kubeworkz/grx930/c930/doc/npu_act_stage_design_note.md

# S_ACT: an activation stage in the c930 NPU

**Status: RTL through gate A2** (§6). `rtl/c930_npu_act.sv` and the S_ACT state
in `rtl/c930_npu_core.sv`, driven directly by `sim/tb_core_verilator.cc` and tied
off in `c930_npu_top`. Next is chain mode, gate A3. No DMA, CSR or firmware
change until A3 has reported.
**Date:** September 2026
**Built against:** the loop-interchange core, now on main (§2 is why that
matters).
**Companions:** grxcp `docs/designs/pta_tpaqcn_review.md` §4.5–6 (why this
experiment exists, and its kill criterion); grxcp
`docs/designs/pta_cpu_integration.md` §3–4 (the CSR plan, the error model, the
determinism rule).

---

## 1. What it is for

One question: **how many all-optical activations can be chained before a
network's output diverges from its digital reference**, as a function of the
photons each activation carries and of fabrication detuning.

That number is the reset interval N, and it bounds everything an all-optical
activation could ever win. With an O-E-O reset every N layers, a layer costs
`E_opt + E_OEO / N`, so the advantage over any O-E-O path is at most N however
cheap the optics get (review §5.2). Nobody has measured N for any material.

It needs no photonics. In emulation an activation is a numerics block: a
transfer curve from the coupled-mode solver, the shot noise its light carries,
a per-unit detuning, and an optional requantisation standing in for the O-E-O
reset. The curve and the noise are hypotheses about published devices; nothing
this stage produces is a statement about one, exactly as
`pta_cpu_integration.md` says of the tile.

---

## 2. Where it goes, and why not where the review put it

The review places S_ACT "between S_WRITE and the next output row". Under the
loop order about to land, that is wrong on every K tile but the last:

```
for nt:                         N tile
  for kt:                       K tile
    S_WLOAD                     load B[kt][nt] once
    for m:                      output row, innermost
      S_AROW / S_ACCLD          wait for A[m]; acc[] <- C[m][nt] when kt > 0
      S_RUN                     accumulate this K tile
      S_WRITE                   C[m][nt] <- acc[]     a partial sum unless kt is last
```

`c_mem` carries the running K accumulation between K tiles, and `S_ACCLD`
restores it before each run. `C[m][nt]` is a complete sum only when `S_WRITE`
runs with `kt_reg == num_k_tiles - 1`. An activation applied any earlier is
applied to a partial sum.

So **S_ACT replaces S_WRITE on the last K tile**, when the stage is enabled:

```
S_RUN --[kt_reg != last  or  !act_en]--> S_WRITE    unchanged
S_RUN --[kt_reg == last  and  act_en]--> S_ACT  --> the row / tile advance S_WRITE performs
```

Three properties make that the right cut.

- **`acc[]` already holds the complete sums** when `S_RUN` exits; `S_WRITE`'s
  store is a plain copy of them. S_ACT reads `acc[]`, which is flops, so
  `c_mem` gains no read port and keeps the one-read, one-write shape the core's
  comment relies on for BRAM inference beside the DMA readback.
- **It writes through `S_WRITE`'s port to the same `c_idx`**, so the DMA's C
  writeback reads activated values with no DMA change at all.
- **With the stage disabled, the FSM is cycle-identical** to the staged core.
  That is gate A0.

Two details in `S_WRITE`'s exit that S_ACT has to inherit rather than
re-derive:

- On a row advance `S_WRITE` clears `acc[]` when `kt_reg == 0`. On a
  single-K-tile GEMM that tile is also the last, so the clear must run *after*
  S_ACT has consumed `acc[]`: the advance logic becomes one block shared by both
  states and runs at their exit.
- `done_cond` is keyed on `state == S_WRITE`. It needs an S_ACT term, or
  `o_done` never fires on an activated GEMM and the bench times out rather than
  failing.

---

## 3. The datapath

Per element, with `j = n_cnt` the physical column (`0 .. nc-1`):

```
stage 1   x  = sat( acc[j] * XS[j] >>> XSHIFT )      table domain; XS[j] = XSCALE * s_j
stage 2   σ  = k_shot * isqrt(|x|)                    shot-noise scale for this element
stage 3   x2 = x + σ * g                              g ~ N(0, 1)
stage 4   y[i], y[i+1] <- BRAM[i], BRAM[i+1]          i = x2's top 10 bits
stage 5   y  = y[i] + ((y[i+1] - y[i]) * f >>> 14)    f = x2's low 14 bits
stage 6   c  = requant ? sat(round(y*r_j / LSB_adc), 2^(B-1)) * LSB_adc : y*r_j
          C[m][n_base + j] <- sat32( c <<< YSHIFT )
```

At most one multiply per registered stage, six stages, with the write index
travelling alongside the data. **Two of them are split for timing, so the
implemented latency `ACT_P` is 8, not 6**: stage 2 into 2a (root and draw) and 2b
(the `k_shot` multiply), and stage 6 into 6a (the `r_j` multiply) and 6b
(requantise, scale, saturate). Both splits were made against a measured path,
not a guess — §5. `nc` elements enter on consecutive cycles, so S_ACT lasts
`nc + ACT_P` cycles per row: the element is registered on entry, and the last
sub-stage is the `c_mem` write itself. The output scale and the table's output full
scale are powers of two, so the output scale and `LSB_adc` both cost shifts. The
detuning's output factor `r_j` is applied before requantisation, because a real
reset digitises what the unit actually emits.

**The fixed point, as built.** The header of `rtl/c930_npu_act.sv` states the
contract, and the harness's `act_element()` implements it; gate A2 holds the two
to bitwise agreement. The choices the stages above leave open:

- `XS[j]` is unsigned, and the stage-1 product is the full 48 × 32 bits.
- `√` is `isqrt4`: a leading-zero count normalises `|x|` to [1, 4), and a
  four-entry table of `2^11·√1 … 2^11·√4` is interpolated on six fraction
  bits. It is within about 1.5 % of the true root, and a scale on shot noise
  needs no more.
- `g` is the sum of the four bytes of one xorshift32 step, less 510, times 443:
  that sum has a standard deviation of 147.8, and 443 / 2^16 brings it to
  0.999. One step per element. So stage 2 carries two small multiplies beside
  `k_shot · √`: the constant 443, and `isqrt4`'s 10 × 6-bit interpolation.
- Stage 3 rounds the noise (`+2^23`, then `>>> 24`); the interpolation and the
  `r_j` product floor; requantisation rounds half up; `YSHIFT` above 32 acts
  as 32. Stage 1, stage 3 and the 32-bit output saturate independently, and
  `o_act_sat_count` counts each event.

**The table.** 1024 uniform segments over the signed 24-bit input, 1025 signed
24-bit breakpoints at `x_i = -2^23 + i·2^14`, in one dual-port BRAM read at `i`
and `i+1` together. The difference needs 25 bits and the fraction 14, so
interpolation is one DSP48 multiply with the pre-adder forming the difference.
The shift floors. `c930/sim/act_table_gen.py`'s docstring is the normative
statement of the format, and its `pwl()` is the reference both the RTL and the C
model must match bit for bit.

The segment count was measured, not chosen. Chord error falls as 1/segments²,
so the generator compares its worst error within two knees against the shot
noise the unit carries there, and rejects a table whose error exceeds a quarter
of σ. Against that test, 64 segments are up to 17× too coarse, for the as-built
unit at a 1 ps clock. 256 still fail that unit (1.18×). 1024 pass every preset
at every clock, worst 0.08×, for the price of a RAMB36 of breakpoints instead of
a RAMB18. So piecewise-quadratic is not needed.

Written through an indirect port while the core is idle. One table per design
point: a curve from the solver — or later from the diffusion model — is data,
not RTL. The physics lives entirely in the generator: whether C is read as
optical power or as field amplitude, and whether the unit outputs the second
harmonic or the depleted fundamental.

**κ only sets the watt scale.** With full scale tied to the knee, the
coupled-mode equations depend on power only through `κ²P`. The generated tables
for the TPA-QCN and compound 4 units at 6 mm are therefore bit-identical, and a
curve's shape depends only on loss × length and mismatch × length. κ reaches the
experiment through one place: the photon count at the knee.

**Detuning.** Physical, so indexed by `j`, not by output index: N tiles reuse
the same columns, and a real tile reuses the same activation units. To first
order a phase-matching detuning scales the efficiency, `η → s·η`, and the
coupled-mode equations then give exactly `f_s(x) = f(s·x) / s` for either
output, loss included (scale the field amplitudes by `√s` and they return to the
nominal equations). Hence `s_j` on the input axis and `r_j = 1/s_j` on the
output, in the table's own encoding — for a field-amplitude table the harness
loads `√s` and `1/√s`. The harness folds `s_j` into the per-column input scale
`XS[j]` and computes `r_j` itself, so the RTL never divides. It draws them from
a strip-width distribution using the published device's measured anchors
(review §5.1): +50 nm of width moves the peak +22 nm against an acceptance of
about 12 nm FWHM, so

```
s(Δw) = sinc²( 1.39 · 0.44·Δw / (FWHM/2) )
```

and 14 nm of width gives `s ≈ 0.5`. A large `Δβ` also caps conversion below one,
which a scale cannot express. §8 records that.

**Noise.** One term in this phase: shot noise on the light entering the unit,
`σ = k·√|x|`, the same form as `PTA_SIGMA_SH`. `k` carries the experiment's main
axis. If the table's knee sits at `x_knee` and the knee carries `n` photons,
then `k = √(x_knee / n)`. For scale, 6.5×10⁵ photons is the 83.5 fJ knee of the
compound 4 unit at 100 fs in review §4.5, and the sweep runs 10³ to 10⁶. The
Gaussian is an Irwin–Hall sum of four uniform draws; `√` is a leading-zero count
and a four-entry interpolation LUT; both as `pta_cpu_integration.md` §4.3
specifies. The `√|x|` form holds when the table reads C as optical power. For a
field-amplitude table shot noise is constant in `x` (it is `√P` on `P = x²`),
which the same stage produces with the square root bypassed to the constant
2^12, selected by `i_act_noise_const`. The generator emits `i_act_k_shot` for
both cases at every photon count it is asked for.

The tile's own impairments — weight programming, crosstalk, thermal noise,
drift — belong to PTA phase C1 and are **not a dependency**. S_ACT measures the
activation chain's contribution on an exact digital MAC, and borrows C1's
primitives once they exist rather than waiting for them.

**Determinism.** The draws come from xorshift32 (shifts 13, 17, 5), the
generator `sim/tb_core_verilator.cc` already uses for its operands. It costs a
few dozen flops and XORs in RTL, and it is loaded from a seed at `i_start`. The
FSM fixes the draw order: `nt`, then `m`, then `j`, on the last K tile only. A C
reference that consumes draws in that order makes RTL parity a bitwise question,
which is the rule `pta_cpu_integration.md` §4.3 sets for every stochastic term.

**Requantisation.** The stand-in for an O-E-O reset: round and saturate to
`B_adc` bits over the table's output range — the `d_j` expression of
`pta_cpu_integration.md` §4.3. It is **per GEMM**, not a period. The core does
not know which layer a GEMM is, and a queue need not hold one network's layers
in order, so a counter inside the NPU would be a guess. The harness sets it on
every N-th layer.

**Readback.** `o_c_rdata` truncates `c_mem` to 32 bits. S_ACT saturates to 32
bits and counts it, so an activated value can never wrap silently on the way
out.

**Precision scope.** INT8 and INT16 operands only. FP16 and BF16 accumulate
normalized FP32, and a table over those codes is a separate design. `act_en`
with an FP precision raises `o_error` at start, the same way an out-of-range
dimension does.

---

## 4. Ports

Core-level. Every scalar is sampled at `i_start`, like `i_precision`.

| Port | Width | Meaning |
|---|---|---|
| `i_act_en` | 1 | route the last K tile through S_ACT |
| `i_act_requant` | 1 | this GEMM is an O-E-O reset |
| `i_act_adc_bits` | 4 | `B_adc` for requantisation |
| `i_act_xs` | 32 × NUM_COLS | per-column input scale `XSCALE · s_j` |
| `i_act_xshift` | 6 | `acc` → table domain |
| `i_act_r` | 16 × NUM_COLS | per-column output factor `r_j`, Q4.12 (so `s ≥ 1/16`) |
| `i_act_yshift` | 6 | table output → C, a power-of-two scale |
| `i_act_k_shot` | 16 | `k`, Q8.8; 0 disables noise |
| `i_act_noise_const` | 1 | constant σ, for field-amplitude tables |
| `i_act_seed` | 32 | xorshift32 seed |
| `i_act_tbl_wen`, `_waddr`, `_wdata` | 1, 11, 24 | breakpoint write, idle only |
| `o_act_count` | 32 | elements activated |
| `o_act_sat_count` | 32 | saturations, table domain and 32-bit readback |
| `o_act_cycles` | 32 | cycles spent in S_ACT |

`o_act_cycles` is honesty instrumentation, not a diagnostic.
`doc/c930_architecture.md` decomposes `CYCLE_COUNT` into weight movement,
`S_RUN` and `S_WRITE` with an exact identity; the interchange already makes that
identity stale, and S_ACT adds a term. The counter is what lets it close again.

**When this reaches the CSR** it goes into the widened decode
`pta_cpu_integration.md` §3 proposes. This paragraph used to say the PTA block
ends at `0xCC`, leaving twelve words at `0xD0`-`0xFC` for the scalars and
counters with the table and the scales behind an indirect address. Half of those
twelve had been taken by the time A-CSR was built -- `DRIFT_MAX`, `CAL_CFG`,
`TRIM`, `CAL_SEED`, `ERR_FOUND` and `AROW_CT` -- so what shipped is three scalar
words (`0xE4` CFG, `0xE8` SEED, `0xEC` CTRL) plus **one** indirect window
(`0xF4` IADDR, `0xF8` IDATA) carrying everything that is not a scalar: the
per-column scales, the 1025-entry table and the three counters, selected by
`IADDR[13:12]`. `0xFC` is left spare on purpose.

Two properties of that window are worth stating because firmware has to know
them and neither is obvious from the map. **The auto-increment is write-only**:
writing IDATA advances IADDR, so a run of entries is one address write and n data
writes, but reading IDATA does not advance it and a readback re-addresses every
entry. And **the table is write-only from the host**, because the core owns its
only read port and S_ACT reads it combinationally.

`i_act_requant` is the exception, because it is per command. A live CSR bit
would apply to whichever command dispatched next — the live-versus-snapshot
hazard the CSR header's completion contract exists to prevent — so it belongs in
the command snapshot beside `precision`, taking `CMD_W` from 147 bits to 148.
Being in the snapshot is not enough on its own: it has to be **latched out of the
snapshot at dispatch**, like every other field, and the first implementation read
it live off the FIFO head instead. §7.4 has what that cost.

---

## 5. Cost

**Cycles.** S_ACT's `nc` writes replace `S_WRITE`'s on the last K tile, so a
GEMM pays `M · Nt · P` extra cycles. At `M=64, N=8, K=256` that is 384 cycles
against 71,734.

*Gate A1 encodes that as an equality, and what it was telling us was mostly
right.* Measured at `ACT_P = 7`, before the stage-6 split, a GEMM paid **+98**
cycles where `M · Nt · P` was 112 for `M=8 N=12 K=8`, and 38 against 42 for
`M=3 N=12 K=2` — 13 failures, and the same 13 on the unmodified stage, so not a
regression. It was tempting to call the bench mis-specified and move on. Taking
the cut settled it the other way: at `ACT_P = 8` those same shapes pay **exactly**
`M · Nt · P` (+128 of 128, +48 of 48) and A1 is down to **5 failures**, all of
them ±1 cycle and all on shapes where `N` is not a multiple of `NUM_COLS` or
`M` is 1:

| shape | paid | `M · Nt · ACT_P` |
|---|---|---|
| `M=8 N=12 K=16` | +128 | 128 ✓ |
| `M=8 N=12 K=8` | +128 | 128 ✓ |
| `M=3 N=12 K=2` | +48 | 48 ✓ |
| `M=5 N=11 K=8` | +79 | 80 |
| `M=1 N=12 K=16` | +17 | 16 |
| `M=8 N=9 K=16` | +127 | 128 |

`act_cycles` agrees exactly in every case, before and after (208/208 then
224/224), so the stage's own accounting was never in doubt.

**A1 is green now, 14 of 14, and the residue was not an off-by-one.** Two
readings of it were wrong before the third stuck: that the bench was
mis-specified and carried no information, and then that the residue was a
boundary effect on a ragged last tile. Six cases were not enough to tell; the
sweep's fourteen sort perfectly by the **parity of the unactivated cycle count** —
nine even baselines, every one exact, and five odd, every one out by a cycle.

`hop_phase` is a free-running toggle from reset and `S_RUN` advances only on its
edges, so S_RUN's length in cycles depends on the phase it is entered at.
Enabling S_ACT lengthens each last-K-tile store by `ACT_P` and shifts that phase
for everything after it, and a later S_RUN is sometimes entered off-phase and
runs a cycle longer. Both of A1's equalities were then impossible, for the same
reason:

- the **cycle** equality, because `ACT_P` is even, so `off + M · Nt · ACT_P`
  keeps the baseline's parity while an activated total is always even — 14 of 14
  measured;
- the **`OP_COUNT`** equality, because `doc/c930_architecture.md` defines
  `OP_COUNT / (NUM_ROWS · NUM_COLS)` as the S_RUN cycle count, so the counter
  reports that same extra cycle as exactly one array pass of MACs — ±64, always
  with the same sign as the cycle.

Neither the design nor the counters are wrong. The gate asserts the true
relationship now: the activated total is even, within one cycle of
`M · Nt · ACT_P`, that cycle only on an odd baseline, and `OP_COUNT` moving with
it by one array pass in the same direction. **Its ablation:** setting the
bench's `ACT_P` to 7 against the RTL's 8 fails all fourteen cases, where the old
form could not distinguish a latency error from the alignment on five of them.
So the gate is stricter than it was, not looser.

**Area — measured.** A-synth, C4(b), 2026-09-24: `c930_npu_act` alone, out of
context on `xc7a200tfbg484-1` through synthesis, placement and routing with a
10 ns clock (`make -f` nothing; `bash synth_xilinx/run_ooc_c4b.sh act`).

| | estimated above | measured |
|---|---|---|
| LUTs | ~2,000 | 1,701 cells |
| DSP48E1 | 5 | **13** |
| RAMB | 1 | **4** (3 tiles routed) |
| FF | — | 775 |
| CARRY4 | — | 120 |

The LUT estimate held. The DSP count did not: "five multiplies" counts the
multiplies in the arithmetic, not the DSP48E1s Vivado spends on them — the
48-bit stage-1 product and the 64-bit stage-6 shift each take more than one.
Nor did the BRAM: 1025 entries of 24 bits is one RAMB36 of data, but the bench
reads two adjacent entries every cycle and writes a third port while idle, and
that is built from four.

**Timing — measured, and it does not close.** The claim above is true and was
answering a different question. S_ACT does not lengthen the PE path; it is its
own path, and nobody had timed it:

| | WNS at 10 ns | Fmax | worst path | levels |
|---|---|---|---|---|
| as written | −14.286 ns | **41.2 MHz** | `col5_reg[1]` → `o_sat_count_reg[31]` | 37 |
| stage 6 shortened | −9.539 ns | **51.2 MHz** | `col5_reg[2]` → `o_sat_count_reg[29]` | 27 |
| stage 6 split, `ACT_P` 8 | −8.016 ns | **55.5 MHz** | `xs_r_reg[6][0]` → `x1_reg[7]` | 28 |

141 of 504 endpoints failed in the first. The cone is stage 6, which in one
cycle did: an 8:1 mux selecting `r_r[col5]` (which is why the path starts at a
`col5` bit), a DSP multiply, **three variable shifts** including a 64-bit one, a
clamp against bounds recomputed from `adc_bits` every cycle, two 64-bit
comparators, and the saturation counter's accumulate hanging off the end.

Nobody had named it. `pta_cpu_integration.md` §6.1 named the shot path — "a
multiply, a square-root approximation and two adds" — and the program plan named
stage 1's wide multiply. **The plan's guess was right and mine was wrong about
it:** once stage 6 is split the path moves to exactly where the plan said,
`xs_r_reg[6][0]` → `x1_reg[7]`, the 48 × 32 product with its variable `XSHIFT`
and `sat24`, 18.0 ns over 28 levels. It was second in the queue, behind a stage
that no estimate mentioned. §6.1's shot path has still not bitten.

Shortening it cost no latency and no accuracy. `sh`, the round addend, the
quantiser mask, the clamp bounds and the capped `YSHIFT` all come from the
configuration, which is sampled at `cfg_load`, so they are registers now. And
two of the three shifts cancel: `(x >>> s) <<< s` clears x's low s bits, which
is an AND with a mask, and a clamp commutes with a monotone left shift, so the
bounds are held already shifted. One variable shift is left.
`sim/act_stage6_equiv.py` checks the two forms agree over 99,900
combinations of `adc_bits`, `YSHIFT`, `requant` and operands, including the
29-bit wrap the intermediate width allows; gate A2 agrees in RTL, saturation
counts included. `ACT_P` is still 7.

**The cut, taken.** 51.2 MHz is not 100 MHz and the rest needed latency. The
measured path was 19.5 ns over 27 levels, so stage 6 splits after the multiply:
**6a** is the `r_r[col5]` mux and the DSP product — the DSP48E1 carries its own
output register, so this costs only the pipeline slot — and **6b** is the mask,
the clamp, the shift and the saturate. `ACT_P` 7 → 8. The saturation counter
moves to 6b with the data, so each element is still counted once, and gate A2
passes unchanged with the counts exact.

**Measured: 55.5 MHz, and stage 6 is no longer the limit.** The split cost 59
flip-flops (846 → 905) and nothing else — 1,713 LUT cells, 13 DSPs, 4 BRAMs, the
same as before. The worst path is now stage 1, so a third split of stage 6 would
buy nothing; the next cut, if 100 MHz is wanted, is **stage 1 into 1a/1b**, and
the same trick may apply first, since `XSHIFT` is configuration and the `sat24`
bounds are constants.

**There is a floor to chasing this.** The digital NPU with its systolic array
routes at 58.0 MHz, limited by the FP16 accumulator chain between PEs, and a SoC
runs no faster than its slowest block. S_ACT at 55.5 MHz is still the binding
constraint, but only by 2.5 MHz — past that, work on this stage buys nothing
until the array's own path is addressed.

A cut goes into `ACT_P` and, where they apply, `PTA_TS` and §2.1's model, never
around them (program plan §5). `ACT_P` is updated in `c930_npu_core.sv` and in
`sim/tb_core_verilator.cc`, the two places that hold it. `PTA_TS` is the *tile's*
modelled shot latency, not this stage's, and §2.1's cost model has no S_ACT
term — so neither moves for this cut, which is said here rather than left as a
silence.

---

## 6. Gates

Each can fail, and each names its ablation, in the style of
`pta_cpu_integration.md` §6.

**A0 — disabled is invisible.** `i_act_en = 0`: all 14 cases in
`sim/tb_core_verilator.cc` pass with C, `CYCLE_COUNT`, `OP_COUNT` and
`STALL_COUNT` identical to the staged core. *Ablation:* route a disabled GEMM
through S_ACT anyway; the cycle count must move.
*Met:* the harness's output is byte-identical to the same harness on the core
without S_ACT. The ablation is A1's cycle check, which sees the move.

**A1 — identity is exact.** `act_identity.hex`, noise off, `s = r = 1`,
requantisation off, unit scales: C bit-identical to the harness's `cref` at
every shape of the INT8 build, and `CYCLE_COUNT` equal to the A0 figure plus
`M · Nt · P` exactly, closed by `o_act_cycles`. The identity table is exact
below its top segment, `x < 2^23 - 2^14`, and an INT8 sum at `K = 256` reaches
at most 4,194,304, so no scaling is needed and none can hide an error. The
generator's self-test checks both facts. *Ablation:* move one breakpoint by one
LSB; the bench must name the element.
*Met* at all 14 shapes: C bit-identical, `CYCLE_COUNT` up by exactly
`M · Nt · 6` (384 at `M=64, N=8, K=256`, on 71,168 in this core-only harness),
`OP_COUNT` and `STALL_COUNT` unchanged, `o_act_cycles` equal to
`M · Σ(nc + 6)`. Enabling S_ACT with FP16 or BF16 raises `o_error` at start,
and the next valid start clears it. The ablation has a direction: the
interpolation floors, so one LSB *added* to an identity breakpoint is absorbed
by every input except one exactly on it, while one LSB *taken off* moves both
neighbouring segments. `--perturb` subtracts, and the bench names each moved
element with its sum.

**A2 — RTL and C agree bitwise.** A solver-derived curve with noise, detuning
and requantisation all on, fixed seed, every shape: a C reference added beside
`cref` matches `o_c_rdata` bit for bit. *Ablation:* change one xorshift shift in
the RTL; parity must fail on the first activated element.
*Met* at all 14 shapes on the compound 4 unit's second harmonic, power encoding:
every element moved off its sum, requantisation on alternate cases, constant σ
on three, and two cases run hot enough to saturate (7 and 14 events), their
counts equal to the model's. The ablation (shift 13 → 12) fails
10 of the 14 shapes. In the other four the changed noise never reaches C: 6-bit
requantisation, or the flat foot of a second-harmonic power curve, absorbs it —
so "the first activated element" is too strong a promise for this operating
point, and the gate is per shape.

**A3 — the measurement, reported rather than gated.** A `--chain` mode in the
harness runs L layers, feeding each activated C back as the next layer's A
through a fixed shift, with requantisation every N layers. Sweep
`N ∈ {1, 2, 4, 8, ∞}` × photons at the knee `10³ … 10⁶` × width σ
`∈ {0, 7, 14} nm` × curve shape, and report divergence from the noiseless
digital chain against depth. The shape axis is short, because κ drops out of it:
loss × length, output (ff or sh), and encoding. The four presets span only three
loss budgets. Synthetic weights come first, from the same xorshift stream, so
the mechanism is measured before any dataset is involved. The small MLP
`pta_cpu_integration.md` §9 asks for comes second. The output is the
N-versus-photons curve review §5.2 needs, and it is what the kill criterion in
review §6.2 is evaluated on.

---

## 7. Order

1. ~~**Land the interchange.**~~ **Done**, on main, with main reconciled first.
   Landing it also fixed two float bugs and a DMA abort bug; see the commits.
2. ~~**Table generator.**~~ **Done:** `c930/sim/act_table_gen.py`, standard
   library only. It ports the RK4 coupled-mode integrator from grxcp's
   `pta_tpaqcn_measured.py`, adding a complex path for phase mismatch, so the
   tables and the review's energy analysis share one set of physics. Its
   self-test checks the lossless closed form, power conservation under
   mismatch, the knees of all four presets against the review, identity
   exactness and determinism. `--all` writes every preset in both outputs and
   both encodings to `c930/build/act_tables/`, in eight seconds, byte-identical
   run to run. Each `.hex` is a `$readmemh` image; each `.json` records the
   design point, the knee, the interpolation error, and `i_act_k_shot` against
   photon count, with the error-over-σ check. `--compare-seg-bits` reproduces
   the segment-count evidence in §3.
3. ~~**RTL and C reference**, through gates A0, A1 and A2, in that order.~~
   **Done:** `rtl/c930_npu_act.sv`, the S_ACT state, and `--act identity` and
   `--act full` in `sim/tb_core_verilator.cc`.
4. ~~**Chain mode**, A3.~~ **Built, 2026-10-01**, and measuring: `--act chain`
   in `sim/tb_core_verilator.cc` with `sim/act_chain_sweep.py` driving the sweep.
   Five things came out of building it, and four are about the experiment rather
   than the device.  Re-measured 2026-10-01 after the harness fault in 7.2:
   400 points, no exclusions, and 7.3 reading 2 withdrawn.
5. ~~**Only then** the CSR mapping, the snapshot bit and firmware.~~
   **Done, 2026-10-01**: `rtl/c930_npu_csr.sv`'s scalar words and indirect
   window, `o_act_requant` riding the command snapshot, and `sw/act_csr.c` with
   `make act_csr` as its gate. §7.4 -- the firmware found two bugs, one of
   them in the snapshot path the order exists to protect.

---

## 7.1 What building A3 settled, and what it caught

**The harness is sound, and this is the check that says so.** With sigma = 0 and
`k_shot` = 0 the measured chain and the reference agree **exactly**, at every
depth: relative RMS 0.000000 through twelve layers. Anything else would mean the
chain itself was wrong before any physics entered.

**The operating point is not free, and the first version had it wrong.** A photon
count means *photons at the knee*, and `k = sqrt(x_knee / n)` is defined there,
so the activation's input has to land near the knee or the sweep's main axis is
mislabelled. The generator records `x_knee_table_units` = 2^21 with full scale at
four knees. Stage 1 computes `x = acc * XS >>> XSHIFT`, so at `XSHIFT` = 0 the
scale is `XS` itself; with operands and weights uniform on [-7, 7] and K = 8 a
typical `|acc|` is about 53, and `XS` = 2^15 puts that at 0.83 of a knee. The
first version inherited A2's gate scale, which sits far below the knee at this
shape, and reported 19% relative noise at depth 1 for what it labelled 10^5
photons. That was the label, not the device.

**The transport shift is measured, not chosen.** C maps into the next layer's A
by one right shift, elementwise, which is why the chain runs N == K. Only
**>>16** is this chain's fixed point: the activated C has an RMS of 277k at depth
1, and 2^16 is the only power of two returning operands that reproduce it. The
chain then settles at ~434k by depth 6 and holds through 12 with no saturation,
which puts `x` at about 1.25 knees. Shifts of 14 and below **pin the output at
full scale**, which looks stationary and is not; 18 collapses the chain to zeros
by depth 3, where the divergence reads a meaningless 0.000000. The window is
barely one bit wide because a knee makes loop gain steep in amplitude, and that
is a property of the activation rather than of the harness. Section 8 item 3
warned the transport rule could mix into the depth axis; it is narrower than that
warning implies.

**One seed is not a measurement, and the first version of this got the reason
half right.** The detuning draw is `NUM_COLS` = 8 wide. At sigma 7, 10^3 photons,
against a calibrated reference, the relative RMS at depth 6 ranged **0.056 to
0.284 across five seeds** -- a five-fold spread, wide enough that a single draw
inverts the sigma ordering. So sigma > 0 was run over five seeds.

Sigma = 0 was not, on the reasoning that it has no detuning draw. That reasoning
is wrong: a seed draws the **weight set** and the operands as well, and the chain
holds one weight set for its whole length, so a draw of B is a draw of the map
being iterated. Measured at sigma = 0, `c4-5db-6mm` power, 10^5 photons, N = 1:
the depth reads 3, 2, 2, held, 2 over seeds 1 to 5 and the final relative RMS
0.186, 0.239, 0.343, 0.000, 0.000. That spread is wider than the one across the
whole reset axis. **Every** row now runs five seeds.

**The sigma axis needs two references, and the literal one hides the device.**
Against the ideal unit (`s` = 1) -- which is what "divergence from the noiseless
digital chain" says literally -- a detuned chain reads **25% at sigma 7 and 57%
at sigma 14 from depth 1, flat with depth**. That is a fixed transfer-function
difference, not an accumulating one, and it swamps the photon axis so completely
that every sigma > 0 cell reads depth 1 regardless of photons or reset interval.

That number answers section 8 item 4 -- *does a scale model detuning well
enough?* -- with a quantified **no, not at the knee**. `f_s(x) = f(s*x)/s` is
exact for an efficiency change, and the knee is precisely where the curve's shape
matters. Far below the knee the same measurement gives 0.3%.

So `--chain-cal` gives the reference the **same** detuning, making the divergence
the stochastic part alone. That is what "how many activations can chain" means
for a device whose fixed gain errors have been calibrated out, and the tile has
gain and offset correction with phase C3's engine behind it. Both references are
reported; neither is the whole answer.

## 7.2 What A3 caught, which was its own harness

**There is no RTL bug here, and A2's gate does not need reopening.** This section
said twice that there was, and both were wrong. The 64 runs of the full sweep
that failed the per-layer bitwise check failed because of the chain harness, not
the activation stage.

**The mechanism.** `a_mem` holds `DIN_W`-wide operands, and the bench runs
`DIN_W = 8`, so an operand's range is [-127, 127]. The chain's transport wrote
`C >> 16` into it as a plain `int`. Once the chain's magnitude grew enough for
that to pass 127, Verilator truncated it into the 8-bit port while this harness's
own reference kept the full value, and the two diverged. The transport now
saturates into the operand width, which is what a real system would do with an
activation its next layer cannot represent, and every case passes.

**What the evidence looked like, in case the shape recurs.** Four things pointed
away from the RTL and were all consistent with the harness:

- Divergence starts at **layer 4** and never earlier, which is where the
  magnitude crosses the operand range -- not where anything in the datapath
  changes.
- It reaches **only the amplitude encoding**, whose `1/sqrt(s)` output gain puts
  the chain's fixed point near 1.9M against the power encoding's 434k. Power's
  operands stay inside the range and power never failed.
- `k_shot = 0` fails identically, so noise and the RNG stream were never in it.
- Clamping the transport clears every failure, and reports that 49 operands
  needed saturating over twelve layers.

Saturation inside the activation **correlated** and that is all. Both the
saturation count and the divergence are symptoms of a chain running hotter than
its operand width; neither causes the other.

**Two mechanisms published here and withdrawn,** recorded because each looked
convincing:

1. *`f(x) * r_j` overflowing the output stage once `r_j` reaches Q4.12's limit,
   with `yshift` as the remedy and therefore A-CSR's decision.* `YSHIFT` is a
   **left** shift (§3's stage 6 is `C <- sat32(c <<< YSHIFT)`), so it amplifies and
   could never buy headroom; and stage 6a holds the product in 29 bits signed
   where `y * r >> 12` peaks at 2^27. Neither half survived reading the RTL.
2. *Stage 4 reading one past the table.* `u = x2 + 2^23` is in [0, 2^24-1], so
   `u >> 14` is at most 1023 and `T[(u >> 14) + 1]` at most `T[1024]`, which a
   1025-entry table has. In range.

**One real bug did come out of looking, and is fixed.** Q4.12's largest
representable value is 65535/4096 = 15.9998, **not** 16, so `s` = 1/16 exactly
needs `r_j` = 65536, which wraps a `uint16_t` to **zero** and silently turns that
column off. §4's "Q4.12 (so `s >= 1/16`)" is right about the format and off by
one at the boundary: the smallest usable `s` is 4096/65535. That bound applies to
anything programming `i_act_r` from a reciprocal, which now includes the CSR path
(A-CSR).

**Re-measured, and the fix is a no-op outside the cells it was excluding.**
Counted directly: the transport clamps **zero** operands for all three power
presets, at every photon count, at sigma 0 and sigma 14 alike; it clamps 26 to 28
at `c4-5db-6mm` amplitude with sigma 14, and zero there at sigma 0. So the clamp
could only have moved the amplitude-at-sigma>0 cells, which are exactly the 64
that were excluded, and every other number in §7.3's first version stood as
measured. The re-run is in §7.3: 400 points, **no exclusions**.

It also found that the fix was not what needed finding most. §7.3's reading 2
was wrong, and wrong on data that had been in hand all along.

Also worth keeping: a chain that saturates its operands is a real condition, and
the harness now reports how many it saturated. At the amplitude encoding's fixed
point it is 49 operands over twelve layers, which says that encoding runs close
to what an INT8 datapath can carry.

---

## 7.3 A3's curve, re-measured

`python3 sim/act_chain_sweep.py --layers 12`. **400 points, no exclusions**, every
layer bitwise against the C reference, five seeds on every row. This replaces a
first version whose sigma = 0 row ran one seed (§7.1) and whose reading 2 was
wrong (below).

The depth the chain reaches before 5% relative RMS, at sigma = 0, in the sweep's
own notation: the median over five seeds, the range across those seeds in
brackets where it differs, `-` for "held all twelve layers", and `*n` for n seeds
whose chain reached a fixed point inside the run.

| photons | N=1 | N=2 | N=4 | N=8 | N=inf |
|---|---|---|---|---|---|
| **`tpaqcn-built-2mm` power** -- 2 mm, the built device | | | | | |
| 10³ | 2(1-2)*1 | 2(2-4) | 2(2-3) | 2(2-3) | 2(2-3)*1 |
| 10⁴ | -(2--)*1 | 6(2--) | -(3--) | 7(3--) | 7(3--)*1 |
| 10⁵ | -*1 | - | -(3--) | -(3--) | -(3--)*1 |
| 10⁶ | -*1 | - | -(3--) | -(3--) | -(3--)*1 |
| **`c4-5db-6mm` power** -- 6 mm | | | | | |
| 10³ | 2(1-2)*1 | 2(2-4) | 2(2-3) | 2(2-3) | 2(2-3) |
| 10⁴ | 2(2--)*1 | 2(2-10) | 4(3-8) | 8(3-10) | 8(3--) |
| 10⁵ | 2(2--)*1 | 10(4--) | 10(8--) | -(8--) | -(8--) |
| 10⁶ | 4(3--)*1 | -(8--) | - | - | - |
| **`c4-5db-6mm` amplitude** -- the same device, read as amplitude | | | | | |
| 10³ | 1 | 2 | 2 | 2 | 2 |
| 10⁴ | 1 | 2(2-4) | 3(2-4) | 3(2-5) | 3(2-5) |
| 10⁵ | 3(1--) | 3(3-4) | 4(3--) | 4(3--) | 4(3--) |
| 10⁶ | -(2--) | 4(3-7) | 4(4-9) | 8(4--) | 8(4--) |
| **`tfln-1cm` power** -- 1 cm | | | | | |
| 10³ | 1(1-2)*1 | 2 | 3(2-4) | 3(2-5) | 3(2-5) |
| 10⁴ | 2(1-8)*1 | 4(2-12) | 3(3-9) | 3(3-9) | 3(3--) |
| 10⁵ | -*1 | 10(4--) | 5(3--) | 6(3--) | 6(3--) |
| 10⁶ | -*1 | -(4--) | 12(3--) | 9(3--) | 9(3--) |

The grid is printed rather than collapsed into a range across N, because
collapsing it is what hid reading 2's error. The sigma 7 and sigma 14 tables are
in the sweep's own output, against a calibrated reference.

**Five readings, in the order they matter.**

**1. The reset interval does not matter for N >= 2.** In every one of the
sixteen cells above, the seed ranges for N = 2, 4, 8 and infinity all **overlap**.
Nothing in A3 distinguishes them, and the medians that do differ (`c4-5db-6mm`
power at 10⁵ reads 10, 10, held, held) differ by less than one seed's draw.
The chain is photon-limited and loss-limited, and the requantisation interval is
not a design variable above 1.

**2. N = 1 is categorically different, and the reset's error is
all-or-nothing.** This is the correction. The first version of this section said
requantising every layer was *actively harmful* and the worst column everywhere.
It is not. At the top of the photon axis N = 1 is sometimes the **best** column,
holding all twelve layers where N = infinity reaches 6 to 9 (`tfln-1cm` at
10⁵ and 10⁶, `c4-5db-6mm` amplitude at 10⁶) -- and at the same photon
counts on another device it is the worst, reaching depth 2 and 4 where
N = infinity holds
(`c4-5db-6mm` power). Which one it is does not follow the photon count or the
loss budget.

What it actually does is remove the middle of the distribution. Over the 80
sigma = 0 runs at N = 1 -- four shapes, four photon counts, five seeds -- the
final relative RMS is **exactly zero in 40 and at least 5% in the other 40, with
nothing in between**; the smallest non-zero reading in the whole column is 0.088.
The same 80 runs at N = infinity give **no** exact zeros and 34 readings inside
(0, 0.05). The mechanism is the ADC: 6 bits on a 24-bit table is an LSB of 2^18,
shot noise here is a few thousand table units, so a requantised layer almost
always rounds to the code the clean chain rounds to and the error is *nothing* --
and when it does not, the error is a whole code at once.

So the reset is a **regenerator with a cliff**, not a safety net that trades
accuracy for stability. Designing for N = 1 means designing to stay under the
code-flip threshold, and under it the chain is exact to any depth. Over it, the
first flip is already 9% or more. One consequence for this table: *depth at 5%*
cannot resolve the N = 1 column at all -- with the smallest non-zero reading at
1.8x the threshold, that column reports the depth of the first code flip and not
a knee.

**3. The crossover is 10⁴ photons at the knee, and it moves with length.**
Unchanged, and the clearest thing in the table. At N = 4 the 2 mm device goes
2 -> held across 10³ to 10⁴; `c4-5db-6mm` goes 2, 4, 10, held; `tfln-1cm`
goes 3, 3, 5, 12 and so needs ten times the photons for the same depth. That is
the shape axis doing what §5 says it is for -- a curve's shape depends on
loss × length, and kappa reaches the experiment only through the photon count at
the knee.

**4. Power chains deeper than amplitude.** The same device at N = infinity:
power reads 2, 8, held, held across the photon axis where amplitude reads 2, 3, 4,
8. §8 item 2 asks whether power or amplitude describes the network; for chain
depth the answer is power. Amplitude's loaded scale is `sqrt(s)`, so `x` lands
higher for the same detuning and the curve's top is reached sooner -- which is
also why amplitude is the encoding whose operands outgrew `DIN_W` and produced
§7.2's 64 exclusions.

**5. So the branch is open at the high end, conditionally.** At 10⁵ to
10⁶ photons with power encoding, chains of 5 to 12 layers hold at any
N >= 2, and the 2 mm device holds all twelve. That is a **long** reset interval,
and `pta_cpu_integration.md` §4.4 makes a long one the trigger for its reopening
clause: the chi(2) platform starts to matter and poled lithium niobate leads
there. At 10³ it is 1 to 3 layers and the branch closes, with the mainline's
electronic nonlinearity untouched. Both of §4.4's branches are live, and the
photon budget picks between them.

**What bounds this experiment, measured.** 44 of the 240 cells contain exactly one
seed -- never more -- whose chain reached a fixed point before layer 12: the
reference chain's own RMS stops changing and both chains sit on the same
attractor, so they agree exactly and the threshold never trips. That is the held
weight set, not the device. The chain holds one weight set deliberately (redrawing
B every layer would mix a new operand distribution into the depth axis), a
deterministic map on a finite operand set must cycle, and the depth it lands on
moves with the seed: `c4-5db-6mm` power at 10⁵ pins at layer 8 on seed 1 and
never on seeds 2 to 5. The bench reports it as `ref_pin` and the sweep marks the
cell, because a median drawn partly from a stopped run is a lower bound. It also
says what A3's first stage cannot reach: past roughly depth 8 at N = 1, a held
weight set stops being a model of a network, which is the second stage's job
(`pta_cpu_integration.md` §9, needs D3).

Two conditions on reading 5 as a result. It holds against a **calibrated**
reference at sigma > 0: uncalibrated detuning costs 25 to 57% from depth 1
(§7.1), so a long chain assumes the gain errors are corrected, which the tile
can do and C3 built the engine for. And these are synthetic operands from the
xorshift stream, which is deliberate -- the mechanism before any dataset.

---

## 7.4 A-CSR's firmware, and the two bugs it found

`make act_csr`. `sw/act_csr.c` drives the whole activation from the host -- the
1025-breakpoint table and the per-column scales through the indirect window, the
configuration through the scalar words -- and the gate is **A1's, repeated through
the CSR**: with the identity table and unit scales, C must come back exactly as it
does with S_ACT disabled. Every operand is 1 and K = 16, so that value is 16.

A1's check is the right one to repeat because it fails on every way the window can
be wrong -- a region decode landing in the wrong memory, an auto-increment that
skips or repeats, a breakpoint truncated through `[23:0]`, a scale written to the
wrong column -- and all of those survive a readback-only test. Twelve points, each
PASS or FAIL:

| | what it says | why it needs firmware |
|---|---|---|
| scalars | CFG, SEED and CTRL read back | -- |
| IR_XS | a distinct scale per column | the write-side auto-increment |
| IR_R | the same, 16 bits wide | the narrower region's truncation |
| index >= 8 | an index past `NUM_COLS` is dropped | the RTL's guard, never shown to hold |
| IR_TBL read | the table reads as 0 from the host | and so a dropped write is **not** visible |
| identity | C is exactly K through the CSR | the whole path at once |
| counters | activated 96, saturations 0, S_ACT cycles 224 | `IR_CNT`, and the cycle identity |
| busy drop | a breakpoint write while the core runs is dropped | not observable any other way |
| idle write | the same write, idle, moves C to 1015 | without it the point above passes on nothing |
| requant | one GEMM, unqueued, comes back requantised | the control for the point below |
| snapshot | REQUANT rides the queue entry | two commands, one register |
| r = 65536 | Q4.12 stores 0, not 16 | the trap §7.2 found, on this path too |

**Two of those are pairs on purpose.** Busy-drop is a claim that a write did
*not* happen, which passes just as well on a write path that never worked, so
idle-write makes the same write with the core idle and requires C to move.
Snapshot is a claim about two queued commands, which cannot distinguish the queue
losing the bit from requantisation not running at all, so the requant point runs
one unqueued GEMM with the bit set. Both halves are needed, and in the second
case the second half is what localised the bug.

**Bug 1: `o_act_tbl_wen` was never de-asserted.** It is set in the IR_TBL write
handler and was cleared only in the reset block -- missing from the
`// The strobes are one cycle each` list beside `pta_now_q`, `pta_mrst_q` and
`pta_aff_wen_q`. So after the first breakpoint write it stayed high for ever,
rewriting the last address with the last data every cycle. The table still loads
correctly, which is why the lint was clean and a readback would have passed: the
addresses and data written are right, there are just unboundedly many redundant
writes after them. What it breaks is the rule the port exists for. "Idle only"
was enforced by `if (!i_busy)` gating the *set*, and once the enable is already
high that gate reaches nothing: the write port is held enabled while S_ACT reads
the table combinationally, which is the read-during-write case the design says it
avoids.

**Bug 2: `o_act_requant` was read live off the FIFO head.** Every other field of
a command is captured into a `cur_*` register when the dispatcher takes the
entry -- dims, bases, precision. requant alone was a continuous
`assign o_act_requant = fifo_head[CMD_W-1]`, and that does not survive dispatch
for two separate reasons:

- `fifo_pop` and `start_pulse` are both registered, so in the cycle the core sees
  `i_start` the read pointer has **already** advanced and `fifo_head` is the next
  entry. The core samples the following command's bit, or an empty slot's.
- and the zero-bubble path dispatches straight from the live CSRs without pushing
  at all, where `fifo_head` was never this command's entry in the first place.

Measured before the fix: two GEMMs queued with REQUANT flipped between them both
came back **unrequantised** -- the first took the zero-bubble path and read a
stale slot, the second was popped a cycle before its own start. Latched with the
other fields now, and from the live register on the path that dispatches from
live registers.

That is the bug the step existed to find. Being in the command snapshot is what
§4 asked for and it was there; carrying it to the core was a separate thing, and
nothing before this firmware had ever read the bit back out.

**What the snapshot turned out to be, once it worked.** §4 calls
`i_act_requant` snapshotted at `i_start`. The implementation is stronger: the bit
is captured when the command is **pushed**, so no later write can reach it. At
`adc_bits` = 6 the requantiser computes `((16 + 2^17) >> 18) << 18` = 0, so the
pair of queued GEMMs reads 16 and 0. The harness seeds the C blocks with a
sentinel rather than zero, because a GEMM that never ran would otherwise pass the
half that expects zeros.

---

## 8. Open questions

1. **Where does the noise enter?** Photon statistics apply to the light at every
   stage; this phase puts them at the unit's input. A pumped unit — the only kind
   with gain — adds noise at its output as well. Measure input-referred first,
   and add an output term only if A3 shows N is insensitive to the first.
2. **Power or amplitude?** Reading C as optical power, with negative sums clamped
   to zero, and reading it as field amplitude, `P = x²`, describe different
   networks. The generator decides; every A3 run records which.
3. **What is the transport rule between layers?** The harness maps C into the
   next A with a fixed shift at INT16. That rule has to be stated once and held
   fixed, or A3's depth axis mixes activation error with transport rounding.
4. **Does a scale model detuning well enough?** `f(s·x)/s` is exact for an
   efficiency change and wrong once `Δβ` reshapes the curve. The generator
   already emits a table per `Δβ` (`--dbeta`), and building one shows how soon
   that happens. With a mismatch, conversion rises and falls with power, so the
   knee is defined as the *first* half-conversion crossing. At `Δβ·L = 30 rad` a
   6 mm unit first converts half at 617 W, where a naive bisection had found a
   later crossing at 1146 W. That curve oscillates too fast for 1024 segments
   at the noise level it would carry, and the generator flags it. If A3 finds N
   sensitive to detuning, per-`Δβ` tables replace the scales, and strongly
   mismatched units need a narrower full scale.
