kubeworkz/grx930/Claude outputs/evidence_lvs_fixture/extracted.cir

* Extracted by KLayout with GF180MCU LVS runset on : 17/10/2026 15:39

* cell sample_nfet_05v0
* pin I1_default_S
* pin I1_default_D
* pin I1_default_G
* pin I1_lin_default_tapCntRows_4_R0_G
* pin I1_lin_default_tapCntRows_0_R0_G
* pin I1_lin_default_tapCntRows_1_R0_G
* pin I1_lin_default_tapCntRows_2_R0_G
* pin I1_lin_default_tapCntRows_3_R0_G
* pin I1_lin_default_tapCntRows_4_R0_D
* pin I1_lin_default_tapCntRows_0_R0_S
* pin I1_lin_default_tapCntRows_4_R0_S
* pin I1_lin_default_tapCntRows_0_R0_D
* pin I1_lin_default_tapCntRows_1_R0_S
* pin I1_lin_default_tapCntRows_1_R0_D
* pin I1_lin_default_tapCntRows_2_R0_S
* pin I1_lin_default_tapCntRows_2_R0_D
* pin I1_lin_default_tapCntRows_3_R0_S
* pin I1_lin_default_tapCntRows_3_R0_D
* pin I1_lin_default_bottomTap_0_R0_G
* pin I1_lin_default_bottomTap_0_R0_S
* pin I1_lin_default_bottomTap_0_R0_D
* pin I1_lin_default_topTap_0_R0_G
* pin I1_lin_default_topTap_0_R0_S
* pin I1_lin_default_topTap_0_R0_D
* pin I1_lin_default_rightTap_0_R0_S
* pin I1_lin_default_rightTap_0_R0_D
* pin I1_lin_default_rightTap_0_R0_G
* pin I1_lin_default_leftTap_0_R0_S
* pin I1_lin_default_leftTap_0_R0_D
* pin I1_lin_default_leftTap_0_R0_G
* pin I1_lin_default_bodytie_0_R0_G
* pin I1_lin_default_bodytie_1_R0_G
* pin I1_lin_default_bodytie_0_R0_S
* pin I1_lin_default_bodytie_1_R0_D
* pin I1_lin_default_bodytie_1_R0_S
* pin I1_lin_default_bodytie_0_R0_D
* pin I1_lin_default_sdConn_2_R0_G
* pin I1_lin_default_sdConn_0_R0_G
* pin I1_lin_default_sdConn_1_R0_G
* pin I1_lin_default_sdConn_0_R0_S
* pin I1_lin_default_sdConn_2_R0_D
* pin I1_lin_default_sdConn_0_R0_D
* pin I1_lin_default_sdConn_1_R0_S
* pin I1_lin_default_sdConn_2_R0_S
* pin I1_lin_default_sdConn_1_R0_D
* pin I1_lin_default_sFirst_0_R0_G
* pin I1_lin_default_sFirst_1_R0_G
* pin I1_lin_default_sdWidth_9_R0_G
* pin I1_lin_default_sFirst_0_R0_S
* pin I1_lin_default_sFirst_0_R0_D
* pin I1_lin_default_sFirst_1_R0_D
* pin I1_lin_default_sFirst_1_R0_S
* pin I1_lin_default_sdWidth_0_R0_G
* pin I1_lin_default_sdWidth_1_R0_G
* pin I1_lin_default_sdWidth_2_R0_G
* pin I1_lin_default_sdWidth_3_R0_G
* pin I1_lin_default_sdWidth_4_R0_G
* pin I1_lin_default_sdWidth_5_R0_G
* pin I1_lin_default_sdWidth_6_R0_G
* pin I1_lin_default_sdWidth_7_R0_G
* pin I1_lin_default_sdWidth_8_R0_G
* pin I1_lin_default_sdWidth_0_R0_S
* pin I1_lin_default_sdWidth_0_R0_D
* pin I1_lin_default_sdWidth_1_R0_S
* pin I1_lin_default_sdWidth_1_R0_D
* pin I1_lin_default_sdWidth_2_R0_S
* pin I1_lin_default_sdWidth_2_R0_D
* pin I1_lin_default_sdWidth_9_R0_D
* pin I1_lin_default_sdWidth_9_R0_S
* pin I1_lin_default_sdWidth_3_R0_S
* pin I1_lin_default_sdWidth_3_R0_D
* pin I1_lin_default_sdWidth_4_R0_S
* pin I1_lin_default_sdWidth_4_R0_D
* pin I1_lin_default_sdWidth_5_R0_S
* pin I1_lin_default_sdWidth_5_R0_D
* pin I1_lin_default_sdWidth_6_R0_S
* pin I1_lin_default_sdWidth_6_R0_D
* pin I1_lin_default_sdWidth_7_R0_S
* pin I1_lin_default_sdWidth_7_R0_D
* pin I1_lin_default_sdWidth_8_R0_S
* pin I1_lin_default_sdWidth_8_R0_D
* pin I1_lin_default_gateConn_2_R0_G
* pin I1_lin_default_gateConn_0_R0_S
* pin I1_lin_default_gateConn_0_R0_D
* pin I1_lin_default_gateConn_1_R0_G
* pin I1_lin_default_gateConn_2_R0_D
* pin I1_lin_default_gateConn_0_R0_G
* pin I1_lin_default_gateConn_2_R0_S
* pin I1_lin_default_gateConn_1_R0_S
* pin I1_lin_default_gateConn_1_R0_D
* pin I1_lin_default_calculatedParam_0_R0_G
* pin I1_lin_default_calculatedParam_1_R0_G
* pin I1_lin_default_calculatedParam_2_R0_G
* pin I1_lin_default_calculatedParam_0_R0_S
* pin I1_lin_default_calculatedParam_2_R0_D
* pin I1_lin_default_calculatedParam_2_R0_S
* pin I1_lin_default_calculatedParam_0_R0_D
* pin I1_lin_default_calculatedParam_1_R0_S
* pin I1_lin_default_calculatedParam_1_R0_D
* pin I1_lin_default_m_2_R0_G
* pin I1_lin_default_m_1_R0_G
* pin I1_lin_default_m_0_R0_G
* pin I1_lin_default_m_0_R0_S
* pin I1_lin_default_m_0_R0_D
* pin I1_lin_default_m_2_R0_S
* pin I1_lin_default_m_2_R0_D
* pin I1_lin_default_m_1_R0_S
* pin I1_lin_default_m_1_R0_D
* pin I1_lin_default_nf_0_R0_G
* pin I1_lin_default_nf_1_R0_G
* pin I1_lin_default_nf_2_R0_G
* pin I1_lin_default_nf_0_R0_S
* pin I1_lin_default_nf_0_R0_D
* pin I1_lin_default_nf_1_R0_S
* pin I1_lin_default_nf_1_R0_D
* pin I1_lin_default_nf_2_R0_S
* pin I1_lin_default_nf_2_R0_D
* pin I1_lin_default_l_0_R0_G
* pin I1_lin_default_fingerW_0_R0_G
* pin I1_lin_default_l_1_R0_G
* pin I1_lin_default_fingerW_1_R0_G
* pin I1_lin_default_l_2_R0_G
* pin I1_lin_default_fingerW_2_R0_G
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
* pin I1_lin_default_fingerW_26_R0_D
* pin I1_lin_default_l_17_R0_D
* pin I1_lin_default_fingerW_27_R0_S
* pin I1_lin_default_fingerW_27_R0_D
* pin I1_lin_default_l_18_R0_S
* pin I1_lin_default_fingerW_28_R0_S
* pin I1_lin_default_fingerW_28_R0_D
* pin I1_lin_default_fingerW_29_R0_S
* pin I1_lin_default_fingerW_29_R0_D
* pin I1_lin_default_l_18_R0_D
* pin I1_lin_default_fingerW_30_R0_S
* pin I1_lin_default_fingerW_30_R0_D
* pin I1_lin_default_l_19_R0_S
* pin I1_lin_default_fingerW_31_R0_S
* pin I1_lin_default_fingerW_31_R0_D
* pin I1_lin_default_fingerW_32_R0_S
* pin I1_lin_default_fingerW_32_R0_D
* pin I1_lin_default_l_19_R0_D
* pin I1_lin_default_l_20_R0_S
* pin I1_lin_default_l_20_R0_D
* pin I1_lin_default_l_21_R0_S
* pin I1_lin_default_l_21_R0_D
* pin I1_lin_default_l_22_R0_S
* pin I1_lin_default_l_22_R0_D
* pin I1_lin_default_l_23_R0_S
* pin I1_lin_default_l_23_R0_D
* pin I1_lin_default_l_24_R0_S
* pin I1_lin_default_l_24_R0_D
* pin I1_lin_default_l_25_R0_S
* pin I1_lin_default_fingerW_16_R0_G
* pin I1_lin_default_fingerW_17_R0_G
* pin I1_lin_default_fingerW_18_R0_G
* pin I1_lin_default_fingerW_19_R0_G
* pin I1_lin_default_fingerW_20_R0_G
* pin I1_lin_default_fingerW_21_R0_G
* pin I1_lin_default_fingerW_22_R0_G
* pin I1_lin_default_fingerW_23_R0_G
* pin I1_lin_default_fingerW_24_R0_G
* pin I1_lin_default_fingerW_25_R0_G
* pin I1_lin_default_fingerW_26_R0_G
* pin I1_lin_default_fingerW_27_R0_G
* pin I1_lin_default_fingerW_28_R0_G
* pin I1_lin_default_fingerW_29_R0_G
* pin I1_lin_default_fingerW_30_R0_G
* pin I1_lin_default_fingerW_31_R0_G
* pin I1_lin_default_fingerW_32_R0_G
* pin vdd!
.SUBCKT sample_nfet_05v0 I1_default_S I1_default_D I1_default_G
+ I1_lin_default_tapCntRows_4_R0_G I1_lin_default_tapCntRows_0_R0_G
+ I1_lin_default_tapCntRows_1_R0_G I1_lin_default_tapCntRows_2_R0_G
+ I1_lin_default_tapCntRows_3_R0_G I1_lin_default_tapCntRows_4_R0_D
+ I1_lin_default_tapCntRows_0_R0_S I1_lin_default_tapCntRows_4_R0_S
+ I1_lin_default_tapCntRows_0_R0_D I1_lin_default_tapCntRows_1_R0_S
+ I1_lin_default_tapCntRows_1_R0_D I1_lin_default_tapCntRows_2_R0_S
+ I1_lin_default_tapCntRows_2_R0_D I1_lin_default_tapCntRows_3_R0_S
+ I1_lin_default_tapCntRows_3_R0_D I1_lin_default_bottomTap_0_R0_G
+ I1_lin_default_bottomTap_0_R0_S I1_lin_default_bottomTap_0_R0_D
+ I1_lin_default_topTap_0_R0_G I1_lin_default_topTap_0_R0_S
+ I1_lin_default_topTap_0_R0_D I1_lin_default_rightTap_0_R0_S
+ I1_lin_default_rightTap_0_R0_D I1_lin_default_rightTap_0_R0_G
+ I1_lin_default_leftTap_0_R0_S I1_lin_default_leftTap_0_R0_D
+ I1_lin_default_leftTap_0_R0_G I1_lin_default_bodytie_0_R0_G
+ I1_lin_default_bodytie_1_R0_G I1_lin_default_bodytie_0_R0_S
+ I1_lin_default_bodytie_1_R0_D I1_lin_default_bodytie_1_R0_S
+ I1_lin_default_bodytie_0_R0_D I1_lin_default_sdConn_2_R0_G
+ I1_lin_default_sdConn_0_R0_G I1_lin_default_sdConn_1_R0_G
+ I1_lin_default_sdConn_0_R0_S I1_lin_default_sdConn_2_R0_D
+ I1_lin_default_sdConn_0_R0_D I1_lin_default_sdConn_1_R0_S
+ I1_lin_default_sdConn_2_R0_S I1_lin_default_sdConn_1_R0_D
+ I1_lin_default_sFirst_0_R0_G I1_lin_default_sFirst_1_R0_G
+ I1_lin_default_sdWidth_9_R0_G I1_lin_default_sFirst_0_R0_S
+ I1_lin_default_sFirst_0_R0_D I1_lin_default_sFirst_1_R0_D
+ I1_lin_default_sFirst_1_R0_S I1_lin_default_sdWidth_0_R0_G
+ I1_lin_default_sdWidth_1_R0_G I1_lin_default_sdWidth_2_R0_G
+ I1_lin_default_sdWidth_3_R0_G I1_lin_default_sdWidth_4_R0_G
+ I1_lin_default_sdWidth_5_R0_G I1_lin_default_sdWidth_6_R0_G
+ I1_lin_default_sdWidth_7_R0_G I1_lin_default_sdWidth_8_R0_G
+ I1_lin_default_sdWidth_0_R0_S I1_lin_default_sdWidth_0_R0_D
+ I1_lin_default_sdWidth_1_R0_S I1_lin_default_sdWidth_1_R0_D
+ I1_lin_default_sdWidth_2_R0_S I1_lin_default_sdWidth_2_R0_D
+ I1_lin_default_sdWidth_9_R0_D I1_lin_default_sdWidth_9_R0_S
+ I1_lin_default_sdWidth_3_R0_S I1_lin_default_sdWidth_3_R0_D
+ I1_lin_default_sdWidth_4_R0_S I1_lin_default_sdWidth_4_R0_D
+ I1_lin_default_sdWidth_5_R0_S I1_lin_default_sdWidth_5_R0_D
+ I1_lin_default_sdWidth_6_R0_S I1_lin_default_sdWidth_6_R0_D
+ I1_lin_default_sdWidth_7_R0_S I1_lin_default_sdWidth_7_R0_D
+ I1_lin_default_sdWidth_8_R0_S I1_lin_default_sdWidth_8_R0_D
+ I1_lin_default_gateConn_2_R0_G I1_lin_default_gateConn_0_R0_S
+ I1_lin_default_gateConn_0_R0_D I1_lin_default_gateConn_1_R0_G
+ I1_lin_default_gateConn_2_R0_D I1_lin_default_gateConn_0_R0_G
+ I1_lin_default_gateConn_2_R0_S I1_lin_default_gateConn_1_R0_S
+ I1_lin_default_gateConn_1_R0_D I1_lin_default_calculatedParam_0_R0_G
+ I1_lin_default_calculatedParam_1_R0_G I1_lin_default_calculatedParam_2_R0_G
+ I1_lin_default_calculatedParam_0_R0_S I1_lin_default_calculatedParam_2_R0_D
+ I1_lin_default_calculatedParam_2_R0_S I1_lin_default_calculatedParam_0_R0_D
+ I1_lin_default_calculatedParam_1_R0_S I1_lin_default_calculatedParam_1_R0_D
+ I1_lin_default_m_2_R0_G I1_lin_default_m_1_R0_G I1_lin_default_m_0_R0_G
+ I1_lin_default_m_0_R0_S I1_lin_default_m_0_R0_D I1_lin_default_m_2_R0_S
+ I1_lin_default_m_2_R0_D I1_lin_default_m_1_R0_S I1_lin_default_m_1_R0_D
+ I1_lin_default_nf_0_R0_G I1_lin_default_nf_1_R0_G I1_lin_default_nf_2_R0_G
+ I1_lin_default_nf_0_R0_S I1_lin_default_nf_0_R0_D I1_lin_default_nf_1_R0_S
+ I1_lin_default_nf_1_R0_D I1_lin_default_nf_2_R0_S I1_lin_default_nf_2_R0_D
+ I1_lin_default_l_0_R0_G I1_lin_default_fingerW_0_R0_G I1_lin_default_l_1_R0_G
+ I1_lin_default_fingerW_1_R0_G I1_lin_default_l_2_R0_G
+ I1_lin_default_fingerW_2_R0_G I1_lin_default_fingerW_3_R0_G
+ I1_lin_default_l_3_R0_G I1_lin_default_fingerW_4_R0_G I1_lin_default_l_4_R0_G
+ I1_lin_default_fingerW_5_R0_G I1_lin_default_l_5_R0_G
+ I1_lin_default_fingerW_6_R0_G I1_lin_default_l_6_R0_G
+ I1_lin_default_fingerW_7_R0_G I1_lin_default_l_7_R0_G
+ I1_lin_default_fingerW_8_R0_G I1_lin_default_l_8_R0_G
+ I1_lin_default_fingerW_9_R0_G I1_lin_default_l_9_R0_G
+ I1_lin_default_fingerW_10_R0_G I1_lin_default_fingerW_11_R0_G
+ I1_lin_default_l_10_R0_G I1_lin_default_fingerW_12_R0_G
+ I1_lin_default_l_11_R0_G I1_lin_default_fingerW_13_R0_G
+ I1_lin_default_fingerW_14_R0_G I1_lin_default_l_12_R0_G
+ I1_lin_default_fingerW_15_R0_G I1_lin_default_l_13_R0_G
+ I1_lin_default_l_14_R0_G I1_lin_default_l_15_R0_G I1_lin_default_l_16_R0_G
+ I1_lin_default_l_17_R0_G I1_lin_default_l_18_R0_G I1_lin_default_l_19_R0_G
+ I1_lin_default_l_20_R0_G I1_lin_default_l_21_R0_G I1_lin_default_l_22_R0_G
+ I1_lin_default_l_23_R0_G I1_lin_default_l_24_R0_G I1_lin_default_l_25_R0_G
+ I1_lin_default_fingerW_0_R0_S I1_lin_default_l_0_R0_S I1_lin_default_l_0_R0_D
+ I1_lin_default_fingerW_0_R0_D I1_lin_default_l_1_R0_S
+ I1_lin_default_fingerW_1_R0_S I1_lin_default_l_1_R0_D
+ I1_lin_default_fingerW_1_R0_D I1_lin_default_l_2_R0_S
+ I1_lin_default_fingerW_2_R0_S I1_lin_default_l_2_R0_D
+ I1_lin_default_fingerW_2_R0_D I1_lin_default_fingerW_3_R0_S
+ I1_lin_default_l_3_R0_S I1_lin_default_fingerW_3_R0_D I1_lin_default_l_3_R0_D
+ I1_lin_default_fingerW_4_R0_S I1_lin_default_l_4_R0_S
+ I1_lin_default_fingerW_4_R0_D I1_lin_default_l_4_R0_D
+ I1_lin_default_fingerW_5_R0_S I1_lin_default_l_5_R0_S
+ I1_lin_default_fingerW_5_R0_D I1_lin_default_l_5_R0_D
+ I1_lin_default_fingerW_6_R0_S I1_lin_default_fingerW_6_R0_D
+ I1_lin_default_l_6_R0_S I1_lin_default_l_6_R0_D I1_lin_default_fingerW_7_R0_S
+ I1_lin_default_fingerW_7_R0_D I1_lin_default_l_7_R0_S I1_lin_default_l_7_R0_D
+ I1_lin_default_fingerW_8_R0_S I1_lin_default_fingerW_8_R0_D
+ I1_lin_default_l_8_R0_S I1_lin_default_fingerW_9_R0_S I1_lin_default_l_8_R0_D
+ I1_lin_default_fingerW_9_R0_D I1_lin_default_l_9_R0_S
+ I1_lin_default_fingerW_10_R0_S I1_lin_default_fingerW_10_R0_D
+ I1_lin_default_l_9_R0_D I1_lin_default_fingerW_11_R0_S
+ I1_lin_default_fingerW_11_R0_D I1_lin_default_l_10_R0_S
+ I1_lin_default_l_10_R0_D I1_lin_default_fingerW_12_R0_S
+ I1_lin_default_fingerW_12_R0_D I1_lin_default_l_11_R0_S
+ I1_lin_default_fingerW_13_R0_S I1_lin_default_fingerW_13_R0_D
+ I1_lin_default_l_11_R0_D I1_lin_default_fingerW_14_R0_S
+ I1_lin_default_fingerW_14_R0_D I1_lin_default_l_12_R0_S
+ I1_lin_default_fingerW_15_R0_S I1_lin_default_l_25_R0_D
+ I1_lin_default_l_12_R0_D I1_lin_default_fingerW_15_R0_D
+ I1_lin_default_l_13_R0_S I1_lin_default_fingerW_16_R0_S
+ I1_lin_default_fingerW_16_R0_D I1_lin_default_l_13_R0_D
+ I1_lin_default_fingerW_17_R0_S I1_lin_default_fingerW_17_R0_D
+ I1_lin_default_l_14_R0_S I1_lin_default_fingerW_18_R0_S
+ I1_lin_default_fingerW_18_R0_D I1_lin_default_fingerW_19_R0_S
+ I1_lin_default_l_14_R0_D I1_lin_default_fingerW_19_R0_D
+ I1_lin_default_l_15_R0_S I1_lin_default_fingerW_20_R0_S
+ I1_lin_default_fingerW_20_R0_D I1_lin_default_fingerW_21_R0_S
+ I1_lin_default_fingerW_21_R0_D I1_lin_default_l_15_R0_D
+ I1_lin_default_fingerW_22_R0_S I1_lin_default_l_16_R0_S
+ I1_lin_default_fingerW_22_R0_D I1_lin_default_fingerW_23_R0_S
+ I1_lin_default_fingerW_23_R0_D I1_lin_default_l_16_R0_D
+ I1_lin_default_fingerW_24_R0_S I1_lin_default_fingerW_24_R0_D
+ I1_lin_default_l_17_R0_S I1_lin_default_fingerW_25_R0_S
+ I1_lin_default_fingerW_25_R0_D I1_lin_default_fingerW_26_R0_S
+ I1_lin_default_fingerW_26_R0_D I1_lin_default_l_17_R0_D
+ I1_lin_default_fingerW_27_R0_S I1_lin_default_fingerW_27_R0_D
+ I1_lin_default_l_18_R0_S I1_lin_default_fingerW_28_R0_S
+ I1_lin_default_fingerW_28_R0_D I1_lin_default_fingerW_29_R0_S
+ I1_lin_default_fingerW_29_R0_D I1_lin_default_l_18_R0_D
+ I1_lin_default_fingerW_30_R0_S I1_lin_default_fingerW_30_R0_D
+ I1_lin_default_l_19_R0_S I1_lin_default_fingerW_31_R0_S
+ I1_lin_default_fingerW_31_R0_D I1_lin_default_fingerW_32_R0_S
+ I1_lin_default_fingerW_32_R0_D I1_lin_default_l_19_R0_D
+ I1_lin_default_l_20_R0_S I1_lin_default_l_20_R0_D I1_lin_default_l_21_R0_S
+ I1_lin_default_l_21_R0_D I1_lin_default_l_22_R0_S I1_lin_default_l_22_R0_D
+ I1_lin_default_l_23_R0_S I1_lin_default_l_23_R0_D I1_lin_default_l_24_R0_S
+ I1_lin_default_l_24_R0_D I1_lin_default_l_25_R0_S
+ I1_lin_default_fingerW_16_R0_G I1_lin_default_fingerW_17_R0_G
+ I1_lin_default_fingerW_18_R0_G I1_lin_default_fingerW_19_R0_G
+ I1_lin_default_fingerW_20_R0_G I1_lin_default_fingerW_21_R0_G
+ I1_lin_default_fingerW_22_R0_G I1_lin_default_fingerW_23_R0_G
+ I1_lin_default_fingerW_24_R0_G I1_lin_default_fingerW_25_R0_G
+ I1_lin_default_fingerW_26_R0_G I1_lin_default_fingerW_27_R0_G
+ I1_lin_default_fingerW_28_R0_G I1_lin_default_fingerW_29_R0_G
+ I1_lin_default_fingerW_30_R0_G I1_lin_default_fingerW_31_R0_G
+ I1_lin_default_fingerW_32_R0_G vdd!
* device instance $1 r0 *1 69.9,62.88 nfet_05v0
M$1 I1_lin_default_sdWidth_9_R0_D I1_lin_default_sdWidth_9_R0_G
+ I1_lin_default_sdWidth_9_R0_S vdd! nfet_05v0 L=0.6U W=26.8U AS=20.3144P
+ AD=20.3144P PS=39.74U PD=39.74U
* device instance $6 r0 *1 8.1,7.58 nfet_05v0
M$6 I1_lin_default_tapCntRows_1_R0_D I1_lin_default_tapCntRows_1_R0_G
+ I1_lin_default_tapCntRows_1_R0_S vdd! nfet_05v0 L=0.6U W=0.36U AS=0.1584P
+ AD=0.1584P PS=1.6U PD=1.6U
* device instance $7 r0 *1 1.1,7.58 nfet_05v0
M$7 I1_lin_default_tapCntRows_0_R0_D I1_lin_default_tapCntRows_0_R0_G
+ I1_lin_default_tapCntRows_0_R0_S vdd! nfet_05v0 L=0.6U W=0.36U AS=0.1584P
+ AD=0.1584P PS=1.6U PD=1.6U
* device instance $8 r0 *1 8.1,40.58 nfet_05v0
M$8 I1_lin_default_bodytie_1_R0_D I1_lin_default_bodytie_1_R0_G
+ I1_lin_default_bodytie_1_R0_S vdd! nfet_05v0 L=0.6U W=0.36U AS=0.1584P
+ AD=0.1584P PS=1.6U PD=1.6U
* device instance $9 r0 *1 -14.49,99.2 nfet_05v0
M$9 I1_lin_default_m_2_R0_D I1_lin_default_m_2_R0_G I1_lin_default_m_2_R0_S
+ vdd! nfet_05v0 L=0.6U W=36U AS=15.84P AD=15.84P PS=72.88U PD=72.88U
* device instance $10 r0 *1 224.3,151 nfet_05v0
M$10 I1_lin_default_fingerW_32_R0_D I1_lin_default_fingerW_32_R0_G
+ I1_lin_default_fingerW_32_R0_S vdd! nfet_05v0 L=0.6U W=100U AS=44P AD=44P
+ PS=200.88U PD=200.88U
* device instance $11 r0 *1 217.3,143.727 nfet_05v0
M$11 I1_lin_default_fingerW_31_R0_D I1_lin_default_fingerW_31_R0_G
+ I1_lin_default_fingerW_31_R0_S vdd! nfet_05v0 L=0.6U W=85.455U AS=37.6002P
+ AD=37.6002P PS=171.79U PD=171.79U
* device instance $12 r0 *1 210.3,136.607 nfet_05v0
M$12 I1_lin_default_fingerW_30_R0_D I1_lin_default_fingerW_30_R0_G
+ I1_lin_default_fingerW_30_R0_S vdd! nfet_05v0 L=0.6U W=71.215U AS=31.3346P
+ AD=31.3346P PS=143.31U PD=143.31U
* device instance $13 r0 *1 203.3,130.672 nfet_05v0
M$13 I1_lin_default_fingerW_29_R0_D I1_lin_default_fingerW_29_R0_G
+ I1_lin_default_fingerW_29_R0_S vdd! nfet_05v0 L=0.6U W=59.345U AS=26.1118P
+ AD=26.1118P PS=119.57U PD=119.57U
* device instance $14 r0 *1 196.3,125.727 nfet_05v0
M$14 I1_lin_default_fingerW_28_R0_D I1_lin_default_fingerW_28_R0_G
+ I1_lin_default_fingerW_28_R0_S vdd! nfet_05v0 L=0.6U W=49.455U AS=21.7602P
+ AD=21.7602P PS=99.79U PD=99.79U
* device instance $15 r0 *1 189.5,121.605 nfet_05v0
M$15 I1_lin_default_fingerW_27_R0_D I1_lin_default_fingerW_27_R0_G
+ I1_lin_default_fingerW_27_R0_S vdd! nfet_05v0 L=0.6U W=41.21U AS=18.1324P
+ AD=18.1324P PS=83.3U PD=83.3U
* device instance $16 r0 *1 182.5,118.172 nfet_05v0
M$16 I1_lin_default_fingerW_26_R0_D I1_lin_default_fingerW_26_R0_G
+ I1_lin_default_fingerW_26_R0_S vdd! nfet_05v0 L=0.6U W=34.345U AS=15.1118P
+ AD=15.1118P PS=69.57U PD=69.57U
* device instance $17 r0 *1 175.5,115.31 nfet_05v0
M$17 I1_lin_default_fingerW_25_R0_D I1_lin_default_fingerW_25_R0_G
+ I1_lin_default_fingerW_25_R0_S vdd! nfet_05v0 L=0.6U W=28.62U AS=12.5928P
+ AD=12.5928P PS=58.12U PD=58.12U
* device instance $18 r0 *1 168.5,112.925 nfet_05v0
M$18 I1_lin_default_fingerW_24_R0_D I1_lin_default_fingerW_24_R0_G
+ I1_lin_default_fingerW_24_R0_S vdd! nfet_05v0 L=0.6U W=23.85U AS=10.494P
+ AD=10.494P PS=48.58U PD=48.58U
* device instance $19 r0 *1 161.5,110.937 nfet_05v0
M$19 I1_lin_default_fingerW_23_R0_D I1_lin_default_fingerW_23_R0_G
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
M$52 I1_lin_default_l_15_R0_D I1_lin_default_l_15_R0_G I1_lin_default_l_15_R0_S
+ vdd! nfet_05v0 L=9.245U W=0.36U AS=0.1584P AD=0.1584P PS=1.6U PD=1.6U
* device instance $53 r0 *1 129.252,94.58 nfet_05v0
M$53 I1_lin_default_l_14_R0_D I1_lin_default_l_14_R0_G I1_lin_default_l_14_R0_S
+ vdd! nfet_05v0 L=7.705U W=0.36U AS=0.1584P AD=0.1584P PS=1.6U PD=1.6U
* device instance $54 r0 *1 115.81,94.58 nfet_05v0
M$54 I1_lin_default_l_13_R0_D I1_lin_default_l_13_R0_G I1_lin_default_l_13_R0_S
+ vdd! nfet_05v0 L=6.42U W=0.36U AS=0.1584P AD=0.1584P PS=1.6U PD=1.6U
* device instance $55 r0 *1 103.475,94.58 nfet_05v0
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
