kubeworkz/grx930/c930/sw/c930_npu_driver.h

// -----------------------------------------------------------------------------
// c930_npu_driver.h - Host-side driver for the C930 NPU command queue.
//
// Vendor-ready for the grxcp backend. Implements the completion contract
// documented in doc/c930_architecture.md ("Command queue and completion
// contract") and doc/phase7_integration_guide.md:
//
//   * DONE is a latched LEVEL, not a per-command edge: it is set by the first
//     GEMM that completes and cleared ONLY by a START write. It cannot tell
//     you which queued command finished.
//   * BUSY is per-command: it drops to 0 in the short bubble between a queued
//     command's completion and the next dispatch, even when the FIFO still
//     holds commands.
//   * Therefore, for a BATCH of queued commands, poll the queue itself:
//
//         while (queue_occupancy() != 0 || status_busy()) ;
//
//     Neither condition alone is sufficient (occupancy==0 can coincide with
//     the last command still running; busy==0 can coincide with commands
//     still queued). This is npu_drv_drain().
//   * For ONE command at a time, DONE->!BUSY after the START write is safe
//     (the START cleared DONE). This is npu_drv_wait_done().
//   * START is a 1-cycle pulse whose queue push needs FIFO space the SAME
//     cycle: a START against a full FIFO is silently dropped, never deferred.
//     Check queue_room() > 0 before submitting (npu_drv_submit does).
//
// IO abstraction: the driver knows nothing about the bus. You provide
// 32-bit read/write callbacks that receive the FULL byte address
// (NPU base + register offset). Three ways to wire it:
//
//   1. RISC-V firmware (MMIO at fixed base):
//        npu_drv_mmio(NPU0_BASE);          // volatile-pointer accessors
//   2. Verilator host (like grxcp):
//        npu_drv_init(my_read32, my_write32);
//   3. Multiple NPUs: keep one callback pair; pass base per call:
//        npu_drv_submit_at(NPU1_BASE, &gemm);
//
// Example (batch of 3 queued GEMMs, then drain):
//
//     npu_drv_mmio(NPU0_BASE);
//     for (int i = 0; i < 3; i++)
//         npu_drv_submit(&gemm[i]);            // returns -1 if queue full
//     if (npu_drv_drain(NPU_DRV_TIMEOUT_FOREVER))
//         npu_drv_get_stats(&st);              // cycles, OP_COUNT, DMA_CT...
//     if (npu_drv_error()) ...                 // invalid dims latched
//
// -----------------------------------------------------------------------------

#ifndef C930_NPU_DRIVER_H
#define C930_NPU_DRIVER_H

#include <stdint.h>

#ifdef __cplusplus
extern "C" {
#endif

// ---- SoC address map (c930_soc_top.sv MMIO decode) ----
#define NPU0_BASE  0x40000000u
#define NPU1_BASE  0x40000040u

// ---- Register map (c930_npu_csr.sv; byte addresses) ----
#define NPU_REG_CTRL        (NPU0_BASE + 0x00)   // W: [0] START (snapshot+queue; clears DONE/ERROR)
#define NPU_REG_STATUS      (NPU0_BASE + 0x04)   // R: [0] BUSY [1] DONE [2] ERROR
#define NPU_REG_DIM_M       (NPU0_BASE + 0x08)   // R/W: output rows, 1..MAX_M
#define NPU_REG_DIM_N       (NPU0_BASE + 0x0c)   // R/W: output cols, 1..MAX_N
#define NPU_REG_DIM_K       (NPU0_BASE + 0x10)   // R/W: reduction length, 1..MAX_K
#define NPU_REG_A_BASE      (NPU0_BASE + 0x14)   // R/W: A matrix DDR address (word-aligned)
#define NPU_REG_B_BASE      (NPU0_BASE + 0x18)   // R/W: B matrix DDR address (word-aligned)
#define NPU_REG_C_BASE      (NPU0_BASE + 0x1c)   // R/W: C result DDR address (word-aligned)
#define NPU_REG_PREC        (NPU0_BASE + 0x20)   // R/W: [2:0] precision (see NPU_PREC_*)
#define NPU_REG_CYCLE_LO    (NPU0_BASE + 0x24)   // R: core cycles (state != S_IDLE), resets on i_start
#define NPU_REG_DMA_LAST    (NPU0_BASE + 0x28)   // R: latched DMA cycle count, last completed GEMM
#define NPU_REG_OP_COUNT    (NPU0_BASE + 0x2c)   // R: PE firings (NUM_ROWS*NUM_COLS per S_RUN cycle)
#define NPU_REG_STALL_CT    (NPU0_BASE + 0x30)   // R: weight-load cycles (S_WLOAD + S_PRELOAD)
#define NPU_REG_DMA_CT      (NPU0_BASE + 0x34)   // R: live DMA busy cycles (phase != P_IDLE)
#define NPU_REG_QUEUE_STAT  (NPU0_BASE + 0x38)   // R: [3:0] occupancy, [4] full
#define NPU_REG_QUEUE_MAX   (NPU0_BASE + 0x3c)   // R: compile-time FIFO depth (CMD_QUEUE_DEPTH)

// ---- CTRL bits ----
#define NPU_CTRL_START      0x1u

// ---- STATUS bits ----
#define NPU_STATUS_BUSY     0x1u
#define NPU_STATUS_DONE     0x2u
#define NPU_STATUS_ERROR    0x4u

// ---- QUEUE_STAT bits ----
#define NPU_QUEUE_OCC_MASK  0xFu
#define NPU_QUEUE_FULL      0x10u

// ---- PTA register block (C4(a)) ----
// The block is at NPU0_BASE + 0x100 and is laid out exactly as the PTA
// chiplet's MMIO window from its own 0x040 (grxcp docs/designs/
// pta_chiplet_regmap.md section 4), so the offsets below reach a c930 tile and
// a chiplet with nothing but the base changed.  It is NOT at 0x40: that is
// NPU1's CSR window on this SoC.  rtl/c930_npu_csr.sv's header has the reasoning
// and the three places where the block differs from the CPU document's 3.1.
#define PTA_BASE            (NPU0_BASE + 0x100u)

/* Identity, at the block's own 0x000 as the chiplet's map has it (grxcp
 * pta_chiplet_regmap.md section 2).  The block is in every build, tile or no
 * tile, and PTA_CTRL and PTA_IMPAIR read back on a digital array as they do on
 * a tile -- so these four read-only words are the only thing a driver can READ
 * that tells the two apart.  A register file that predates them reads zero at
 * PTA_REG_ID, which is not the magic, and a driver must then treat everything
 * below as unknown rather than as "no tile". */
#define PTA_REG_ID          (PTA_BASE + 0x00)   // R: [31:8] "PTA", [7:0] map version
#define PTA_REG_CAPS0       (PTA_BASE + 0x04)   // R: the tile's geometry and widths
#define PTA_REG_CAPS1       (PTA_BASE + 0x08)   // R: impairments built, banks, widest bits
#define PTA_REG_CAPS2       (PTA_BASE + 0x0c)   // R: engine, stage, tile kind, emulated

#define PTA_ID_MAGIC        0x50544100u         // "PTA" in [31:8]
#define PTA_ID_IS_PTA(id)   (((id) & 0xFFFFFF00u) == PTA_ID_MAGIC)
#define PTA_ID_VERSION(id)  ((id) & 0xFFu)

#define PTA_CAPS0_ROWS(c)   ((c) & 0x3FFu)             // k: inputs a shot sums
#define PTA_CAPS0_COLS(c)   (((c) >> 10) & 0x3FFu)     // n: outputs a shot yields
#define PTA_CAPS0_DIN_W(c)  (((c) >> 20) & 0x3Fu)      // operand width, bits
#define PTA_CAPS0_ACC_W(c)  (((c) >> 26) & 0x3Fu)      // accumulator width, bits

#define PTA_CAPS1_BUILT(c)  ((c) & 0x7Fu)              // PTA_IMP_* this build accepts
#define PTA_CAPS1_BANKS(c)  (((c) >> 8) & 0xFFu)
#define PTA_CAPS1_ABITS(c)  (((c) >> 16) & 0xFu)       // widest B_a that quantises
#define PTA_CAPS1_WBITS(c)  (((c) >> 20) & 0xFu)       // widest B_w that quantises
#define PTA_CAPS1_ADCBITS(c) (((c) >> 24) & 0xFu)      // widest B_adc

#define PTA_CAPS2_SHOT_MHZ(c) ((c) & 0xFFFFu)          // 0: an emulation, no rate
#define PTA_CAPS2_HAS_CAL   0x00010000u                // the calibration engine
#define PTA_CAPS2_HAS_ACT   0x00020000u                // S_ACT
#define PTA_CAPS2_TILE(c)   (((c) >> 18) & 3u)         // PTA_TILE_*
#define PTA_CAPS2_EMULATED  0x80000000u                // the error model, not photonics

#define PTA_TILE_NONE       0u                         // the digital array
#define PTA_TILE_SERIAL     1u                         // PTM-C, word-serial readout
#define PTA_TILE_BROADSIDE  2u                         // PTM-B

/* The probe amplitudes PTA_CAL_CFG accepts, from what CAPS0 reports and the
 * activation bits in PTA_BITS: [DIN_W - B_a, DIN_W - 2].  Before CAPS0 a driver
 * had to search for one. */
#define PTA_CAL_AMP_MAX(caps0)      (PTA_CAPS0_DIN_W(caps0) - 2u)
#define PTA_CAL_AMP_MIN(caps0, ba)  (PTA_CAPS0_DIN_W(caps0) - (ba))

#define PTA_REG_CTRL        (PTA_BASE + 0x40)   // RW: [0] EN [1] CAL_NOW [3] MODEL_RST [5:4] CAL_SCHED
#define PTA_REG_STATUS      (PTA_BASE + 0x44)   // R:  see PTA_ST_* below
#define PTA_REG_IMPAIR      (PTA_BASE + 0x48)   // RW: [6:0] one bit per impairment
#define PTA_REG_BITS        (PTA_BASE + 0x4c)   // RW: [3:0] B_a [7:4] B_w [11:8] B_adc [17:12] S
#define PTA_REG_SEED        (PTA_BASE + 0x50)   // RW: every per-GEMM noise stream
#define PTA_REG_SIGMA_TH    (PTA_BASE + 0x54)   // RW: thermal sigma, Q8.8 ADC LSB
#define PTA_REG_SIGMA_SH    (PTA_BASE + 0x58)   // RW: shot coefficient k, Q8.8
#define PTA_REG_SIGMA_PR    (PTA_BASE + 0x5c)   // RW: programming error sigma, Q8.8 weight LSB
#define PTA_REG_DRIFT       (PTA_BASE + 0x60)   // RW: [15:0] sigma Q8.8, [20:16] log2 shots a step
#define PTA_REG_XTALK       (PTA_BASE + 0x64)   // RW: [7:0] chi, Q0.8
/* An NPU counter in the PTA block's spare space: cycles the core spent starved of
 * A rows (S_AROW).  NPU0's own counter window (0x00-0x3C) is full and 0x40 upward
 * is NPU1's.  F2 wants it because being starved of operands is a host problem, not
 * a tile one -- see the CPU document's 6.2, where C4(c) could only reach it by
 * subtraction. */
#define NPU_REG_AROW_CT     (PTA_BASE + 0xe0)   // R: cycles waiting for an A row
#define PTA_REG_TW          (PTA_BASE + 0x68)   // RW: settle after a program, core cycles (C2 tile)
#define PTA_REG_TS          (PTA_BASE + 0x6c)   // RW: shot + ADC latency, core cycles (C2 tile)
#define PTA_REG_CAL_PER     (PTA_BASE + 0x70)   // RW: the periodic period, and the floor on the others
#define PTA_REG_CAL_THR     (PTA_BASE + 0x74)   // RW: predicted error that fires, Q.8 weight LSB
#define PTA_REG_CAL_CT      (PTA_BASE + 0x78)   // R:  calibrations run
#define PTA_REG_CAL_CYC     (PTA_BASE + 0x7c)   // R:  cycles spent calibrating, cumulative
#define PTA_REG_SHOT_CT     (PTA_BASE + 0x80)   // R:  optical shots issued, cumulative
#define PTA_REG_WLOAD_CT    (PTA_BASE + 0x84)   // R:  weight-bank programmings, cumulative
#define PTA_REG_SAT_CT      (PTA_BASE + 0x88)   // R:  ADC saturations, this GEMM
#define PTA_REG_ERR_MAX     (PTA_BASE + 0x8c)   // R:  what the last calibration LEFT, Q.8
#define PTA_REG_GAIN(j)     (PTA_BASE + 0x90 + 4*(j))   // RW: column gain, Q8.8, 256 unity
#define PTA_REG_OFFS(j)     (PTA_BASE + 0xb0 + 4*(j))   // RW: column offset, signed
#define PTA_REG_DRIFT_MAX   (PTA_BASE + 0xd0)   // RW: drift clamp, Q8.8 weight LSB
#define PTA_REG_CAL_CFG     (PTA_BASE + 0xd4)   // RW: [3:0] amp log2 [7:4] reps log2 [9:8] passes [10] bank
#define PTA_REG_TRIM        (PTA_BASE + 0xd8)   // RW: [3:0] DAC step log2 Q.8, [31:16] clamp
#define PTA_REG_CAL_SEED    (PTA_BASE + 0xdc)   // RW: the calibration's noise seed
#define PTA_REG_ERR_FOUND   (PTA_BASE + 0xf0)   // R:  what the last calibration FOUND, Q.8

// ---- PTA_CTRL bits.  Bit 2, CAL_AUTO in the CPU document, reads zero and
// ---- does nothing: CAL_SCHED already says whether calibration is automatic.
#define PTA_CTRL_EN         0x01u
#define PTA_CTRL_CAL_NOW    0x02u   // write 1: one calibration, as soon as the tile is free
#define PTA_CTRL_MODEL_RST  0x08u   // write 1: drift to zero AND the correction cleared
#define PTA_CTRL_SCHED(s)   (((s) & 3u) << 4)
/* MB's modes (step MB, measured by C4(c)).  All zero is the shipped behaviour:
 * one weight bank per compute, scanned every tile, interchanged loop order.
 * They are latched, and the core samples them at each GEMM start, so firmware
 * sets them once for a sweep point rather than per GEMM. */
#define PTA_CTRL_RESIDENT   0x080u  /* a weight bank per (N tile, K tile) */
#define PTA_CTRL_WSKIP      0x100u  /* the banks already hold the weights */
#define PTA_CTRL_MORDER     0x200u  /* m-outer loop order */
/* F2's third feed option.  Unlike the three above this one is the DMA's, not the
 * tile's: every A row is read before the core's start, and both prefetches (PF1
 * during compute, PF2 during the previous writeback) are off.  It is the path
 * INT4 takes of necessity, asked for at a precision that does not need it. */
#define PTA_CTRL_STAGE_A    0x400u  /* read all of A before launching */
/* F2 found PF2 -- the cross-GEMM prefetch that runs during C writeback -- to be
 * a net loss of about 22 cycles a queued GEMM, at two shapes.  STAGE_A turns it
 * off, but only as a side effect of turning PF1 off too, which its correctness
 * requires.  This bit turns off PF2 alone, so the configuration F2's arithmetic
 * points at -- PF1 on, PF2 off, queued -- can be run and measured.
 * At Q = 1 it is a no-op by construction: with no next GEMM queued there is
 * nothing for PF2 to prefetch, and the gate checks that. */
#define PTA_CTRL_PF2_OFF    0x800u  /* no cross-GEMM prefetch */
/* ---- S_ACT (A-CSR; doc/npu_act_stage_design_note.md section 4) ----
 * Four words, which is what the PTA block has free: 0xE4, 0xE8, 0xEC and 0xF4,
 * 0xF8.  The note's draft said twelve were free at 0xD0-0xFC, which predates
 * DRIFT_MAX, CAL_CFG, TRIM, CAL_SEED, AROW_CT and ERR_FOUND taking half of
 * them.  So everything that is not a scalar goes behind one indirect window:
 * the per-column scales, the table, and the three counters. */
#define ACT_REG_CFG         (PTA_BASE + 0xe4)   /* RW: [15:0] k_shot Q8.8,
                                                 * [19:16] adc_bits,
                                                 * [25:20] xshift, [31:26] yshift */
#define ACT_REG_SEED        (PTA_BASE + 0xe8)   /* RW: xorshift32 seed */
#define ACT_REG_CTRL        (PTA_BASE + 0xec)   /* RW: [0] EN, [1] NOISE_CONST,
                                                 * [2] REQUANT */
#define ACT_REG_IADDR       (PTA_BASE + 0xf4)   /* RW: [10:0] index,
                                                 * [13:12] region */
#define ACT_REG_IDATA       (PTA_BASE + 0xf8)   /* RW: the word at IADDR; the
                                                 * index auto-increments */

#define ACT_CTRL_EN         0x1u
#define ACT_CTRL_NOISE_CONST 0x2u
/* REQUANT is latched here and SNAPSHOTTED at START, like the dims: a live bit
 * would apply to whichever command dispatched next, which is the hazard the
 * completion contract exists to prevent.  Writing it does not disturb a GEMM
 * already queued. */
#define ACT_CTRL_REQUANT    0x4u

/* IADDR regions. */
#define ACT_IR_XS           (0u << 12)   /* 32 bits x NUM_COLS, XSCALE * s_j */
#define ACT_IR_R            (1u << 12)   /* 16 bits x NUM_COLS, 1/s_j Q4.12 */
#define ACT_IR_TBL          (2u << 12)   /* 24 bits x 1025, write-only, IDLE only */
#define ACT_IR_CNT          (3u << 12)   /* read-only: 0 count, 1 sats, 2 cycles */

#define ACT_CNT_ACTIVATED   0u
#define ACT_CNT_SATS        1u
#define ACT_CNT_CYCLES      2u

#define PTA_SCHED_OFF       0u
#define PTA_SCHED_PERIODIC  1u
#define PTA_SCHED_PREDICT   2u
#define PTA_SCHED_SHADOW    3u

// ---- PTA_STATUS bits ----
#define PTA_ST_CAL_BUSY     0x01u
#define PTA_ST_CAL_VALID    0x02u
#define PTA_ST_SAT          0x04u   // this GEMM saturated an ADC (PTA_SAT_CT != 0)
#define PTA_ST_DRIFT_ALARM  0x08u   // a trim could not reach what the estimator asked
#define PTA_ST_BUSY         0x10u   // the engine's BUSY, so one read is a snapshot
#define PTA_ST_CAL_ERR      0x20u   // a refused probe, or a START/MODEL_RST during a cal
#define PTA_ST_RESID(v)     (((v) >> 8) & 0xFFFFu)   // the same value as PTA_ERR_MAX[15:0]

// ---- PTA_IMPAIR bits (doc/pta_error_model_design_note.md section 4) ----
#define PTA_IMP_QUANT       0x01u
#define PTA_IMP_THERMAL     0x02u
#define PTA_IMP_SHOT        0x04u
#define PTA_IMP_DRIFT       0x08u
#define PTA_IMP_XTALK       0x10u
#define PTA_IMP_MZM_NL      0x20u   // no phase in this build: a start with it is refused
#define PTA_IMP_PROG_ERR    0x40u

#define PTA_BITS_FIELDS(ba, bw, badc, s) \
    (((ba) & 0xFu) | (((bw) & 0xFu) << 4) | (((badc) & 0xFu) << 8) | (((s) & 0x3Fu) << 12))
#define PTA_CAL_CFG_FIELDS(amp, reps, passes, bank) \
    (((amp) & 0xFu) | (((reps) & 0xFu) << 4) | (((passes) & 3u) << 8) | (((bank) & 1u) << 10))
#define PTA_TRIM_FIELDS(steplog2, clamp) \
    (((steplog2) & 0xFu) | (((clamp) & 0xFFFFu) << 16))

// ---- Precision modes (PREC[2:0]) ----
#define NPU_PREC_INT8   0
#define NPU_PREC_INT16  1
#define NPU_PREC_FP16   2
#define NPU_PREC_BF16   3
#define NPU_PREC_INT4   4

// ---- Hardware limits (RTL defaults; match c930_soc_top.sv) ----
#define NPU_MAX_M   8
#define NPU_MAX_N   12
#define NPU_MAX_K   16
#define NPU_QUEUE_DEPTH 4

// ---- Timeouts ----
#define NPU_DRV_TIMEOUT_FOREVER ((uint64_t)-1ull)

// ---- IO callbacks (receive the full byte address) ----
typedef uint32_t (*npu_drv_read_fn)(uint32_t addr);
typedef void     (*npu_drv_write_fn)(uint32_t addr, uint32_t val);

// ---- One GEMM command ----
typedef struct {
    uint32_t dim_m;    // 1..NPU_MAX_M
    uint32_t dim_n;    // 1..NPU_MAX_N
    uint32_t dim_k;    // 1..NPU_MAX_K
    uint32_t a_base;   // DDR byte address, word-aligned
    uint32_t b_base;   // DDR byte address, word-aligned
    uint32_t c_base;   // DDR byte address, word-aligned
    uint32_t prec;     // NPU_PREC_*
} npu_drv_gemm_t;

// ---- Performance counters (read after drain) ----
typedef struct {
    uint32_t core_cycles;  // CYCLE_LO: core cycles for the LAST command
    uint32_t dma_last;     // DMA_LAST: DMA busy cycles, last completed GEMM
    uint32_t ops;          // OP_COUNT: PE firings, last command
    uint32_t stalls;       // STALL_CT: weight-load cycles, last command.
                           //   Covers every K tile, not just the first: expect
                           //   ~M * ceil(N/NUM_COLS) * ceil(K/NUM_ROWS) * kr*nc.
    uint32_t dma_cycles;   // DMA_CT: live DMA busy cycles (read while busy)
} npu_drv_stats_t;

// ---- Initialization ----

// Use the provided bus callbacks (host side: Verilator AXI, PCIe, ...).
void npu_drv_init(npu_drv_read_fn read_fn, npu_drv_write_fn write_fn);

// Use direct volatile-pointer MMIO (RISC-V firmware with the MMIO region
// mapped uncached at 'base'). Reads/writes go to base + offset.
void npu_drv_mmio(uint32_t base);

// ---- Queue / status ----

// Number of free FIFO slots (0 = full). Never negative.
int  npu_drv_queue_room(void);

// Current FIFO occupancy (0..NPU_QUEUE_DEPTH).
int  npu_drv_queue_occupancy(void);

// Raw STATUS register (see NPU_STATUS_*).
uint32_t npu_drv_status(void);

// Latched ERROR bit (invalid dims programmed). Cleared by the next START.
int  npu_drv_error(void);

// ---- Submission ----

// Program DIMs/bases/PREC and write START. Returns 0 on success,
// -1 if the FIFO is full (START would be silently dropped), -2 on
// invalid dimensions. Does NOT block.
int  npu_drv_submit(const npu_drv_gemm_t *g);

// npu_drv_submit at an explicit NPU base (NPU0_BASE / NPU1_BASE).
int  npu_drv_submit_at(uint32_t base, const npu_drv_gemm_t *g);

// ---- Completion ----

// Wait for a SINGLE command (submitted one at a time): DONE latched then
// BUSY clear. Safe because the START write cleared DONE. Returns 0, or -1
// on timeout (use NPU_DRV_TIMEOUT_FOREVER to block).
int  npu_drv_wait_done(uint64_t timeout_cycles);

// Drain a BATCH of queued commands: spin until occupancy==0 && !BUSY.
// The ONLY correct completion test for queued commands (see header top).
// Returns 0, or -1 on timeout (NPU_DRV_TIMEOUT_FOREVER to block).
int  npu_drv_drain(uint64_t timeout_cycles);

// ---- Performance counters ----
void npu_drv_get_stats(npu_drv_stats_t *st);

#ifdef __cplusplus
}
#endif

#endif // C930_NPU_DRIVER_H
