kubeworkz/grx930/c930/tb/tb_c930_soc_full.sv

// -----------------------------------------------------------------------------
// tb_c930_soc_full.sv
//
// End-to-end test of the GRX930 SoC with AXI4 crossbar.
//
// Test 1: D-cache stress (CPU load/store through crossbar → DDR)
//   - First CPU boot (I-cache clean from power-up)
//   - Reads preloaded words, writes new values, byte-merge test
//   - Pass/fail flag at DDR[0x200]
//
// Test 2: NPU GEMM via CPU firmware
//   - Boots firmware that programs NPU CSR and waits for completion
//
// Test 3: UART TX (CPU MMIO → crossbar → UART)
//   - Boots hand-assembled firmware that sends characters to UART
//   - Verifies TXD line activity
// -----------------------------------------------------------------------------
module tb_c930_soc_full;

  localparam int NUM_ROWS = 8;
  localparam int NUM_COLS = 8;
  localparam int MAX_M    = 8;
  localparam int MAX_K    = 16;
  localparam int MAX_N    = 12;
  localparam int MEM_BYTES = 65536;

  logic clk   = 1'b0;
  logic rst_n = 1'b0;
  logic o_npu_busy, o_npu_done, o_npu_error, o_npu_irq;
  logic o_npu1_busy, o_npu1_done, o_npu1_error, o_npu1_irq;
  logic o_uart_txd;
  logic i_uart_rxd;
  // UART bit period in core cycles (default divisor 53 -> 16 baud ticks/bit)
  localparam int UART_BIT = 54 * 16;

  // Drive one UART frame (start + 8 data LSB-first + stop) into the RX pin.
  // The UART samples mid-bit, so holding each bit for a full bit period is
  // correct regardless of the internal baud phase.
  task automatic uart_send_byte(input logic [7:0] data);
    begin
      i_uart_rxd = 1'b0;                        // start bit
      repeat(UART_BIT) @(posedge clk);
      for (int b = 0; b < 8; b++) begin
        i_uart_rxd = data[b];
        repeat(UART_BIT) @(posedge clk);
      end
      i_uart_rxd = 1'b1;                        // stop bit
      repeat(UART_BIT) @(posedge clk);
    end
  endtask
  logic        tb_wr_en;
  logic [31:0] tb_wr_addr;
  logic [7:0]  tb_wr_data;

  int total_errs;

  // =========================================================================
  // DUT
  // =========================================================================
  c930_soc_top #(
    .NUM_ROWS       (NUM_ROWS),
    .NUM_COLS       (NUM_COLS),
    .MAX_M          (MAX_M),
    .MAX_K          (MAX_K),
    .MAX_N          (MAX_N),
    .MEM_BYTES      (MEM_BYTES),
    .DDR_INIT_FILE  ("sw/npu_ddr_bytes.hex"),
    .BOOT_INIT_FILE ("sw/boot.hex"),
    // Bypass the shared L2 for this iverilog regression: the 64 KB L2 + 4
    // active cores exceed what iverilog simulates at usable speed.  The L2 is
    // covered by tb_l2_coherent (fast, standalone) and tb_quad_isolated.
    .BYPASS_L2 (1'b1)
  ) dut (
    .i_clk       (clk),
    .i_rst_n     (rst_n),
    .o_npu_busy   (o_npu_busy),
    .o_npu_done   (o_npu_done),
    .o_npu_error  (o_npu_error),
    .o_npu_irq    (o_npu_irq),
    .o_npu1_busy  (o_npu1_busy),
    .o_npu1_done  (o_npu1_done),
    .o_npu1_error (o_npu1_error),
    .o_npu1_irq   (o_npu1_irq),
    .o_uart_txd  (o_uart_txd),
    .i_uart_rxd  (i_uart_rxd),
    .i_tb_wr_en  (tb_wr_en),
    .i_tb_wr_addr(tb_wr_addr),
    .i_tb_wr_data(tb_wr_data)
  );

  always #5 clk = ~clk;

  // =========================================================================
  // LCG for deterministic operands
  // =========================================================================
  function [31:0] lcg(input logic [31:0] x);
    logic [63:0] t;
    t   = 64'd1103515245 * x + 64'd12345;
    lcg = t[31:0];
  endfunction

  // =========================================================================
  // DDR preload via testbench port
  // =========================================================================
  task ddr_write_byte(input logic [31:0] addr, input logic [7:0] data);
    begin
      // Direct write to DDR byte array (bypasses port timing issues)
      dut.u_ddr.mem[addr] = data;
    end
  endtask

  task preload_operands(input int M, N, K,
                         input logic [31:0] a_base, b_base,
                         input logic [31:0] seed);
    logic [31:0] v;
    logic [7:0]  b;
    begin
      $display("  [TB] Preloading A (%0dx%0d) B (%0dx%0d)", M, K, K, N);
      v = seed;
      for (int mi = 0; mi < M; mi++)
        for (int ki = 0; ki < K; ki++) begin
          v = lcg(v); b = v[7:0];
          if (b == 8'd0) b = 8'd1;
          ddr_write_byte(a_base + mi * K + ki, b);
        end
      v = seed + 32'h1000;
      for (int ki = 0; ki < K; ki++)
        for (int ni = 0; ni < N; ni++) begin
          v = lcg(v); b = v[7:0];
          if (b == 8'd0) b = 8'd1;
          ddr_write_byte(b_base + ki * N + ni, b);
        end
    end
  endtask

  // =========================================================================
  // UART TX monitor
  // =========================================================================
  localparam int BAUD_DIV = 868;
  logic        uart_busy;
  logic [3:0]  uart_bit_cnt, uart_bit_idx;
  logic [7:0]  uart_sr;
  logic        uart_prev_txd;
  int          uart_bytes_rx;

  always_ff @(posedge clk or negedge rst_n) begin
    if (!rst_n) begin
      uart_busy    <= 1'b0;
      uart_bit_cnt <= '0;
      uart_bit_idx <= '0;
      uart_sr      <= '0;
      uart_prev_txd <= 1'b1;
      uart_bytes_rx <= 0;
    end else begin
      uart_prev_txd <= o_uart_txd;
      if (!uart_busy) begin
        if (uart_prev_txd && !o_uart_txd) begin
          uart_busy    <= 1'b1;
          uart_bit_cnt <= '0;
          uart_bit_idx <= 4'd7;
        end
      end else begin
        if (uart_bit_idx == 0 && uart_bit_cnt == 4'd8) begin
          $write("%c", uart_sr);
          uart_bytes_rx <= uart_bytes_rx + 1;
          uart_busy <= 1'b0;
        end else begin
          if (uart_bit_cnt < BAUD_DIV - 1)
            uart_bit_cnt <= uart_bit_cnt + 1;
          else begin
            uart_bit_cnt <= '0;
            uart_sr[uart_bit_idx] <= o_uart_txd;
            uart_bit_idx <= uart_bit_idx - 1;
          end
        end
      end
    end
  end

  // =========================================================================
  // Main test sequence
  // =========================================================================
  initial begin
    $dumpfile("build/tb_c930_soc_full.vcd");
    $dumpvars(0, tb_c930_soc_full);
    total_errs = 0;
    // Initialize preload port + UART RX idle
    tb_wr_en   = 1'b0;
    tb_wr_addr = 32'd0;
    tb_wr_data = 8'd0;
    i_uart_rxd = 1'b1;

    // =========================================================================
    // Test 1: D-cache stress (CPU load/store through crossbar → DDR)
    //
    // This is the FIRST CPU boot, so the I-cache is clean from power-up.
    // Loads a hand-assembled firmware that:
    //   Phase 1: Reads 4 preloaded words from DDR[0x100-0x10F], verifies
    //   Phase 2: Writes new values, reads back, verifies
    //   Phase 3: Byte stores (SB) then word load (LW), verifies merging
    //   On pass: writes 0x12345678 to DDR[0x200]
    //   On fail: writes 0 to DDR[0x200]
    // =========================================================================
    $display("\n========================================");
    $display("  TEST 1: D-cache stress (load/store through crossbar)");
    $display("========================================");
    begin
      int dc_errs;
      dc_errs = 0;

      // Preload test data: 1 word at DDR[0x100] = 0x00000001
      ddr_write_byte(32'h100, 8'h01);
      ddr_write_byte(32'h101, 8'h00);
      ddr_write_byte(32'h102, 8'h00);
      ddr_write_byte(32'h103, 8'h00);
      $display("  [TB] Preloaded DDR[0x100] = 1");

      // Load 8-instruction D-cache firmware at DDR[0x000] (fits in ONE cache line)
      // 0x00: lui  x10, 0
      // 0x04: addi x10, x10, 0x100
      // 0x08: lw   x15, 0(x10)       # x15 = mem[0x100]
      // 0x0C: addi x14, x0, 1
      // 0x10: bne  x15, x14, +0x10   # fail -> 0x20 (hangs)
      // 0x14: lui  x17, 0x12345
      // 0x18: addi x17, x17, 0x678
      // 0x1C: sw   x17, 0(x10)       # mem[0x100] = 0x12345678 (PASS)
      begin
        logic [31:0] fw [0:7];
        fw[0] = 32'h00000537;  // lui  x10, 0
        fw[1] = 32'h10050513;  // addi x10, x10, 0x100
        fw[2] = 32'h00052783;  // lw   x15, 0(x10)
        fw[3] = 32'h00100713;  // addi x14, x0, 1
        fw[4] = 32'h00e79863;  // bne  x15, x14, +0x10 -> 0x20
        fw[5] = 32'h123458b7;  // lui  x17, 0x12345
        fw[6] = 32'h67888893;  // addi x17, x17, 0x678
        fw[7] = 32'h01152023;  // sw   x17, 0(x10)

        for (int i = 0; i < 8; i++) begin
          ddr_write_byte(i*4 + 0, fw[i][7:0]);
          ddr_write_byte(i*4 + 1, fw[i][15:8]);
          ddr_write_byte(i*4 + 2, fw[i][23:16]);
          ddr_write_byte(i*4 + 3, fw[i][31:24]);
        end
        $display("  [TB] D-cache test firmware loaded (%0d bytes, 1 cache line)", 8*4);
      end

      // Reset CPU (first boot - I-cache clean from power-up)
      rst_n = 1'b0;
      repeat(10) @(posedge clk);
      rst_n = 1'b1;

      // Wait for firmware: pass writes 0x12345678 to DDR[0x100], fail hangs
      begin : wait_dcache
        int dc_cnt;
        dc_cnt = 0;
        forever begin
          @(posedge clk);
          dc_cnt = dc_cnt + 1;
          if (dc_cnt > 10_000) begin
            $error("  [FAIL] D-cache test TIMEOUT after %0d cycles", dc_cnt);
            dc_errs = dc_errs + 1;
            disable wait_dcache;
          end
          // Check pass flag at DDR[0x100]
          if (dc_cnt > 50 && dc_cnt % 500 == 0) begin
            logic [7:0] b0, b1, b2, b3;
            b0 = dut.u_ddr.mem[32'h100];
            b1 = dut.u_ddr.mem[32'h101];
            b2 = dut.u_ddr.mem[32'h102];
            b3 = dut.u_ddr.mem[32'h103];
            if ({b3, b2, b1, b0} == 32'h12345678) begin
              $display("  [PASS] D-cache: LW/SW through crossbar verified (0x%08h) at cycle %0d",
                       {b3, b2, b1, b0}, dc_cnt);
              disable wait_dcache;
            end
          end
        end
      end

      // Final check
      begin
        logic [7:0] b0, b1, b2, b3;
        b0 = dut.u_ddr.mem[32'h100];
        b1 = dut.u_ddr.mem[32'h101];
        b2 = dut.u_ddr.mem[32'h102];
        b3 = dut.u_ddr.mem[32'h103];
        if ({b3, b2, b1, b0} == 32'h12345678) begin
          $display("  [PASS] D-cache: all checks passed (0x%08h)", {b3, b2, b1, b0});
        end else begin
          $error("  [FAIL] D-cache: expected 0x12345678, got 0x%08h", {b3, b2, b1, b0});
          dc_errs = dc_errs + 1;
        end
      end
      total_errs = total_errs + dc_errs;
    end

    // =========================================================================
    // Test 2: NPU GEMM via CPU firmware
    //
    // Boot the NPU firmware that programs the NPU CSR and waits for
    // completion. This exercises: CPU boot → DDR fetch → MMIO → NPU DMA.
    //
    // NOTE: Test 1 overwrote DDR[0x000-0x0C3] with D-cache firmware.
    // We must reload the NPU firmware bytes before booting.
    // =========================================================================
    $display("\n========================================");
    $display("  TEST 2: NPU GEMM via CPU firmware");
    $display("========================================");
    begin
      // Preload A/B operands for 4×4×4 GEMM
      preload_operands(4, 4, 4, 32'h8000, 32'h8400, 32'h1234_5678);

      // Write DIMS (M, N, K) to DDR at DIMS_ADDR (0x9400)
      begin
        logic [31:0] dims_addr;
        dims_addr = 32'h9400;
        ddr_write_byte(dims_addr + 0, 8'd4);   // M
        ddr_write_byte(dims_addr + 1, 8'd0);
        ddr_write_byte(dims_addr + 2, 8'd0);
        ddr_write_byte(dims_addr + 3, 8'd0);
        ddr_write_byte(dims_addr + 4, 8'd4);   // N
        ddr_write_byte(dims_addr + 5, 8'd0);
        ddr_write_byte(dims_addr + 6, 8'd0);
        ddr_write_byte(dims_addr + 7, 8'd0);
        ddr_write_byte(dims_addr + 8, 8'd4);   // K
        ddr_write_byte(dims_addr + 9, 8'd0);
        ddr_write_byte(dims_addr + 10, 8'd0);
        ddr_write_byte(dims_addr + 11, 8'd0);
      end

      // Reload NPU firmware into DDR (Test 1 overwrote the first 196 bytes)
      begin
        int fw_fd;
        logic [7:0] fw_byte;
        int fw_addr;
        fw_fd = $fopen("sw/npu_ddr_bytes.hex", "r");
        if (fw_fd != 0) begin
          fw_addr = 0;
          while (!$feof(fw_fd) && fw_addr < MEM_BYTES) begin
            if ($fscanf(fw_fd, "%2h", fw_byte) == 1) begin
              ddr_write_byte(fw_addr[31:0], fw_byte);
              fw_addr = fw_addr + 1;
            end
          end
          $fclose(fw_fd);
          $display("  [TB] Reloaded %0d firmware bytes into DDR", fw_addr);
        end else begin
          $display("  [TB] WARNING: Could not open npu_ddr_bytes.hex, using INIT_FILE data");
        end
      end

      // Reset CPU to boot from NPU firmware (second boot)
      rst_n = 1'b0;
      repeat(20) @(posedge clk);
      rst_n = 1'b1;

      // Wait for NPU completion
      begin : wait_npu
        int poll_cnt;
        poll_cnt = 0;
        forever begin
          @(posedge clk);
          poll_cnt = poll_cnt + 1;

          if (o_npu_done) begin
            $display("  [PASS] NPU GEMM completed after %0d cycles", poll_cnt);
            disable wait_npu;
          end
          if (o_npu_error) begin
            $error("  [FAIL] NPU reported error after %0d cycles", poll_cnt);
            total_errs = total_errs + 1;
            disable wait_npu;
          end
          if (poll_cnt > 200_000) begin
            $error("[TIMEOUT] NPU did not complete in %0d cycles", poll_cnt);
            total_errs = total_errs + 1;
            disable wait_npu;
          end
        end
      end
    end

    // =========================================================================
    // Test 3: UART TX (CPU MMIO → crossbar → UART)
    //
    // Boot hand-assembled firmware that sends "UART OK\n" to the UART TX
    // peripheral, then verify the TXD line shows activity.
    // =========================================================================
    $display("\n========================================");
    $display("  TEST 3: UART TX (CPU MMIO → crossbar → UART)");
    $display("========================================");
    begin
      int uart_errs;
      uart_errs = 0;

      // Hand-assembled UART test firmware (loaded into DDR at 0x0)
      begin
        logic [31:0] fw [0:17];
        fw[0]  = 32'h40001537;  // lui  x10, 0x40001  (UART base = 0x4000_1000)
        fw[1]  = 32'h05500593;  // addi x11, x0, 0x55   ('U')
        fw[2]  = 32'h00b50023;  // sb   x11, 0(x10)
        fw[3]  = 32'h04100593;  // addi x11, x0, 0x41   ('A')
        fw[4]  = 32'h00b50023;  // sb   x11, 0(x10)
        fw[5]  = 32'h05200593;  // addi x11, x0, 0x52   ('R')
        fw[6]  = 32'h00b50023;  // sb   x11, 0(x10)
        fw[7]  = 32'h05400593;  // addi x11, x0, 0x54   ('T')
        fw[8]  = 32'h00b50023;  // sb   x11, 0(x10)
        fw[9]  = 32'h02000593;  // addi x11, x0, 0x20   (' ')
        fw[10] = 32'h00b50023;  // sb   x11, 0(x10)
        fw[11] = 32'h04f00593;  // addi x11, x0, 0x4F   ('O')
        fw[12] = 32'h00b50023;  // sb   x11, 0(x10)
        fw[13] = 32'h04b00593;  // addi x11, x0, 0x4B   ('K')
        fw[14] = 32'h00b50023;  // sb   x11, 0(x10)
        fw[15] = 32'h00a00593;  // addi x11, x0, 0x0A   ('\n')
        fw[16] = 32'h00b50023;  // sb   x11, 0(x10)
        fw[17] = 32'h0000006f;  // j self (loop forever)

        for (int i = 0; i < 18; i++) begin
          ddr_write_byte(i*4 + 0, fw[i][7:0]);
          ddr_write_byte(i*4 + 1, fw[i][15:8]);
          ddr_write_byte(i*4 + 2, fw[i][23:16]);
          ddr_write_byte(i*4 + 3, fw[i][31:24]);
        end
        $display("  [TB] UART test firmware loaded (%0d bytes)", 18*4);
      end

      // Clear UART RX buffer
      uart_bytes_rx = 0;

      // Reset CPU to boot from UART firmware (third boot)
      rst_n = 1'b0;
      repeat(10) @(posedge clk);
      rst_n = 1'b1;

      // Let CPU execute UART firmware
      repeat(100) @(posedge clk);
      repeat(2000) @(posedge clk);

      // Check TXD line for activity
      begin
        int txd_lo_cnt;
        txd_lo_cnt = 0;
        repeat(50000) begin
          @(posedge clk);
          if (!o_uart_txd) txd_lo_cnt = txd_lo_cnt + 1;
        end

        if (txd_lo_cnt > 100) begin
          $display("  [PASS] UART TX: txd toggled %0d cycles (data is being serialized)", txd_lo_cnt);
        end else begin
          $error("  [FAIL] UART TX: txd idle (only %0d low cycles)", txd_lo_cnt);
          uart_errs = uart_errs + 1;
        end
      end
      total_errs = total_errs + uart_errs;
    end

    // =========================================================================
    // Test 4: Mixed-precision varying-shape queue drain + full C verification
    //
    // Phase 1: CPU boots GEMM firmware -> queues 4 GEMMs -> polls completion
    // Phase 2: CPU boots verification firmware -> reads all 21 C elements of
    //          GEMM1 via D-cache LW -> compares with expected FP32 8.0, then
    //          reads all C elements of GEMM3 (INT4), GEMM0 (INT8) and GEMM2
    //          (BF16) -> all compare vs expected tables (72 elements total)
    //
    //   GEMM0: INT8  3x5x8,  all 1s  -> C[0][0] = 8   (INT32)
    //   GEMM1: FP16  7x3x8,  all 1.0 -> C[m][n] = 8.0 (FP32 0x41000000) ALL 21
    //   GEMM2: BF16  2x12x8, all 1.0 -> C[0][0] = 8.0 (FP32 0x41000000)
    //   GEMM3: INT4  3x4x5, signed pattern -> 12 unique C values (table-verified)
    // =========================================================================
    $display("\n========================================");
    $display("  TEST 4: Mixed-precision + full C verification");
    $display("========================================");
    begin
      int mg_errs;
      mg_errs = 0;

      // Reload NPU firmware from hex file
      begin
        int fw_fd;
        logic [7:0] fw_byte;
        int fw_addr;
        fw_fd = $fopen("sw/npu_ddr_bytes.hex", "r");
        if (fw_fd != 0) begin
          fw_addr = 0;
          while (!$feof(fw_fd) && fw_addr < MEM_BYTES) begin
            if ($fscanf(fw_fd, "%2h", fw_byte) == 1) begin
              ddr_write_byte(fw_addr[31:0], fw_byte);
              fw_addr = fw_addr + 1;
            end
          end
          $fclose(fw_fd);
          $display("  [TB] Reloaded %0d firmware bytes into DDR", fw_addr);
        end
      end

      // ---- Phase 1: GEMM firmware ----
      begin
        logic [31:0] fw [0:110];
        fw[ 0] = 32'h40000537;  // lui  x10, 0x40000 (MMIO_BASE)
        fw[ 1] = 32'h00050513;  // addi x10, x10, 0
        fw[ 2] = 32'h000005B7;  // lui  x11, 0
        fw[ 3] = 32'h00358593;  // addi x11, x11, 3    DIM_M=3
        fw[ 4] = 32'h00B52423;  // sw   x11, 0x08(x10)
        fw[ 5] = 32'h000005B7;  // lui  x11, 0
        fw[ 6] = 32'h00558593;  // addi x11, x11, 5    DIM_N=5
        fw[ 7] = 32'h00B52623;  // sw   x11, 0x0C(x10)
        fw[ 8] = 32'h000005B7;  // lui  x11, 0
        fw[ 9] = 32'h00858593;  // addi x11, x11, 8    DIM_K=8
        fw[10] = 32'h00B52823;  // sw   x11, 0x10(x10)
        fw[11] = 32'h000085B7;  // lui  x11, 0x8
        fw[12] = 32'h00058593;  // addi x11, x11, 0    A=0x8000
        fw[13] = 32'h00B52A23;  // sw   x11, 0x14(x10)
        fw[14] = 32'h000085B7;  // lui  x11, 0x8
        fw[15] = 32'h20058593;  // addi x11, x11, 0x200 B=0x8200
        fw[16] = 32'h00B52C23;  // sw   x11, 0x18(x10)
        fw[17] = 32'h000085B7;  // lui  x11, 0x8
        fw[18] = 32'h40058593;  // addi x11, x11, 0x400 C=0x8400
        fw[19] = 32'h00B52E23;  // sw   x11, 0x1C(x10)
        fw[20] = 32'h000005B7;  // lui  x11, 0
        fw[21] = 32'h00058593;  // addi x11, x11, 0    PREC=0 (INT8)
        fw[22] = 32'h02B52023;  // sw   x11, 0x20(x10)
        fw[23] = 32'h02052583;  // lw   x11, 0x20(x10) barrier
        fw[24] = 32'h00100593;  // addi x11, x0, 1
        fw[25] = 32'h00B52023;  // sw   x11, 0x00(x10) START
        fw[26] = 32'h000005B7;  // lui  x11, 0
        fw[27] = 32'h00758593;  // addi x11, x11, 7    DIM_M=7
        fw[28] = 32'h00B52423;  // sw   x11, 0x08(x10)
        fw[29] = 32'h000005B7;  // lui  x11, 0
        fw[30] = 32'h00358593;  // addi x11, x11, 3    DIM_N=3
        fw[31] = 32'h00B52623;  // sw   x11, 0x0C(x10)
        fw[32] = 32'h000005B7;  // lui  x11, 0
        fw[33] = 32'h00858593;  // addi x11, x11, 8    DIM_K=8
        fw[34] = 32'h00B52823;  // sw   x11, 0x10(x10)
        fw[35] = 32'h000095B7;  // lui  x11, 0x9
        fw[36] = 32'h80058593;  // addi x11, x11, 0x800 A=0x8800 (7*8*2=112B)
        fw[37] = 32'h00B52A23;  // sw   x11, 0x14(x10)
        fw[38] = 32'h000095B7;  // lui  x11, 0x9
        fw[39] = 32'hA0058593;  // addi x11, x11, 0xA00 B=0x8A00 (8*3*2=48B)
        fw[40] = 32'h00B52C23;  // sw   x11, 0x18(x10)
        fw[41] = 32'h000095B7;  // lui  x11, 0x9
        fw[42] = 32'hC0058593;  // addi x11, x11, 0xC00 C=0x8C00
        fw[43] = 32'h00B52E23;  // sw   x11, 0x1C(x10)
        fw[44] = 32'h000005B7;  // lui  x11, 0
        fw[45] = 32'h00258593;  // addi x11, x11, 2    PREC=2 (FP16)
        fw[46] = 32'h02B52023;  // sw   x11, 0x20(x10)
        fw[47] = 32'h02052583;  // lw   x11, 0x20(x10) barrier
        fw[48] = 32'h00100593;  // addi x11, x0, 1
        fw[49] = 32'h00B52023;  // sw   x11, 0x00(x10) START
        fw[50] = 32'h000005B7;  // lui  x11, 0
        fw[51] = 32'h00258593;  // addi x11, x11, 2    DIM_M=2
        fw[52] = 32'h00B52423;  // sw   x11, 0x08(x10)
        fw[53] = 32'h000005B7;  // lui  x11, 0
        fw[54] = 32'h00C58593;  // addi x11, x11, 12   DIM_N=12
        fw[55] = 32'h00B52623;  // sw   x11, 0x0C(x10)
        fw[56] = 32'h000005B7;  // lui  x11, 0
        fw[57] = 32'h00858593;  // addi x11, x11, 8    DIM_K=8
        fw[58] = 32'h00B52823;  // sw   x11, 0x10(x10)
        fw[59] = 32'h000095B7;  // lui  x11, 0x9
        fw[60] = 32'h00058593;  // addi x11, x11, 0    A=0x9000 (2*8*2=32B)
        fw[61] = 32'h00B52A23;  // sw   x11, 0x14(x10)
        fw[62] = 32'h000095B7;  // lui  x11, 0x9
        fw[63] = 32'h20058593;  // addi x11, x11, 0x200 B=0x9200 (8*12*2=192B)
        fw[64] = 32'h00B52C23;  // sw   x11, 0x18(x10)
        fw[65] = 32'h000095B7;  // lui  x11, 0x9
        fw[66] = 32'h40058593;  // addi x11, x11, 0x400 C=0x9400
        fw[67] = 32'h00B52E23;  // sw   x11, 0x1C(x10)
        fw[68] = 32'h000005B7;  // lui  x11, 0
        fw[69] = 32'h00358593;  // addi x11, x11, 3    PREC=3 (BF16)
        fw[70] = 32'h02B52023;  // sw   x11, 0x20(x10)
        fw[71] = 32'h02052583;  // lw   x11, 0x20(x10) barrier
        fw[72] = 32'h00100593;  // addi x11, x0, 1
        fw[73] = 32'h00B52023;  // sw   x11, 0x00(x10) START
        fw[74] = 32'h000005B7;  // lui  x11, 0
        fw[75] = 32'h00358593;  // addi x11, x11, 3    DIM_M=3
        fw[76] = 32'h00B52423;  // sw   x11, 0x08(x10)
        fw[77] = 32'h000005B7;  // lui  x11, 0
        fw[78] = 32'h00458593;  // addi x11, x11, 4    DIM_N=4
        fw[79] = 32'h00B52623;  // sw   x11, 0x0C(x10)
        fw[80] = 32'h000005B7;  // lui  x11, 0
        fw[81] = 32'h00558593;  // addi x11, x11, 5    DIM_K=5
        fw[82] = 32'h00B52823;  // sw   x11, 0x10(x10)
        fw[83] = 32'h0000A5B7;  // lui  x11, 0xA
        fw[84] = 32'h00058593;  // addi x11, x11, 0    A=0xA000 (3*5=15 nibbles=8B)
        fw[85] = 32'h00B52A23;  // sw   x11, 0x14(x10)
        fw[86] = 32'h0000A5B7;  // lui  x11, 0xA
        fw[87] = 32'h20058593;  // addi x11, x11, 0x200 B=0xA200 (5*4=20 nibbles=10B)
        fw[88] = 32'h00B52C23;  // sw   x11, 0x18(x10)
        fw[89] = 32'h0000A5B7;  // lui  x11, 0xA
        fw[90] = 32'h40058593;  // addi x11, x11, 0x400 C=0xA400
        fw[91] = 32'h00B52E23;  // sw   x11, 0x1C(x10)
        fw[92] = 32'h000005B7;  // lui  x11, 0
        fw[93] = 32'h00458593;  // addi x11, x11, 4    PREC=4 (INT4)
        fw[94] = 32'h02B52023;  // sw   x11, 0x20(x10)
        fw[95] = 32'h02052583;  // lw   x11, 0x20(x10) barrier
        fw[96] = 32'h00100593;  // addi x11, x0, 1
        fw[97] = 32'h00B52023;  // sw   x11, 0x00(x10) START
        fw[98] = 32'h02052583;  // lw   x11, 0x20(x10) barrier read
        // Queue-drain poll: DONE/BUSY polling is racy for batched queues
        // (done_latch is sticky across queued commands and busy drops in the
        // P_DONE->dispatch bubble), so wait for QUEUE_STAT occupancy==0 AND
        // STATUS busy==0 — that guarantees all 4 GEMMs have finished.
        fw[99] = 32'h03852583;  // lw   x11, 0x38(x10) QUEUE_STAT
        fw[100] = 32'h00F5F593;  // andi x11, x11, 15   occupancy bits[3:0]
        fw[101] = 32'hFE059CE3;  // bne  x11, x0, -8   poll while queued
        fw[102] = 32'h00452583;  // lw   x11, 0x04(x10) STATUS
        fw[103] = 32'h0015F593;  // andi x11, x11, 1    BUSY bit
        fw[104] = 32'hFE059CE3;  // bne  x11, x0, -8   poll while busy
        fw[105] = 32'h0000B7B7;  // lui  x15, 0xB
        fw[106] = 32'h30078793;  // addi x15, x15, 0x300 DONE_ADDR=0xB300
        fw[107] = 32'hDEADC837;  // lui  x16, 0xDEADC
        fw[108] = 32'hEEF80813;  // addi x16, x16, 0xEEF DONE_MAGIC=0xDEADBEEF
        fw[109] = 32'h0107A023;  // sw   x16, 0(x15)
        fw[110] = 32'h0000006F;  // jal  x0, 0  self-loop
        for (int i = 0; i < 111; i++) begin
          ddr_write_byte(i*4 + 0, fw[i][7:0]);
          ddr_write_byte(i*4 + 1, fw[i][15:8]);
          ddr_write_byte(i*4 + 2, fw[i][23:16]);
          ddr_write_byte(i*4 + 3, fw[i][31:24]);
        end
        $display("  [TB] Phase 1 GEMM firmware loaded (%0d bytes)", 111*4);
      end

      // --- Preload A/B operands ---
      // GEMM 0: INT8 3x5x8 all 1s - A=24B @0x8000, B=40B @0x8200
      begin
        for (int i = 0; i < 24; i++)
          ddr_write_byte(32'h8000 + i, 8'd1);
        for (int i = 0; i < 40; i++)
          ddr_write_byte(32'h8200 + i, 8'd1);
        $display("  [TB] GEMM0: INT8 3x5x8 all 1s (C[0][0] expect 0x00000008)");
      end
      // GEMM 1: FP16 7x3x8 all 1.0 - A=112B @0x8800, B=48B @0x8A00
      begin
        for (int i = 0; i < 56; i++) begin
          ddr_write_byte(32'h8800 + i*2 + 0, 8'h00);
          ddr_write_byte(32'h8800 + i*2 + 1, 8'h3C);
        end
        for (int i = 0; i < 24; i++) begin
          ddr_write_byte(32'h8A00 + i*2 + 0, 8'h00);
          ddr_write_byte(32'h8A00 + i*2 + 1, 8'h3C);
        end
        $display("  [TB] GEMM1: FP16 7x3x8 all 1.0 (C[0][0] expect 0x41000000)");
      end
      // GEMM 2: BF16 2x12x8 all 1.0 - A=32B @0x9000, B=192B @0x9200
      begin
        for (int i = 0; i < 16; i++) begin
          ddr_write_byte(32'h9000 + i*2 + 0, 8'h80);
          ddr_write_byte(32'h9000 + i*2 + 1, 8'h3F);
        end
        for (int i = 0; i < 96; i++) begin
          ddr_write_byte(32'h9200 + i*2 + 0, 8'h80);
          ddr_write_byte(32'h9200 + i*2 + 1, 8'h3F);
        end
        $display("  [TB] GEMM2: BF16 2x12x8 all 1.0 (C[0][0] expect 0x41000000)");
      end
      // GEMM 3: INT4 3x4x5 signed pattern - A=15 nibbles (8B) @0xA000, B=20 nibbles (10B) @0xA200
      //   A (3x5): [ 1,-2, 3,-4, 5 | -5, 4,-3, 2,-1 |  2,-1, 4,-3, 1]
      //   B (5x4): [ 1,-1, 2,-2 | -2, 1,-1, 2 | 3,-2, 1,-1 | -1, 3,-2, 1 | -2, 1,-3, 2]
      //   All 12 C values unique -> row/col permutation bugs fail loudly
      begin
        // INT4 packing: element e -> byte e/2, nibble (e%2)*4 (low nibble first)
        begin : gemm3_a
          logic [7:0] abytes [0:7];
          abytes[0] = 8'hE1; abytes[1] = 8'hC3; abytes[2] = 8'hB5; abytes[3] = 8'hD4;
          abytes[4] = 8'hF2; abytes[5] = 8'hF2; abytes[6] = 8'hD4; abytes[7] = 8'h01;
          for (int i = 0; i < 8; i++)
            ddr_write_byte(32'hA000 + i, abytes[i]);
        end
        begin : gemm3_b
          logic [7:0] bbytes [0:9];
          bbytes[0] = 8'hF1; bbytes[1] = 8'hE2; bbytes[2] = 8'h1E; bbytes[3] = 8'h2F;
          bbytes[4] = 8'hE3; bbytes[5] = 8'hF1; bbytes[6] = 8'h3F; bbytes[7] = 8'h1E;
          bbytes[8] = 8'h1E; bbytes[9] = 8'h2D;
          for (int i = 0; i < 10; i++)
            ddr_write_byte(32'hA200 + i, bbytes[i]);
        end
        $display("  [TB] GEMM3: INT4 3x4x5 signed pattern (12 unique C values)");
      end
      // Expected C table for GEMM0 (15 words, all 8) @0xB100
      begin : gemm0_exp
        for (int i = 0; i < 15; i++) begin
          ddr_write_byte(32'hB100 + i*4 + 0, 8'h08);
          ddr_write_byte(32'hB100 + i*4 + 1, 8'h00);
          ddr_write_byte(32'hB100 + i*4 + 2, 8'h00);
          ddr_write_byte(32'hB100 + i*4 + 3, 8'h00);
        end
      end
      // Expected C table for GEMM2 (24 words, all FP32 8.0) @0xB200
      begin : gemm2_exp
        for (int i = 0; i < 24; i++) begin
          ddr_write_byte(32'hB200 + i*4 + 0, 8'h00);
          ddr_write_byte(32'hB200 + i*4 + 1, 8'h00);
          ddr_write_byte(32'hB200 + i*4 + 2, 8'h00);
          ddr_write_byte(32'hB200 + i*4 + 3, 8'h41);
        end
      end
      // Expected C table for GEMM3 (12 words) @0xB000
      begin : gemm3_exp
        logic [31:0] ewords [0:11];
        // C = A*B: [8,-16,0,-3 | -22,20,-18,21 | 17,-19,12,-11]
        ewords[ 0] = 32'h00000008; ewords[ 1] = 32'hFFFFFFF0; ewords[ 2] = 32'h00000000; ewords[ 3] = 32'hFFFFFFFD;
        ewords[ 4] = 32'hFFFFFFEA; ewords[ 5] = 32'h00000014; ewords[ 6] = 32'hFFFFFFEE; ewords[ 7] = 32'h00000015;
        ewords[ 8] = 32'h00000011; ewords[ 9] = 32'hFFFFFFED; ewords[10] = 32'h0000000C; ewords[11] = 32'hFFFFFFF5;
        for (int i = 0; i < 12; i++) begin
          ddr_write_byte(32'hB000 + i*4 + 0, ewords[i][7:0]);
          ddr_write_byte(32'hB000 + i*4 + 1, ewords[i][15:8]);
          ddr_write_byte(32'hB000 + i*4 + 2, ewords[i][23:16]);
          ddr_write_byte(32'hB000 + i*4 + 3, ewords[i][31:24]);
        end
        // Guard: all 12 expected values must be unique so row/col permutation
        // bugs fail loudly (all-equal values would silently mask them)
        begin : gemm3_unique
          int dup_cnt;
          dup_cnt = 0;
          for (int i = 0; i < 12; i++)
            for (int j = i + 1; j < 12; j++)
              if (ewords[i] == ewords[j]) begin
                $error("  [FAIL] GEMM3 expected values not unique: ewords[%0d]==ewords[%0d]==0x%08h",
                        i, j, ewords[i]);
                dup_cnt = dup_cnt + 1;
              end
          if (dup_cnt == 0)
            $display("  [PASS] GEMM3 expected table: 12 unique values");
          else
            mg_errs = mg_errs + dup_cnt;
        end
      end

      // Initialize DONE_ADDR to 0
      ddr_write_byte(32'hB300, 8'h00);
      ddr_write_byte(32'hB301, 8'h00);
      ddr_write_byte(32'hB302, 8'h00);
      ddr_write_byte(32'hB303, 8'h00);

      // Reset CPU and boot Phase 1
      rst_n = 1'b0;
      repeat(10) @(posedge clk);
      rst_n = 1'b1;

      // Wait for DONE_MAGIC from Phase 1
      begin : wait_phase1
        int mg_cnt;
        mg_cnt = 0;
        forever begin
          @(posedge clk);
          mg_cnt = mg_cnt + 1;
          if (mg_cnt > 500_000) begin
            $error("  [FAIL] Phase 1 TIMEOUT after %0d cycles", mg_cnt);
            mg_errs = mg_errs + 1;
            disable wait_phase1;
          end
          begin
            logic [7:0] b0, b1, b2, b3;
            b0 = dut.u_ddr.mem[32'hB300];
            b1 = dut.u_ddr.mem[32'hB301];
            b2 = dut.u_ddr.mem[32'hB302];
            b3 = dut.u_ddr.mem[32'hB303];
            if ({b3, b2, b1, b0} == 32'hDEADBEEF) begin
              $display("  [PASS] Phase 1: all 4 GEMMs completed in %0d cycles", mg_cnt);
              disable wait_phase1;
            end
          end
        end
      end

      // All C matrices (GEMM0/1/2/3) fully verified by the Phase 2 firmware

      // ---- Phase 2: Verification firmware (reads all 21 C elements via D-cache) ----
      // Reload NPU firmware (CPU needs I-cache to boot, but DDR contents preserved)
      begin
        int fw_fd;
        logic [7:0] fw_byte;
        int fw_addr;
        fw_fd = $fopen("sw/npu_ddr_bytes.hex", "r");
        if (fw_fd != 0) begin
          fw_addr = 0;
          while (!$feof(fw_fd) && fw_addr < MEM_BYTES) begin
            if ($fscanf(fw_fd, "%2h", fw_byte) == 1) begin
              ddr_write_byte(fw_addr[31:0], fw_byte);
              fw_addr = fw_addr + 1;
            end
          end
          $fclose(fw_fd);
        end
      end

      // Load Phase 2 verification firmware into DDR[0x000]
      begin
        logic [31:0] vfw [0:110];
        vfw[ 0] = 32'h00009537;  // lui  x10, 0x9
        vfw[ 1] = 32'hC0050513;  // addi x10, x10, 0xC00   x10 = 0x8C00 (GEMM1 C base)
        vfw[ 2] = 32'h41000737;  // lui  x14, 0x41000  x14 = 0x41000000 (FP32 8.0)
        vfw[ 3] = 32'h00000793;  // addi x15, x0, 0    error mask = 0
        vfw[ 4] = 32'h00000813;  // addi x16, x0, 0    element index = 0
        vfw[ 5] = 32'h00000693;  // addi x13, x0, 0    row counter = 0
        vfw[ 6] = 32'h00700A13;  // addi x20, x0, 7    NUM_ROWS
        vfw[ 7] = 32'h00300A93;  // addi x21, x0, 3    NUM_COLS
        vfw[ 8] = 32'h00000613;  // addi x12, x0, 0    row_loop: col counter = 0
        vfw[ 9] = 32'h00052903;  // lw   x18, 0(x10)   col_loop: load C[row][col]
        vfw[10] = 32'h00E90863;  // beq  x18, x14, +16 if match, skip mismatch
        vfw[11] = 32'h00100993;  // addi x19, x0, 1    mismatch: bit = 1
        vfw[12] = 32'h010999B3;  // sll  x19, x19, x16 shift by element index
        vfw[13] = 32'h0137E7B3;  // or   x15, x15, x19 set bit in error mask
        vfw[14] = 32'h00450513;  // addi x10, x10, 4   next: advance address
        vfw[15] = 32'h00180813;  // addi x16, x16, 1   advance element index
        vfw[16] = 32'h00160613;  // addi x12, x12, 1   advance col counter
        vfw[17] = 32'hFF5640E3;  // blt  x12, x21, col_loop if col < 3, loop
        vfw[18] = 32'h00168693;  // addi x13, x13, 1   advance row counter
        vfw[19] = 32'hFD46CAE3;  // blt  x13, x20, row_loop if row < 7, loop
        vfw[20] = 32'h00000537;  // lui  x10, 0
        vfw[21] = 32'h30050513;  // addi x10, x10, 0x300  verify buffer address
        vfw[22] = 32'h00F52023;  // sw   x15, 0(x10)   store error mask
        vfw[23] = 32'h01052223;  // sw   x16, 4(x10)   store element count
        vfw[24] = 32'h0000A537;  // lui  x10, 0xA
        vfw[25] = 32'h40050513;  // addi x10, x10, 0x400   x10 = 0xA400 (GEMM3 C base)
        vfw[26] = 32'h0000B5B7;  // lui  x11, 0xB
        vfw[27] = 32'h00058593;  // addi x11, x11, 0      x11 = 0xB000 (EXP table)
        vfw[28] = 32'h00000B93;  // addi x23, x0, 0        GEMM3 error mask = 0
        vfw[29] = 32'h00000B13;  // addi x22, x0, 0        GEMM3 element index = 0
        vfw[30] = 32'h00000693;  // addi x13, x0, 0        row counter = 0
        vfw[31] = 32'h00300A13;  // addi x20, x0, 3        NUM_ROWS = 3
        vfw[32] = 32'h00400A93;  // addi x21, x0, 4        NUM_COLS = 4
        vfw[33] = 32'h00000613;  // addi x12, x0, 0        row_loop: col counter = 0
        vfw[34] = 32'h00052903;  // lw   x18, 0(x10)       col_loop: load C[row][col]
        vfw[35] = 32'h0005A883;  // lw   x17, 0(x11)       load expected from table
        vfw[36] = 32'h01190863;  // beq  x18, x17, +16     if match, skip mismatch
        vfw[37] = 32'h00100993;  // addi x19, x0, 1        mismatch: bit = 1
        vfw[38] = 32'h016999B3;  // sll  x19, x19, x22     shift by GEMM3 element index
        vfw[39] = 32'h013BEBB3;  // or   x23, x23, x19     set bit in GEMM3 mask
        vfw[40] = 32'h00450513;  // addi x10, x10, 4       next: advance C address
        vfw[41] = 32'h00458593;  // addi x11, x11, 4       advance EXP address
        vfw[42] = 32'h001B0B13;  // addi x22, x22, 1       advance element index
        vfw[43] = 32'h00160613;  // addi x12, x12, 1       advance col counter
        vfw[44] = 32'hFD564CE3;  // blt  x12, x21, col_loop if col < 4, loop
        vfw[45] = 32'h00168693;  // addi x13, x13, 1       advance row counter
        vfw[46] = 32'hFD46C6E3;  // blt  x13, x20, row_loop if row < 3, loop
        vfw[47] = 32'h00000537;  // lui  x10, 0
        vfw[48] = 32'h30850513;  // addi x10, x10, 0x308   verify buffer addr 2
        vfw[49] = 32'h01752023;  // sw   x23, 0(x10)       store GEMM3 error mask
        vfw[50] = 32'h01652223;  // sw   x22, 4(x10)       store GEMM3 element count
        vfw[51] = 32'h00008537;  // lui  x10, 0x8
        vfw[52] = 32'h40050513;  // addi x10, x10, 0x400   x10 = 0x8400 (GEMM0 C base)
        vfw[53] = 32'h0000B5B7;  // lui  x11, 0xB
        vfw[54] = 32'h10058593;  // addi x11, x11, 0x100   x11 = 0xB100 (EXP table)
        vfw[55] = 32'h00000C13;  // addi x24, x0, 0        GEMM0 error mask = 0
        vfw[56] = 32'h00000C93;  // addi x25, x0, 0        GEMM0 element index = 0
        vfw[57] = 32'h00000693;  // addi x13, x0, 0        row counter = 0
        vfw[58] = 32'h00300A13;  // addi x20, x0, 3        NUM_ROWS = 3
        vfw[59] = 32'h00500A93;  // addi x21, x0, 5        NUM_COLS = 5
        vfw[60] = 32'h00000613;  // addi x12, x0, 0        row_loop: col counter = 0
        vfw[61] = 32'h00052903;  // lw   x18, 0(x10)       col_loop: load C[row][col]
        vfw[62] = 32'h0005A883;  // lw   x17, 0(x11)       load expected from table
        vfw[63] = 32'h01190863;  // beq  x18, x17, +16     if match, skip mismatch
        vfw[64] = 32'h00100993;  // addi x19, x0, 1        mismatch: bit = 1
        vfw[65] = 32'h019999B3;  // sll  x19, x19, x25     shift by GEMM0 element index
        vfw[66] = 32'h013C6C33;  // or   x24, x24, x19     set bit in GEMM0 mask
        vfw[67] = 32'h00450513;  // addi x10, x10, 4       next: advance C address
        vfw[68] = 32'h00458593;  // addi x11, x11, 4       advance EXP address
        vfw[69] = 32'h001C8C93;  // addi x25, x25, 1       advance element index
        vfw[70] = 32'h00160613;  // addi x12, x12, 1       advance col counter
        vfw[71] = 32'hFD564CE3;  // blt  x12, x21, col_loop if col < 5, loop
        vfw[72] = 32'h00168693;  // addi x13, x13, 1       advance row counter
        vfw[73] = 32'hFD46C6E3;  // blt  x13, x20, row_loop if row < 3, loop
        vfw[74] = 32'h00000537;  // lui  x10, 0
        vfw[75] = 32'h31050513;  // addi x10, x10, 0x310   verify buffer addr 3
        vfw[76] = 32'h01852023;  // sw   x24, 0(x10)       store GEMM0 error mask
        vfw[77] = 32'h01952223;  // sw   x25, 4(x10)       store GEMM0 element count
        vfw[78] = 32'h00009537;  // lui  x10, 0x9
        vfw[79] = 32'h40050513;  // addi x10, x10, 0x400   x10 = 0x9400 (GEMM2 C base)
        vfw[80] = 32'h0000B5B7;  // lui  x11, 0xB
        vfw[81] = 32'h20058593;  // addi x11, x11, 0x200   x11 = 0xB200 (EXP table)
        vfw[82] = 32'h00000C13;  // addi x24, x0, 0        GEMM2 error mask = 0
        vfw[83] = 32'h00000C93;  // addi x25, x0, 0        GEMM2 element index = 0
        vfw[84] = 32'h00000693;  // addi x13, x0, 0        row counter = 0
        vfw[85] = 32'h00200A13;  // addi x20, x0, 2        NUM_ROWS = 2
        vfw[86] = 32'h00C00A93;  // addi x21, x0, 12       NUM_COLS = 12
        vfw[87] = 32'h00000613;  // addi x12, x0, 0        row_loop: col counter = 0
        vfw[88] = 32'h00052903;  // lw   x18, 0(x10)       col_loop: load C[row][col]
        vfw[89] = 32'h0005A883;  // lw   x17, 0(x11)       load expected from table
        vfw[90] = 32'h01190863;  // beq  x18, x17, +16     if match, skip mismatch
        vfw[91] = 32'h00100993;  // addi x19, x0, 1        mismatch: bit = 1
        vfw[92] = 32'h019999B3;  // sll  x19, x19, x25     shift by GEMM2 element index
        vfw[93] = 32'h013C6C33;  // or   x24, x24, x19     set bit in GEMM2 mask
        vfw[94] = 32'h00450513;  // addi x10, x10, 4       next: advance C address
        vfw[95] = 32'h00458593;  // addi x11, x11, 4       advance EXP address
        vfw[96] = 32'h001C8C93;  // addi x25, x25, 1       advance element index
        vfw[97] = 32'h00160613;  // addi x12, x12, 1       advance col counter
        vfw[98] = 32'hFD564CE3;  // blt  x12, x21, col_loop if col < 12, loop
        vfw[99] = 32'h00168693;  // addi x13, x13, 1       advance row counter
        vfw[100] = 32'hFD46C6E3;  // blt  x13, x20, row_loop if row < 2, loop
        vfw[101] = 32'h00000537;  // lui  x10, 0
        vfw[102] = 32'h31850513;  // addi x10, x10, 0x318   verify buffer addr 4
        vfw[103] = 32'h01852023;  // sw   x24, 0(x10)       store GEMM2 error mask
        vfw[104] = 32'h01952223;  // sw   x25, 4(x10)       store GEMM2 element count
        vfw[105] = 32'h0000B7B7;  // lui  x15, 0xB
        vfw[106] = 32'h30078793;  // addi x15, x15, 0x300 DONE_ADDR=0xB300
        vfw[107] = 32'hDEADC837;  // lui  x16, 0xDEADC
        vfw[108] = 32'hEEF80813;  // addi x16, x16, 0xEEF DONE_MAGIC
        vfw[109] = 32'h0107A023;  // sw   x16, 0(x15)
        vfw[110] = 32'h0000006F;  // jal  x0, 0  self-loop
        for (int i = 0; i < 111; i++) begin
          ddr_write_byte(i*4 + 0, vfw[i][7:0]);
          ddr_write_byte(i*4 + 1, vfw[i][15:8]);
          ddr_write_byte(i*4 + 2, vfw[i][23:16]);
          ddr_write_byte(i*4 + 3, vfw[i][31:24]);
        end
        $display("  [TB] Phase 2 verification firmware loaded (%0d bytes)", 111*4);
      end

      // Clear DONE_MAGIC so Phase 2 can detect its own completion
      ddr_write_byte(32'hB300, 8'h00);
      ddr_write_byte(32'hB301, 8'h00);
      ddr_write_byte(32'hB302, 8'h00);
      ddr_write_byte(32'hB303, 8'h00);

      // Clear verification buffers (0x300/0x308/0x310 for GEMM1/GEMM3/GEMM0)
      ddr_write_byte(32'h0300, 8'h00);
      ddr_write_byte(32'h0301, 8'h00);
      ddr_write_byte(32'h0302, 8'h00);
      ddr_write_byte(32'h0303, 8'h00);

      // Reset CPU and boot Phase 2
      rst_n = 1'b0;
      repeat(10) @(posedge clk);
      rst_n = 1'b1;


      // Wait for DONE_MAGIC from Phase 2
      begin : wait_phase2
        int mg_cnt;
        mg_cnt = 0;
        forever begin
          @(posedge clk);
          mg_cnt = mg_cnt + 1;
          if (mg_cnt > 500_000) begin
            $error("  [FAIL] Phase 2 TIMEOUT after %0d cycles", mg_cnt);
            mg_errs = mg_errs + 1;
            disable wait_phase2;
          end
          begin
            logic [7:0] b0, b1, b2, b3;
            b0 = dut.u_ddr.mem[32'hB300];
            b1 = dut.u_ddr.mem[32'hB301];
            b2 = dut.u_ddr.mem[32'hB302];
            b3 = dut.u_ddr.mem[32'hB303];
            if ({b3, b2, b1, b0} == 32'hDEADBEEF) begin
              $display("  [PASS] Phase 2: verification complete in %0d cycles", mg_cnt);
              disable wait_phase2;
            end
          end
        end
      end

      // Read verification buffer at DDR[0x300] and check all 21 elements
      begin
        logic [7:0] v0, v1, v2, v3;
        logic [31:0] err_mask;
        v0 = dut.u_ddr.mem[32'h0300];
        v1 = dut.u_ddr.mem[32'h0301];
        v2 = dut.u_ddr.mem[32'h0302];
        v3 = dut.u_ddr.mem[32'h0303];
        err_mask = {v3, v2, v1, v0};
        $display("  [TB] GEMM1 C verification: error mask = 0x%08h (%0d failures)",
                 err_mask, $countones(err_mask));
        if (err_mask == 32'h0000000) begin
          $display("  [PASS] GEMM1: all 21 C elements verified correct (FP32 8.0)");
        end else begin
          // Decode which elements failed
          for (int idx = 0; idx < 21; idx++) begin
            if (err_mask[idx]) begin
              $error("  [FAIL] GEMM1 C[%0d][%0d] wrong (elem %0d)", idx/3, idx%3, idx);
            end
          end
          mg_errs = mg_errs + 1;
        end
      end

      // Read GEMM0 verification buffer at DDR[0x310] and check all 15 elements
      begin
        logic [7:0] v0, v1, v2, v3;
        logic [31:0] err_mask;
        v0 = dut.u_ddr.mem[32'h0310];
        v1 = dut.u_ddr.mem[32'h0311];
        v2 = dut.u_ddr.mem[32'h0312];
        v3 = dut.u_ddr.mem[32'h0313];
        err_mask = {v3, v2, v1, v0};
        $display("  [TB] GEMM0 C verification: error mask = 0x%08h (%0d failures)",
                 err_mask, $countones(err_mask));
        if (err_mask == 32'h0000000) begin
          $display("  [PASS] GEMM0: all 15 C elements verified correct (INT32 8)");
        end else begin
          // Decode which elements failed
          for (int idx = 0; idx < 15; idx++) begin
            if (err_mask[idx]) begin
              $error("  [FAIL] GEMM0 C[%0d][%0d] wrong (elem %0d)", idx/5, idx%5, idx);
            end
          end
          mg_errs = mg_errs + 1;
        end
      end

      // Read GEMM2 verification buffer at DDR[0x318] and check all 24 elements
      begin
        logic [7:0] v0, v1, v2, v3;
        logic [31:0] err_mask;
        v0 = dut.u_ddr.mem[32'h0318];
        v1 = dut.u_ddr.mem[32'h0319];
        v2 = dut.u_ddr.mem[32'h031A];
        v3 = dut.u_ddr.mem[32'h031B];
        err_mask = {v3, v2, v1, v0};
        $display("  [TB] GEMM2 C verification: error mask = 0x%08h (%0d failures)",
                 err_mask, $countones(err_mask));
        if (err_mask == 32'h0000000) begin
          $display("  [PASS] GEMM2: all 24 C elements verified correct (FP32 8.0)");
        end else begin
          // Decode which elements failed
          for (int idx = 0; idx < 24; idx++) begin
            if (err_mask[idx]) begin
              $error("  [FAIL] GEMM2 C[%0d][%0d] wrong (elem %0d)", idx/12, idx%12, idx);
            end
          end
          mg_errs = mg_errs + 1;
        end
      end

      // Read GEMM3 verification buffer at DDR[0x308] and check all 12 elements
      begin
        logic [7:0] v0, v1, v2, v3;
        logic [31:0] err_mask;
        v0 = dut.u_ddr.mem[32'h0308];
        v1 = dut.u_ddr.mem[32'h0309];
        v2 = dut.u_ddr.mem[32'h030A];
        v3 = dut.u_ddr.mem[32'h030B];
        err_mask = {v3, v2, v1, v0};
        $display("  [TB] GEMM3 C verification: error mask = 0x%08h (%0d failures)",
                 err_mask, $countones(err_mask));
        if (err_mask == 32'h0000000) begin
          $display("  [PASS] GEMM3: all 12 C elements verified correct (signed INT4 table)");
        end else begin
          // Decode which elements failed
          for (int idx = 0; idx < 12; idx++) begin
            if (err_mask[idx]) begin
              $error("  [FAIL] GEMM3 C[%0d][%0d] wrong (elem %0d)", idx/4, idx%4, idx);
            end
          end
          mg_errs = mg_errs + 1;
        end
      end

      total_errs = total_errs + mg_errs;
    end

    // =========================================================================
    // Test 5: 6-GEMM queue stress test (fill queue to capacity, drain twice)
    //
    // CMD_QUEUE_DEPTH = 4. Queue 4 GEMMs (fill queue), poll to drain,
    // then queue 2 more (second drain cycle). Exercises:
    //   - Queue fill-to-capacity and backpressure
    //   - DMA dispatch ordering across different shapes
    //   - Bank switching with increasing operand sizes
    //   - Two complete fill/drain cycles
    //
    // GEMMs (all INT8, all 1s, K=4):
    //   GEMM0: 2x2x4  GEMM1: 3x3x4  GEMM2: 4x4x4
    //   GEMM3: 5x3x4  GEMM4: 3x6x4  GEMM5: 6x6x4
    //   All C[0][0] = K = 4
    // =========================================================================
    $display("\n========================================");
    $display("  TEST 5: 6-GEMM queue stress (fill+drain x2)");
    $display("========================================");
    begin
      int mg_errs;
      mg_errs = 0;

      // Reload NPU firmware from hex file
      begin
        int fw_fd;
        logic [7:0] fw_byte;
        int fw_addr;
        fw_fd = $fopen("sw/npu_ddr_bytes.hex", "r");
        if (fw_fd != 0) begin
          fw_addr = 0;
          while (!$feof(fw_fd) && fw_addr < MEM_BYTES) begin
            if ($fscanf(fw_fd, "%2h", fw_byte) == 1) begin
              ddr_write_byte(fw_addr[31:0], fw_byte);
              fw_addr = fw_addr + 1;
            end
          end
          $fclose(fw_fd);
          $display("  [TB] Reloaded %0d firmware bytes into DDR", fw_addr);
        end
      end

      // Load queue-stress firmware
      begin
        logic [31:0] fw [0:124];
        fw[  0] = 32'h40000537;
        fw[  1] = 32'h00050513;
        fw[  2] = 32'h00000593;
        fw[  3] = 32'h02B52023;
        fw[  4] = 32'h02052583;
        fw[  5] = 32'h00200593;
        fw[  6] = 32'h00B52423;
        fw[  7] = 32'h00200593;
        fw[  8] = 32'h00B52623;
        fw[  9] = 32'h00400593;
        fw[ 10] = 32'h00B52823;
        fw[ 11] = 32'h000085B7;
        fw[ 12] = 32'h00058593;
        fw[ 13] = 32'h00B52A23;
        fw[ 14] = 32'h000085B7;
        fw[ 15] = 32'h04058593;
        fw[ 16] = 32'h00B52C23;
        fw[ 17] = 32'h000085B7;
        fw[ 18] = 32'h08058593;
        fw[ 19] = 32'h00B52E23;
        fw[ 20] = 32'h00100593;
        fw[ 21] = 32'h00B52023;
        fw[ 22] = 32'h00300593;
        fw[ 23] = 32'h00B52423;
        fw[ 24] = 32'h00300593;
        fw[ 25] = 32'h00B52623;
        fw[ 26] = 32'h00400593;
        fw[ 27] = 32'h00B52823;
        fw[ 28] = 32'h000085B7;
        fw[ 29] = 32'h10058593;
        fw[ 30] = 32'h00B52A23;
        fw[ 31] = 32'h000085B7;
        fw[ 32] = 32'h14058593;
        fw[ 33] = 32'h00B52C23;
        fw[ 34] = 32'h000085B7;
        fw[ 35] = 32'h18058593;
        fw[ 36] = 32'h00B52E23;
        fw[ 37] = 32'h00100593;
        fw[ 38] = 32'h00B52023;
        fw[ 39] = 32'h00400593;
        fw[ 40] = 32'h00B52423;
        fw[ 41] = 32'h00400593;
        fw[ 42] = 32'h00B52623;
        fw[ 43] = 32'h00400593;
        fw[ 44] = 32'h00B52823;
        fw[ 45] = 32'h000085B7;
        fw[ 46] = 32'h20058593;
        fw[ 47] = 32'h00B52A23;
        fw[ 48] = 32'h000085B7;
        fw[ 49] = 32'h24058593;
        fw[ 50] = 32'h00B52C23;
        fw[ 51] = 32'h000085B7;
        fw[ 52] = 32'h28058593;
        fw[ 53] = 32'h00B52E23;
        fw[ 54] = 32'h00100593;
        fw[ 55] = 32'h00B52023;
        fw[ 56] = 32'h00500593;
        fw[ 57] = 32'h00B52423;
        fw[ 58] = 32'h00300593;
        fw[ 59] = 32'h00B52623;
        fw[ 60] = 32'h00400593;
        fw[ 61] = 32'h00B52823;
        fw[ 62] = 32'h000085B7;
        fw[ 63] = 32'h30058593;
        fw[ 64] = 32'h00B52A23;
        fw[ 65] = 32'h000085B7;
        fw[ 66] = 32'h34058593;
        fw[ 67] = 32'h00B52C23;
        fw[ 68] = 32'h000085B7;
        fw[ 69] = 32'h38058593;
        fw[ 70] = 32'h00B52E23;
        fw[ 71] = 32'h00100593;
        fw[ 72] = 32'h00B52023;
        // Queue-drain poll (see Test 4): occupancy==0 AND !busy, not DONE/BUSY
        fw[ 73] = 32'h03852583;  // lw x11, 0x38(x10) QUEUE_STAT
        fw[ 74] = 32'h00F5F593;  // andi x11, x11, 15  occupancy
        fw[ 75] = 32'hFE059CE3;  // bne x11, x0, -8   poll while queued
        fw[ 76] = 32'h00452583;  // lw x11, 0x04(x10) STATUS
        fw[ 77] = 32'h0015F593;  // andi x11, x11, 1   BUSY
        fw[ 78] = 32'hFE059CE3;  // bne x11, x0, -8   poll while busy
        fw[ 79] = 32'h00300593;
        fw[ 80] = 32'h00B52423;
        fw[ 81] = 32'h00600593;
        fw[ 82] = 32'h00B52623;
        fw[ 83] = 32'h00400593;
        fw[ 84] = 32'h00B52823;
        fw[ 85] = 32'h000085B7;
        fw[ 86] = 32'h40058593;
        fw[ 87] = 32'h00B52A23;
        fw[ 88] = 32'h000085B7;
        fw[ 89] = 32'h44058593;
        fw[ 90] = 32'h00B52C23;
        fw[ 91] = 32'h000085B7;
        fw[ 92] = 32'h48058593;
        fw[ 93] = 32'h00B52E23;
        fw[ 94] = 32'h00100593;
        fw[ 95] = 32'h00B52023;
        fw[ 96] = 32'h00600593;
        fw[ 97] = 32'h00B52423;
        fw[ 98] = 32'h00600593;
        fw[ 99] = 32'h00B52623;
        fw[100] = 32'h00400593;
        fw[101] = 32'h00B52823;
        fw[102] = 32'h000085B7;
        fw[103] = 32'h50058593;
        fw[104] = 32'h00B52A23;
        fw[105] = 32'h000085B7;
        fw[106] = 32'h54058593;
        fw[107] = 32'h00B52C23;
        fw[108] = 32'h000085B7;
        fw[109] = 32'h58058593;
        fw[110] = 32'h00B52E23;
        fw[111] = 32'h00100593;
        fw[112] = 32'h00B52023;
        // Queue-drain poll (see Test 4): occupancy==0 AND !busy, not DONE/BUSY
        fw[113] = 32'h03852583;  // lw x11, 0x38(x10) QUEUE_STAT
        fw[114] = 32'h00F5F593;  // andi x11, x11, 15  occupancy
        fw[115] = 32'hFE059CE3;  // bne x11, x0, -8   poll while queued
        fw[116] = 32'h00452583;  // lw x11, 0x04(x10) STATUS
        fw[117] = 32'h0015F593;  // andi x11, x11, 1   BUSY
        fw[118] = 32'hFE059CE3;  // bne x11, x0, -8   poll while busy
        fw[119] = 32'h0000B7B7;
        fw[120] = 32'h30078793;
        fw[121] = 32'hDEADC837;
        fw[122] = 32'hEEF80813;
        fw[123] = 32'h0107A023;
        fw[124] = 32'h0000006F;
        for (int i = 0; i < 125; i++) begin
          ddr_write_byte(i*4 + 0, fw[i][7:0]);
          ddr_write_byte(i*4 + 1, fw[i][15:8]);
          ddr_write_byte(i*4 + 2, fw[i][23:16]);
          ddr_write_byte(i*4 + 3, fw[i][31:24]);
        end
        $display("  [TB] Queue-stress firmware loaded (%0d bytes)", 125*4);
      end

      // Preload A/B operands
      // GEMM0: 2x2x4 all 1s -- A=8B @0x8000, B=8B @0x8040
      begin
        for (int i = 0; i < 8; i++)
          ddr_write_byte(32'h8000 + i, 8'd1);
        for (int i = 0; i < 8; i++)
          ddr_write_byte(32'h8040 + i, 8'd1);
      end
      // GEMM1: 3x3x4 all 1s -- A=12B @0x8100, B=12B @0x8140
      begin
        for (int i = 0; i < 12; i++)
          ddr_write_byte(32'h8100 + i, 8'd1);
        for (int i = 0; i < 12; i++)
          ddr_write_byte(32'h8140 + i, 8'd1);
      end
      // GEMM2: 4x4x4 all 1s -- A=16B @0x8200, B=16B @0x8240
      begin
        for (int i = 0; i < 16; i++)
          ddr_write_byte(32'h8200 + i, 8'd1);
        for (int i = 0; i < 16; i++)
          ddr_write_byte(32'h8240 + i, 8'd1);
      end
      // GEMM3: 5x3x4 all 1s -- A=20B @0x8300, B=12B @0x8340
      begin
        for (int i = 0; i < 20; i++)
          ddr_write_byte(32'h8300 + i, 8'd1);
        for (int i = 0; i < 12; i++)
          ddr_write_byte(32'h8340 + i, 8'd1);
      end
      // GEMM4: 3x6x4 all 1s -- A=12B @0x8400, B=24B @0x8440
      begin
        for (int i = 0; i < 12; i++)
          ddr_write_byte(32'h8400 + i, 8'd1);
        for (int i = 0; i < 24; i++)
          ddr_write_byte(32'h8440 + i, 8'd1);
      end
      // GEMM5: 6x6x4 all 1s -- A=24B @0x8500, B=24B @0x8540
      begin
        for (int i = 0; i < 24; i++)
          ddr_write_byte(32'h8500 + i, 8'd1);
        for (int i = 0; i < 24; i++)
          ddr_write_byte(32'h8540 + i, 8'd1);
      end

      // Initialize DONE_ADDR to 0
      ddr_write_byte(32'hB300, 8'h00);
      ddr_write_byte(32'hB301, 8'h00);
      ddr_write_byte(32'hB302, 8'h00);
      ddr_write_byte(32'hB303, 8'h00);

      // Reset CPU and boot
      rst_n = 1'b0;
      repeat(10) @(posedge clk);
      rst_n = 1'b1;

      // Wait for DONE_MAGIC
      begin : wait_stress
        int mg_cnt;
        mg_cnt = 0;
        forever begin
          @(posedge clk);
          mg_cnt = mg_cnt + 1;
          if (mg_cnt > 1_000_000) begin
            $error("  [FAIL] Queue-stress TIMEOUT after %0d cycles", mg_cnt);
            mg_errs = mg_errs + 1;
            disable wait_stress;
          end
          begin
            logic [7:0] b0, b1, b2, b3;
            b0 = dut.u_ddr.mem[32'hB300];
            b1 = dut.u_ddr.mem[32'hB301];
            b2 = dut.u_ddr.mem[32'hB302];
            b3 = dut.u_ddr.mem[32'hB303];
            if ({b3, b2, b1, b0} == 32'hDEADBEEF) begin
              $display("  [PASS] Queue-stress: all 6 GEMMs completed in %0d cycles", mg_cnt);
              disable wait_stress;
            end
          end
        end
      end

      // Verify C[0][0] for all 6 GEMMs
      begin
        logic [7:0] c0, c1, c2, c3;
        // GEMM0: 2x2x4 -> C[0][0] = 4
        c0 = dut.u_ddr.mem[32'h8080]; c1 = dut.u_ddr.mem[32'h8081];
        c2 = dut.u_ddr.mem[32'h8082]; c3 = dut.u_ddr.mem[32'h8083];
        $display("  [TB] GEMM0 (2x2x4) C[0][0] = 0x%08h (expect 0x00000004)", {c3, c2, c1, c0});
        if ({c3, c2, c1, c0} != 32'd4) begin
          $error("  [FAIL] GEMM0 (2x2x4) C[0][0] wrong"); mg_errs = mg_errs + 1;
        end
        // GEMM1: 3x3x4 -> C[0][0] = 4
        c0 = dut.u_ddr.mem[32'h8180]; c1 = dut.u_ddr.mem[32'h8181];
        c2 = dut.u_ddr.mem[32'h8182]; c3 = dut.u_ddr.mem[32'h8183];
        $display("  [TB] GEMM1 (3x3x4) C[0][0] = 0x%08h (expect 0x00000004)", {c3, c2, c1, c0});
        if ({c3, c2, c1, c0} != 32'd4) begin
          $error("  [FAIL] GEMM1 (3x3x4) C[0][0] wrong"); mg_errs = mg_errs + 1;
        end
        // GEMM2: 4x4x4 -> C[0][0] = 4
        c0 = dut.u_ddr.mem[32'h8280]; c1 = dut.u_ddr.mem[32'h8281];
        c2 = dut.u_ddr.mem[32'h8282]; c3 = dut.u_ddr.mem[32'h8283];
        $display("  [TB] GEMM2 (4x4x4) C[0][0] = 0x%08h (expect 0x00000004)", {c3, c2, c1, c0});
        if ({c3, c2, c1, c0} != 32'd4) begin
          $error("  [FAIL] GEMM2 (4x4x4) C[0][0] wrong"); mg_errs = mg_errs + 1;
        end
        // GEMM3: 5x3x4 -> C[0][0] = 4
        c0 = dut.u_ddr.mem[32'h8380]; c1 = dut.u_ddr.mem[32'h8381];
        c2 = dut.u_ddr.mem[32'h8382]; c3 = dut.u_ddr.mem[32'h8383];
        $display("  [TB] GEMM3 (5x3x4) C[0][0] = 0x%08h (expect 0x00000004)", {c3, c2, c1, c0});
        if ({c3, c2, c1, c0} != 32'd4) begin
          $error("  [FAIL] GEMM3 (5x3x4) C[0][0] wrong"); mg_errs = mg_errs + 1;
        end
        // GEMM4: 3x6x4 -> C[0][0] = 4
        c0 = dut.u_ddr.mem[32'h8480]; c1 = dut.u_ddr.mem[32'h8481];
        c2 = dut.u_ddr.mem[32'h8482]; c3 = dut.u_ddr.mem[32'h8483];
        $display("  [TB] GEMM4 (3x6x4) C[0][0] = 0x%08h (expect 0x00000004)", {c3, c2, c1, c0});
        if ({c3, c2, c1, c0} != 32'd4) begin
          $error("  [FAIL] GEMM4 (3x6x4) C[0][0] wrong"); mg_errs = mg_errs + 1;
        end
        // GEMM5: 6x6x4 -> C[0][0] = 4
        c0 = dut.u_ddr.mem[32'h8580]; c1 = dut.u_ddr.mem[32'h8581];
        c2 = dut.u_ddr.mem[32'h8582]; c3 = dut.u_ddr.mem[32'h8583];
        $display("  [TB] GEMM5 (6x6x4) C[0][0] = 0x%08h (expect 0x00000004)", {c3, c2, c1, c0});
        if ({c3, c2, c1, c0} != 32'd4) begin
          $error("  [FAIL] GEMM5 (6x6x4) C[0][0] wrong"); mg_errs = mg_errs + 1;
        end
      end
      total_errs = total_errs + mg_errs;
    end


    // =========================================================================
    // Test 6: Dual-NPU simultaneous GEMM
    //
    // Runs independent GEMMs on NPU0 (CSR at 0x4000_0000) and NPU1
    // (CSR at 0x4000_0040) simultaneously. Both share DDR through the
    // DMA arbiter, testing concurrent DMA arbitration.
    //
    //   NPU0: 2x2x2 INT8 all 1s -> C[0][0] = 2
    //   NPU1: 2x2x2 INT8 all 1s -> C[0][0] = 2
    // =========================================================================


    // =========================================================================
    // Test 6: Dual-NPU different-shape stress test
    //
    // Runs independent GEMMs on NPU0 (CSR at 0x4000_0000) and NPU1
    // (CSR at 0x4000_0040) simultaneously with different shapes.
    // Both share DDR through the DMA arbiter, testing concurrent DMA
    // arbitration with asymmetric operand sizes.
    //
    //   NPU0: 4x4x4 INT8 all 1s -> C[m][n] = 4 (16 elements verified)
    //   NPU1: 2x3x2 INT8 all 1s -> C[m][n] = 2 (6 elements verified)
    // =========================================================================
    $display("\n========================================");
    $display("  TEST 6: Dual-NPU different shapes (4x4x4 + 2x3x2)");
    $display("========================================");
    begin
      int mg_errs;
      mg_errs = 0;

      // Reload NPU firmware
      begin
        int fw_fd; logic [7:0] fw_byte; int fw_addr;
        fw_fd = $fopen("sw/npu_ddr_bytes.hex", "r");
        if (fw_fd != 0) begin
          fw_addr = 0;
          while (!$feof(fw_fd) && fw_addr < MEM_BYTES) begin
            if ($fscanf(fw_fd, "%2h", fw_byte) == 1) begin
              ddr_write_byte(fw_addr[31:0], fw_byte);
              fw_addr = fw_addr + 1;
            end
          end
          $fclose(fw_fd);
        end
      end

      // Load dual-NPU firmware
      begin
        logic [31:0] fw [0:55];
        fw[ 0] = 32'h40000537;
        fw[ 1] = 32'h00050513;
        fw[ 2] = 32'h40000737;
        fw[ 3] = 32'h04070713;
        fw[ 4] = 32'h00400593;
        fw[ 5] = 32'h00B52423;
        fw[ 6] = 32'h00400593;
        fw[ 7] = 32'h00B52623;
        fw[ 8] = 32'h00400593;
        fw[ 9] = 32'h00B52823;
        fw[10] = 32'h000085B7;
        fw[11] = 32'h00058593;
        fw[12] = 32'h00B52A23;
        fw[13] = 32'h000085B7;
        fw[14] = 32'h02058593;
        fw[15] = 32'h00B52C23;
        fw[16] = 32'h000085B7;
        fw[17] = 32'h04058593;
        fw[18] = 32'h00B52E23;
        fw[19] = 32'h00000593;
        fw[20] = 32'h02B52023;
        fw[21] = 32'h02052583;
        fw[22] = 32'h00100593;
        fw[23] = 32'h00B52023;
        fw[24] = 32'h00200593;
        fw[25] = 32'h00B72423;
        fw[26] = 32'h00300593;
        fw[27] = 32'h00B72623;
        fw[28] = 32'h00200593;
        fw[29] = 32'h00B72823;
        fw[30] = 32'h000085B7;
        fw[31] = 32'h10058593;
        fw[32] = 32'h00B72A23;
        fw[33] = 32'h000085B7;
        fw[34] = 32'h12058593;
        fw[35] = 32'h00B72C23;
        fw[36] = 32'h000085B7;
        fw[37] = 32'h14058593;
        fw[38] = 32'h00B72E23;
        fw[39] = 32'h00000593;
        fw[40] = 32'h02B72023;
        fw[41] = 32'h02072583;
        fw[42] = 32'h00100593;
        fw[43] = 32'h00B72023;
        fw[44] = 32'h00452583;
        fw[45] = 32'h0025F593;
        fw[46] = 32'hFE058CE3;
        fw[47] = 32'h00472583;
        fw[48] = 32'h0025F593;
        fw[49] = 32'hFE058CE3;
        fw[50] = 32'h0000B7B7;
        fw[51] = 32'h30078793;
        fw[52] = 32'hDEADC837;
        fw[53] = 32'hEEF80813;
        fw[54] = 32'h0107A023;
        fw[55] = 32'h0000006F;

        for (int i = 0; i < 56; i++) begin
          ddr_write_byte(i*4 + 0, fw[i][7:0]);
          ddr_write_byte(i*4 + 1, fw[i][15:8]);
          ddr_write_byte(i*4 + 2, fw[i][23:16]);
          ddr_write_byte(i*4 + 3, fw[i][31:24]);
        end
      end

      // Preload A for NPU0: 4x4 = 16 bytes, all 1s
      begin
        for (int i = 0; i < 16; i++) ddr_write_byte(32'h8000 + i, 8'd1);
      end
      // Preload B for NPU0: 4x4 = 16 bytes, all 1s
      begin
        for (int i = 0; i < 16; i++) ddr_write_byte(32'h8020 + i, 8'd1);
      end
      // Preload A for NPU1: 2x2 = 4 bytes, all 1s
      begin
        for (int i = 0; i < 4; i++) ddr_write_byte(32'h8100 + i, 8'd1);
      end
      // Preload B for NPU1: 2x3 = 6 bytes, all 1s
      begin
        for (int i = 0; i < 6; i++) ddr_write_byte(32'h8120 + i, 8'd1);
      end

      // Clear DONE_ADDR
      ddr_write_byte(32'hB300, 8'h00);
      ddr_write_byte(32'hB301, 8'h00);
      ddr_write_byte(32'hB302, 8'h00);
      ddr_write_byte(32'hB303, 8'h00);

      // Reset CPU and boot
      rst_n = 1'b0;
      repeat(10) @(posedge clk);
      rst_n = 1'b1;

      // Wait for DONE_MAGIC
      begin : wait_dual
        int mg_cnt;
        mg_cnt = 0;
        forever begin
          @(posedge clk);
          mg_cnt = mg_cnt + 1;
          if (mg_cnt > 500_000) begin
            $error("  [FAIL] Dual-NPU TIMEOUT");
            mg_errs = mg_errs + 1;
            disable wait_dual;
          end
          begin
            logic [7:0] b0, b1, b2, b3;
            b0 = dut.u_ddr.mem[32'hB300];
            b1 = dut.u_ddr.mem[32'hB301];
            b2 = dut.u_ddr.mem[32'hB302];
            b3 = dut.u_ddr.mem[32'hB303];
            if ({b3, b2, b1, b0} == 32'hDEADBEEF) begin
              $display("  [PASS] Dual-NPU: both GEMMs completed in %0d cycles", mg_cnt);
              disable wait_dual;
            end
          end
        end
      end

      // Verify NPU0 result: 4x4x4 -> all C = 4
      $display("  [TB] Verifying NPU0 (4x4x4) C matrix...");
      // NPU0 C[0][0]
      begin
        logic [7:0] c0, c1, c2, c3;
        c0 = dut.u_ddr.mem[32'h8040]; c1 = dut.u_ddr.mem[32'h8041];
        c2 = dut.u_ddr.mem[32'h8042]; c3 = dut.u_ddr.mem[32'h8043];
        if ({c3, c2, c1, c0} !== 32'd4) begin
          $error("  [FAIL] NPU0 C[0][0] = 0x%08h (expect 0x%08h)", {c3, c2, c1, c0}, 32'd4);
          mg_errs = mg_errs + 1;
        end else begin
          $display("  [TB] NPU0 C[0][0] = %0d OK", $signed({c3, c2, c1, c0}));
        end
      end
      // NPU0 C[0][1]
      begin
        logic [7:0] c0, c1, c2, c3;
        c0 = dut.u_ddr.mem[32'h8044]; c1 = dut.u_ddr.mem[32'h8045];
        c2 = dut.u_ddr.mem[32'h8046]; c3 = dut.u_ddr.mem[32'h8047];
        if ({c3, c2, c1, c0} !== 32'd4) begin
          $error("  [FAIL] NPU0 C[0][1] = 0x%08h (expect 0x%08h)", {c3, c2, c1, c0}, 32'd4);
          mg_errs = mg_errs + 1;
        end else begin
          $display("  [TB] NPU0 C[0][1] = %0d OK", $signed({c3, c2, c1, c0}));
        end
      end
      // NPU0 C[0][2]
      begin
        logic [7:0] c0, c1, c2, c3;
        c0 = dut.u_ddr.mem[32'h8048]; c1 = dut.u_ddr.mem[32'h8049];
        c2 = dut.u_ddr.mem[32'h804A]; c3 = dut.u_ddr.mem[32'h804B];
        if ({c3, c2, c1, c0} !== 32'd4) begin
          $error("  [FAIL] NPU0 C[0][2] = 0x%08h (expect 0x%08h)", {c3, c2, c1, c0}, 32'd4);
          mg_errs = mg_errs + 1;
        end else begin
          $display("  [TB] NPU0 C[0][2] = %0d OK", $signed({c3, c2, c1, c0}));
        end
      end
      // NPU0 C[0][3]
      begin
        logic [7:0] c0, c1, c2, c3;
        c0 = dut.u_ddr.mem[32'h804C]; c1 = dut.u_ddr.mem[32'h804D];
        c2 = dut.u_ddr.mem[32'h804E]; c3 = dut.u_ddr.mem[32'h804F];
        if ({c3, c2, c1, c0} !== 32'd4) begin
          $error("  [FAIL] NPU0 C[0][3] = 0x%08h (expect 0x%08h)", {c3, c2, c1, c0}, 32'd4);
          mg_errs = mg_errs + 1;
        end else begin
          $display("  [TB] NPU0 C[0][3] = %0d OK", $signed({c3, c2, c1, c0}));
        end
      end
      // NPU0 C[1][0]
      begin
        logic [7:0] c0, c1, c2, c3;
        c0 = dut.u_ddr.mem[32'h8050]; c1 = dut.u_ddr.mem[32'h8051];
        c2 = dut.u_ddr.mem[32'h8052]; c3 = dut.u_ddr.mem[32'h8053];
        if ({c3, c2, c1, c0} !== 32'd4) begin
          $error("  [FAIL] NPU0 C[1][0] = 0x%08h (expect 0x%08h)", {c3, c2, c1, c0}, 32'd4);
          mg_errs = mg_errs + 1;
        end else begin
          $display("  [TB] NPU0 C[1][0] = %0d OK", $signed({c3, c2, c1, c0}));
        end
      end
      // NPU0 C[1][1]
      begin
        logic [7:0] c0, c1, c2, c3;
        c0 = dut.u_ddr.mem[32'h8054]; c1 = dut.u_ddr.mem[32'h8055];
        c2 = dut.u_ddr.mem[32'h8056]; c3 = dut.u_ddr.mem[32'h8057];
        if ({c3, c2, c1, c0} !== 32'd4) begin
          $error("  [FAIL] NPU0 C[1][1] = 0x%08h (expect 0x%08h)", {c3, c2, c1, c0}, 32'd4);
          mg_errs = mg_errs + 1;
        end else begin
          $display("  [TB] NPU0 C[1][1] = %0d OK", $signed({c3, c2, c1, c0}));
        end
      end
      // NPU0 C[1][2]
      begin
        logic [7:0] c0, c1, c2, c3;
        c0 = dut.u_ddr.mem[32'h8058]; c1 = dut.u_ddr.mem[32'h8059];
        c2 = dut.u_ddr.mem[32'h805A]; c3 = dut.u_ddr.mem[32'h805B];
        if ({c3, c2, c1, c0} !== 32'd4) begin
          $error("  [FAIL] NPU0 C[1][2] = 0x%08h (expect 0x%08h)", {c3, c2, c1, c0}, 32'd4);
          mg_errs = mg_errs + 1;
        end else begin
          $display("  [TB] NPU0 C[1][2] = %0d OK", $signed({c3, c2, c1, c0}));
        end
      end
      // NPU0 C[1][3]
      begin
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
        c2 = dut.u_ddr.mem[32'h8156]; c3 = dut.u_ddr.mem[32'h8157];
        if ({c3, c2, c1, c0} !== 32'd2) begin
          $error("  [FAIL] NPU1 C[1][2] = 0x%08h (expect 0x%08h)", {c3, c2, c1, c0}, 32'd2);
          mg_errs = mg_errs + 1;
        end else begin
          $display("  [TB] NPU1 C[1][2] = %0d OK", $signed({c3, c2, c1, c0}));
        end
      end

      total_errs = total_errs + mg_errs;
    end


    // =========================================================================
    // Test 7: Dual-NPU non-trivial data test
    //
    // NPU0: 3x4x2 INT8 with signed weights/activations
    //   A = [[ 1, -2], [ 3,  1], [-1,  2]]
    //   B = [[ 2, -1,  1,  3], [ 1,  2, -1,  0]]
    //   C = [[ 0, -5,  3,  3], [ 7, -1,  2,  9], [ 0,  5, -3, -3]]
    //
    // NPU1: 2x2x3 INT8 convolution kernel
    //   A = [[1, 2, 3], [4, 5, 6]]
    //   B = [[1, 0], [0, 1], [1, 1]]
    //   C = [[ 4,  5], [10, 11]]
    //
    // Both NPUs execute simultaneously. All 16 C elements verified.
    // Includes negative values to exercise signed INT8 multiply-accumulate.
    // =========================================================================


    // =========================================================================
    // Test 7: Dual-NPU non-trivial data test
    //
    // NPU0: 3x4x2 INT8 with signed weights/activations
    //   A = [[ 1, -2], [ 3,  1], [-1,  2]]
    //   B = [[ 2, -1,  1,  3], [ 1,  2, -1,  0]]
    //   C = [[ 0, -5,  3,  3], [ 7, -1,  2,  9], [ 0,  5, -3, -3]]
    //
    // NPU1: 2x2x3 INT8 convolution kernel
    //   A = [[1, 2, 3], [4, 5, 6]]
    //   B = [[1, 0], [0, 1], [1, 1]]
    //   C = [[ 4,  5], [10, 11]]
    //
    // Both NPUs execute simultaneously. All 16 C elements verified.
    // Includes negative values to exercise signed INT8 multiply-accumulate.
    // =========================================================================
    $display("\n========================================");
    $display("  TEST 7: Dual-NPU non-trivial data (3x4x2 + 2x2x3)");
    $display("========================================");
    begin
      int mg_errs;
      mg_errs = 0;

      // Reload NPU firmware
      begin
        int fw_fd; logic [7:0] fw_byte; int fw_addr;
        fw_fd = $fopen("sw/npu_ddr_bytes.hex", "r");
        if (fw_fd != 0) begin
          fw_addr = 0;
          while (!$feof(fw_fd) && fw_addr < MEM_BYTES) begin
            if ($fscanf(fw_fd, "%2h", fw_byte) == 1) begin
              ddr_write_byte(fw_addr[31:0], fw_byte);
              fw_addr = fw_addr + 1;
            end
          end
          $fclose(fw_fd);
        end
      end

      // Load firmware
      begin
        logic [31:0] fw [0:55];
        fw[ 0] = 32'h40000537;
        fw[ 1] = 32'h00050513;
        fw[ 2] = 32'h40000737;
        fw[ 3] = 32'h04070713;
        fw[ 4] = 32'h00300593;
        fw[ 5] = 32'h00B52423;
        fw[ 6] = 32'h00400593;
        fw[ 7] = 32'h00B52623;
        fw[ 8] = 32'h00200593;
        fw[ 9] = 32'h00B52823;
        fw[10] = 32'h000095B7;
        fw[11] = 32'h80058593;
        fw[12] = 32'h00B52A23;
        fw[13] = 32'h000095B7;
        fw[14] = 32'h82058593;
        fw[15] = 32'h00B52C23;
        fw[16] = 32'h000095B7;
        fw[17] = 32'h84058593;
        fw[18] = 32'h00B52E23;
        fw[19] = 32'h00000593;
        fw[20] = 32'h02B52023;
        fw[21] = 32'h02052583;
        fw[22] = 32'h00100593;
        fw[23] = 32'h00B52023;
        fw[24] = 32'h00200593;
        fw[25] = 32'h00B72423;
        fw[26] = 32'h00200593;
        fw[27] = 32'h00B72623;
        fw[28] = 32'h00300593;
        fw[29] = 32'h00B72823;
        fw[30] = 32'h000095B7;
        fw[31] = 32'h90058593;
        fw[32] = 32'h00B72A23;
        fw[33] = 32'h000095B7;
        fw[34] = 32'h92058593;
        fw[35] = 32'h00B72C23;
        fw[36] = 32'h000095B7;
        fw[37] = 32'h94058593;
        fw[38] = 32'h00B72E23;
        fw[39] = 32'h00000593;
        fw[40] = 32'h02B72023;
        fw[41] = 32'h02072583;
        fw[42] = 32'h00100593;
        fw[43] = 32'h00B72023;
        fw[44] = 32'h00452583;
        fw[45] = 32'h0025F593;
        fw[46] = 32'hFE058CE3;
        fw[47] = 32'h00472583;
        fw[48] = 32'h0025F593;
        fw[49] = 32'hFE058CE3;
        fw[50] = 32'h0000B7B7;
        fw[51] = 32'h30078793;
        fw[52] = 32'hDEADC837;
        fw[53] = 32'hEEF80813;
        fw[54] = 32'h0107A023;
        fw[55] = 32'h0000006F;

        for (int i = 0; i < 56; i++) begin
          ddr_write_byte(i*4 + 0, fw[i][7:0]);
          ddr_write_byte(i*4 + 1, fw[i][15:8]);
          ddr_write_byte(i*4 + 2, fw[i][23:16]);
          ddr_write_byte(i*4 + 3, fw[i][31:24]);
        end
      end

      // Preload NPU0 A: 3x2 = 6 bytes (signed INT8)
        ddr_write_byte(32'h8800, 8'h01);  // A[0][0] = 1
        ddr_write_byte(32'h8801, 8'hFE);  // A[0][1] = -2
        ddr_write_byte(32'h8802, 8'h03);  // A[1][0] = 3
        ddr_write_byte(32'h8803, 8'h01);  // A[1][1] = 1
        ddr_write_byte(32'h8804, 8'hFF);  // A[2][0] = -1
        ddr_write_byte(32'h8805, 8'h02);  // A[2][1] = 2
      // Preload NPU0 B: 2x4 = 8 bytes (signed INT8)
        ddr_write_byte(32'h8820, 8'h02);  // B[0][0] = 2
        ddr_write_byte(32'h8821, 8'hFF);  // B[0][1] = -1
        ddr_write_byte(32'h8822, 8'h01);  // B[0][2] = 1
        ddr_write_byte(32'h8823, 8'h03);  // B[0][3] = 3
        ddr_write_byte(32'h8824, 8'h01);  // B[1][0] = 1
        ddr_write_byte(32'h8825, 8'h02);  // B[1][1] = 2
        ddr_write_byte(32'h8826, 8'hFF);  // B[1][2] = -1
        ddr_write_byte(32'h8827, 8'h00);  // B[1][3] = 0

      // Preload NPU1 A: 2x3 = 6 bytes (signed INT8)
        ddr_write_byte(32'h8900, 8'h01);  // A[0][0] = 1
        ddr_write_byte(32'h8901, 8'h02);  // A[0][1] = 2
        ddr_write_byte(32'h8902, 8'h03);  // A[0][2] = 3
        ddr_write_byte(32'h8903, 8'h04);  // A[1][0] = 4
        ddr_write_byte(32'h8904, 8'h05);  // A[1][1] = 5
        ddr_write_byte(32'h8905, 8'h06);  // A[1][2] = 6
      // Preload NPU1 B: 3x2 = 6 bytes (signed INT8)
        ddr_write_byte(32'h8920, 8'h01);  // B[0][0] = 1
        ddr_write_byte(32'h8921, 8'h00);  // B[0][1] = 0
        ddr_write_byte(32'h8922, 8'h00);  // B[1][0] = 0
        ddr_write_byte(32'h8923, 8'h01);  // B[1][1] = 1
        ddr_write_byte(32'h8924, 8'h01);  // B[2][0] = 1
        ddr_write_byte(32'h8925, 8'h01);  // B[2][1] = 1

      // Clear DONE_ADDR
      ddr_write_byte(32'hB300, 8'h00);
      ddr_write_byte(32'hB301, 8'h00);
      ddr_write_byte(32'hB302, 8'h00);
      ddr_write_byte(32'hB303, 8'h00);

      // Reset CPU and boot
      rst_n = 1'b0;
      repeat(10) @(posedge clk);
      rst_n = 1'b1;

      // Wait for DONE_MAGIC
      begin : wait_dual
        int mg_cnt;
        mg_cnt = 0;
        forever begin
          @(posedge clk);
          mg_cnt = mg_cnt + 1;
          if (mg_cnt > 500_000) begin
            $error("  [FAIL] Dual-NPU TIMEOUT");
            mg_errs = mg_errs + 1;
            disable wait_dual;
          end
          begin
            logic [7:0] b0, b1, b2, b3;
            b0 = dut.u_ddr.mem[32'hB300];
            b1 = dut.u_ddr.mem[32'hB301];
            b2 = dut.u_ddr.mem[32'hB302];
            b3 = dut.u_ddr.mem[32'hB303];
            if ({b3, b2, b1, b0} == 32'hDEADBEEF) begin
              $display("  [PASS] Dual-NPU: both GEMMs completed in %0d cycles", mg_cnt);
              disable wait_dual;
            end
          end
        end
      end

      // Verify NPU0 result: 3x4x2 with signed weights
      $display("  [TB] Verifying NPU0 (3x4x2) C matrix (signed INT8)...");
      // NPU0 C[0][0] = 0
      begin
        logic [7:0] c0, c1, c2, c3;
        c0 = dut.u_ddr.mem[32'h8840]; c1 = dut.u_ddr.mem[32'h8841];
        c2 = dut.u_ddr.mem[32'h8842]; c3 = dut.u_ddr.mem[32'h8843];
        if ({c3, c2, c1, c0} !== 32'h00000000) begin
          $error("  [FAIL] NPU0 C[0][0] = %0d (expect 0)", $signed({c3, c2, c1, c0}));
          mg_errs = mg_errs + 1;
        end else begin
          $display("  [TB] NPU0 C[0][0] = %0d OK", $signed({c3, c2, c1, c0}));
        end
      end
      // NPU0 C[0][1] = -5
      begin
        logic [7:0] c0, c1, c2, c3;
        c0 = dut.u_ddr.mem[32'h8844]; c1 = dut.u_ddr.mem[32'h8845];
        c2 = dut.u_ddr.mem[32'h8846]; c3 = dut.u_ddr.mem[32'h8847];
        if ({c3, c2, c1, c0} !== 32'hFFFFFFFB) begin
          $error("  [FAIL] NPU0 C[0][1] = %0d (expect -5)", $signed({c3, c2, c1, c0}));
          mg_errs = mg_errs + 1;
        end else begin
          $display("  [TB] NPU0 C[0][1] = %0d OK", $signed({c3, c2, c1, c0}));
        end
      end
      // NPU0 C[0][2] = 3
      begin
        logic [7:0] c0, c1, c2, c3;
        c0 = dut.u_ddr.mem[32'h8848]; c1 = dut.u_ddr.mem[32'h8849];
        c2 = dut.u_ddr.mem[32'h884A]; c3 = dut.u_ddr.mem[32'h884B];
        if ({c3, c2, c1, c0} !== 32'h00000003) begin
          $error("  [FAIL] NPU0 C[0][2] = %0d (expect 3)", $signed({c3, c2, c1, c0}));
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
        end
      end
      // NPU0 C[2][3] = -3
      begin
        logic [7:0] c0, c1, c2, c3;
        c0 = dut.u_ddr.mem[32'h886C]; c1 = dut.u_ddr.mem[32'h886D];
        c2 = dut.u_ddr.mem[32'h886E]; c3 = dut.u_ddr.mem[32'h886F];
        if ({c3, c2, c1, c0} !== 32'hFFFFFFFD) begin
          $error("  [FAIL] NPU0 C[2][3] = %0d (expect -3)", $signed({c3, c2, c1, c0}));
          mg_errs = mg_errs + 1;
        end else begin
          $display("  [TB] NPU0 C[2][3] = %0d OK", $signed({c3, c2, c1, c0}));
        end
      end

      // Verify NPU1 result: 2x2x3 convolution kernel
      $display("  [TB] Verifying NPU1 (2x2x3) C matrix (conv kernel)...");
      // NPU1 C[0][0] = 4
      begin
        logic [7:0] c0, c1, c2, c3;
        c0 = dut.u_ddr.mem[32'h8940]; c1 = dut.u_ddr.mem[32'h8941];
        c2 = dut.u_ddr.mem[32'h8942]; c3 = dut.u_ddr.mem[32'h8943];
        if ({c3, c2, c1, c0} !== 32'h00000004) begin
          $error("  [FAIL] NPU1 C[0][0] = %0d (expect 4)", $signed({c3, c2, c1, c0}));
          mg_errs = mg_errs + 1;
        end else begin
          $display("  [TB] NPU1 C[0][0] = %0d OK", $signed({c3, c2, c1, c0}));
        end
      end
      // NPU1 C[0][1] = 5
      begin
        logic [7:0] c0, c1, c2, c3;
        c0 = dut.u_ddr.mem[32'h8944]; c1 = dut.u_ddr.mem[32'h8945];
        c2 = dut.u_ddr.mem[32'h8946]; c3 = dut.u_ddr.mem[32'h8947];
        if ({c3, c2, c1, c0} !== 32'h00000005) begin
          $error("  [FAIL] NPU1 C[0][1] = %0d (expect 5)", $signed({c3, c2, c1, c0}));
          mg_errs = mg_errs + 1;
        end else begin
          $display("  [TB] NPU1 C[0][1] = %0d OK", $signed({c3, c2, c1, c0}));
        end
      end
      // NPU1 C[1][0] = 10
      begin
        logic [7:0] c0, c1, c2, c3;
        c0 = dut.u_ddr.mem[32'h8948]; c1 = dut.u_ddr.mem[32'h8949];
        c2 = dut.u_ddr.mem[32'h894A]; c3 = dut.u_ddr.mem[32'h894B];
        if ({c3, c2, c1, c0} !== 32'h0000000A) begin
          $error("  [FAIL] NPU1 C[1][0] = %0d (expect 10)", $signed({c3, c2, c1, c0}));
          mg_errs = mg_errs + 1;
        end else begin
          $display("  [TB] NPU1 C[1][0] = %0d OK", $signed({c3, c2, c1, c0}));
        end
      end
      // NPU1 C[1][1] = 11
      begin
        logic [7:0] c0, c1, c2, c3;
        c0 = dut.u_ddr.mem[32'h894C]; c1 = dut.u_ddr.mem[32'h894D];
        c2 = dut.u_ddr.mem[32'h894E]; c3 = dut.u_ddr.mem[32'h894F];
        if ({c3, c2, c1, c0} !== 32'h0000000B) begin
          $error("  [FAIL] NPU1 C[1][1] = %0d (expect 11)", $signed({c3, c2, c1, c0}));
          mg_errs = mg_errs + 1;
        end else begin
          $display("  [TB] NPU1 C[1][1] = %0d OK", $signed({c3, c2, c1, c0}));
        end
      end

      total_errs = total_errs + mg_errs;
    end


    // =========================================================================
    // Test 8: Dual-NPU mixed-precision (FP16 + INT8)
    //
    // NPU0: FP16 3x3x4 � values (1.0, 0.5, 2.0)
    //   A = [[1.0, 0.5, 1.0], [2.0, 1.0, 0.5], [1.0, 1.0, 2.0]]
    //   B = [[1.0, 2.0, 0.5, 1.0], [0.5, 1.0, 1.0, 0.5], [1.0, 0.5, 2.0, 1.0]]
    //   C (FP32) = [[2.25, 3.0, 3.0, 2.25], [3.0, 5.25, 3.0, 3.0], [3.5, 4.0, 5.5, 3.5]]
    //
    // NPU1: INT8 2x5x4 � includes negative weights
    //   A = [[ 1,  2, -1,  3,  0], [ 2, -1,  1,  0,  3]]
    //   B = [[ 1,  0,  2,  1], [ 0,  1,  1,  0], [ 1,  1,  0,  2], [ 0,  2,  1,  1], [ 1,  0,  0,  1]]
    //   C (INT32) = [[ 0,  7,  7,  2], [ 6,  0,  3,  7]]
    //
    // Both NPUs execute simultaneously with different precisions.
    // NPU0 uses FP16->FP32 accumulate, NPU1 uses INT8->INT32 accumulate.
    // =========================================================================


    // =========================================================================
    // Test 8: Dual-NPU mixed-precision (FP16 + INT8)
    //
    // NPU0: FP16 3x3x4 � values (1.0, 0.5, 2.0)
    //   A = [[1.0, 0.5, 1.0], [2.0, 1.0, 0.5], [1.0, 1.0, 2.0]]
    //   B = [[1.0, 2.0, 0.5, 1.0], [0.5, 1.0, 1.0, 0.5], [1.0, 0.5, 2.0, 1.0]]
    //   C (FP32) = [[2.25, 3.0, 3.0, 2.25], [3.0, 5.25, 3.0, 3.0], [3.5, 4.0, 5.5, 3.5]]
    //
    // NPU1: INT8 2x5x4 � includes negative weights
    //   A = [[ 1,  2, -1,  3,  0], [ 2, -1,  1,  0,  3]]
    //   B = [[ 1,  0,  2,  1], [ 0,  1,  1,  0], [ 1,  1,  0,  2], [ 0,  2,  1,  1], [ 1,  0,  0,  1]]
    //   C (INT32) = [[ 0,  7,  7,  2], [ 6,  0,  3,  7]]
    //
    // Both NPUs execute simultaneously with different precisions.
    // NPU0 uses FP16->FP32 accumulate, NPU1 uses INT8->INT32 accumulate.
    // =========================================================================
    $display("\n========================================");
    $display("  TEST 8: Dual-NPU mixed-precision (FP16 3x3x4 + INT8 2x5x4)");
    $display("========================================");
    begin
      int mg_errs;
      mg_errs = 0;

      // Reload NPU firmware
      begin
        int fw_fd; logic [7:0] fw_byte; int fw_addr;
        fw_fd = $fopen("sw/npu_ddr_bytes.hex", "r");
        if (fw_fd != 0) begin
          fw_addr = 0;
          while (!$feof(fw_fd) && fw_addr < MEM_BYTES) begin
            if ($fscanf(fw_fd, "%2h", fw_byte) == 1) begin
              ddr_write_byte(fw_addr[31:0], fw_byte);
              fw_addr = fw_addr + 1;
            end
          end
          $fclose(fw_fd);
        end
      end

      // Load firmware
      begin
        logic [31:0] fw [0:55];
        fw[ 0] = 32'h40000537;
        fw[ 1] = 32'h00050513;
        fw[ 2] = 32'h40000737;
        fw[ 3] = 32'h04070713;
        fw[ 4] = 32'h00300593;
        fw[ 5] = 32'h00B52423;
        fw[ 6] = 32'h00400593;
        fw[ 7] = 32'h00B52623;
        fw[ 8] = 32'h00300593;
        fw[ 9] = 32'h00B52823;
        fw[10] = 32'h000095B7;
        fw[11] = 32'h00058593;
        fw[12] = 32'h00B52A23;
        fw[13] = 32'h000095B7;
        fw[14] = 32'h02058593;
        fw[15] = 32'h00B52C23;
        fw[16] = 32'h000095B7;
        fw[17] = 32'h04058593;
        fw[18] = 32'h00B52E23;
        fw[19] = 32'h00200593;
        fw[20] = 32'h02B52023;
        fw[21] = 32'h02052583;
        fw[22] = 32'h00100593;
        fw[23] = 32'h00B52023;
        fw[24] = 32'h00200593;
        fw[25] = 32'h00B72423;
        fw[26] = 32'h00400593;
        fw[27] = 32'h00B72623;
        fw[28] = 32'h00500593;
        fw[29] = 32'h00B72823;
        fw[30] = 32'h000095B7;
        fw[31] = 32'h10058593;
        fw[32] = 32'h00B72A23;
        fw[33] = 32'h000095B7;
        fw[34] = 32'h12058593;
        fw[35] = 32'h00B72C23;
        fw[36] = 32'h000095B7;
        fw[37] = 32'h14058593;
        fw[38] = 32'h00B72E23;
        fw[39] = 32'h00000593;
        fw[40] = 32'h02B72023;
        fw[41] = 32'h02072583;
        fw[42] = 32'h00100593;
        fw[43] = 32'h00B72023;
        fw[44] = 32'h00452583;
        fw[45] = 32'h0025F593;
        fw[46] = 32'hFE058CE3;
        fw[47] = 32'h00472583;
        fw[48] = 32'h0025F593;
        fw[49] = 32'hFE058CE3;
        fw[50] = 32'h0000B7B7;
        fw[51] = 32'h30078793;
        fw[52] = 32'hDEADC837;
        fw[53] = 32'hEEF80813;
        fw[54] = 32'h0107A023;
        fw[55] = 32'h0000006F;

        for (int i = 0; i < 56; i++) begin
          ddr_write_byte(i*4 + 0, fw[i][7:0]);
          ddr_write_byte(i*4 + 1, fw[i][15:8]);
          ddr_write_byte(i*4 + 2, fw[i][23:16]);
          ddr_write_byte(i*4 + 3, fw[i][31:24]);
        end
      end

      // Preload NPU0 A (FP16 3x3 = 18 bytes)
        ddr_write_byte(32'h9000, 8'h00);  // A[0][0] low
        ddr_write_byte(32'h9001, 8'h3C);  // A[0][0] high
        ddr_write_byte(32'h9002, 8'h00);  // A[0][1] low
        ddr_write_byte(32'h9003, 8'h38);  // A[0][1] high
        ddr_write_byte(32'h9004, 8'h00);  // A[0][2] low
        ddr_write_byte(32'h9005, 8'h3C);  // A[0][2] high
        ddr_write_byte(32'h9006, 8'h00);  // A[1][0] low
        ddr_write_byte(32'h9007, 8'h40);  // A[1][0] high
        ddr_write_byte(32'h9008, 8'h00);  // A[1][1] low
        ddr_write_byte(32'h9009, 8'h3C);  // A[1][1] high
        ddr_write_byte(32'h900A, 8'h00);  // A[1][2] low
        ddr_write_byte(32'h900B, 8'h38);  // A[1][2] high
        ddr_write_byte(32'h900C, 8'h00);  // A[2][0] low
        ddr_write_byte(32'h900D, 8'h3C);  // A[2][0] high
        ddr_write_byte(32'h900E, 8'h00);  // A[2][1] low
        ddr_write_byte(32'h900F, 8'h3C);  // A[2][1] high
        ddr_write_byte(32'h9010, 8'h00);  // A[2][2] low
        ddr_write_byte(32'h9011, 8'h40);  // A[2][2] high
      // Preload NPU0 B (FP16 3x4 = 24 bytes)
        ddr_write_byte(32'h9020, 8'h00);  // B[0][0] low
        ddr_write_byte(32'h9021, 8'h3C);  // B[0][0] high
        ddr_write_byte(32'h9022, 8'h00);  // B[0][1] low
        ddr_write_byte(32'h9023, 8'h40);  // B[0][1] high
        ddr_write_byte(32'h9024, 8'h00);  // B[0][2] low
        ddr_write_byte(32'h9025, 8'h38);  // B[0][2] high
        ddr_write_byte(32'h9026, 8'h00);  // B[0][3] low
        ddr_write_byte(32'h9027, 8'h3C);  // B[0][3] high
        ddr_write_byte(32'h9028, 8'h00);  // B[1][0] low
        ddr_write_byte(32'h9029, 8'h38);  // B[1][0] high
        ddr_write_byte(32'h902A, 8'h00);  // B[1][1] low
        ddr_write_byte(32'h902B, 8'h3C);  // B[1][1] high
        ddr_write_byte(32'h902C, 8'h00);  // B[1][2] low
        ddr_write_byte(32'h902D, 8'h3C);  // B[1][2] high
        ddr_write_byte(32'h902E, 8'h00);  // B[1][3] low
        ddr_write_byte(32'h902F, 8'h38);  // B[1][3] high
        ddr_write_byte(32'h9030, 8'h00);  // B[2][0] low
        ddr_write_byte(32'h9031, 8'h3C);  // B[2][0] high
        ddr_write_byte(32'h9032, 8'h00);  // B[2][1] low
        ddr_write_byte(32'h9033, 8'h38);  // B[2][1] high
        ddr_write_byte(32'h9034, 8'h00);  // B[2][2] low
        ddr_write_byte(32'h9035, 8'h40);  // B[2][2] high
        ddr_write_byte(32'h9036, 8'h00);  // B[2][3] low
        ddr_write_byte(32'h9037, 8'h3C);  // B[2][3] high

      // Preload NPU1 A (INT8 2x5 = 10 bytes)
        ddr_write_byte(32'h9100, 8'h01);  // A[0][0] = 1
        ddr_write_byte(32'h9101, 8'h02);  // A[0][1] = 2
        ddr_write_byte(32'h9102, 8'hFF);  // A[0][2] = -1
        ddr_write_byte(32'h9103, 8'h03);  // A[0][3] = 3
        ddr_write_byte(32'h9104, 8'h00);  // A[0][4] = 0
        ddr_write_byte(32'h9105, 8'h02);  // A[1][0] = 2
        ddr_write_byte(32'h9106, 8'hFF);  // A[1][1] = -1
        ddr_write_byte(32'h9107, 8'h01);  // A[1][2] = 1
        ddr_write_byte(32'h9108, 8'h00);  // A[1][3] = 0
        ddr_write_byte(32'h9109, 8'h03);  // A[1][4] = 3
      // Preload NPU1 B (INT8 5x4 = 20 bytes)
        ddr_write_byte(32'h9120, 8'h01);  // B[0][0] = 1
        ddr_write_byte(32'h9121, 8'h00);  // B[0][1] = 0
        ddr_write_byte(32'h9122, 8'h02);  // B[0][2] = 2
        ddr_write_byte(32'h9123, 8'h01);  // B[0][3] = 1
        ddr_write_byte(32'h9124, 8'h00);  // B[1][0] = 0
        ddr_write_byte(32'h9125, 8'h01);  // B[1][1] = 1
        ddr_write_byte(32'h9126, 8'h01);  // B[1][2] = 1
        ddr_write_byte(32'h9127, 8'h00);  // B[1][3] = 0
        ddr_write_byte(32'h9128, 8'h01);  // B[2][0] = 1
        ddr_write_byte(32'h9129, 8'h01);  // B[2][1] = 1
        ddr_write_byte(32'h912A, 8'h00);  // B[2][2] = 0
        ddr_write_byte(32'h912B, 8'h02);  // B[2][3] = 2
        ddr_write_byte(32'h912C, 8'h00);  // B[3][0] = 0
        ddr_write_byte(32'h912D, 8'h02);  // B[3][1] = 2
        ddr_write_byte(32'h912E, 8'h01);  // B[3][2] = 1
        ddr_write_byte(32'h912F, 8'h01);  // B[3][3] = 1
        ddr_write_byte(32'h9130, 8'h01);  // B[4][0] = 1
        ddr_write_byte(32'h9131, 8'h00);  // B[4][1] = 0
        ddr_write_byte(32'h9132, 8'h00);  // B[4][2] = 0
        ddr_write_byte(32'h9133, 8'h01);  // B[4][3] = 1

      // Clear DONE_ADDR
      ddr_write_byte(32'hB300, 8'h00);
      ddr_write_byte(32'hB301, 8'h00);
      ddr_write_byte(32'hB302, 8'h00);
      ddr_write_byte(32'hB303, 8'h00);

      // Reset CPU and boot
      rst_n = 1'b0;
      repeat(10) @(posedge clk);
      rst_n = 1'b1;

      // Wait for DONE_MAGIC
      begin : wait_dual
        int mg_cnt;
        mg_cnt = 0;
        forever begin
          @(posedge clk);
          mg_cnt = mg_cnt + 1;
          if (mg_cnt > 500_000) begin
            $error("  [FAIL] Dual-NPU TIMEOUT");
            mg_errs = mg_errs + 1;
            disable wait_dual;
          end
          begin
            logic [7:0] b0, b1, b2, b3;
            b0 = dut.u_ddr.mem[32'hB300];
            b1 = dut.u_ddr.mem[32'hB301];
            b2 = dut.u_ddr.mem[32'hB302];
            b3 = dut.u_ddr.mem[32'hB303];
            if ({b3, b2, b1, b0} == 32'hDEADBEEF) begin
              $display("  [PASS] Dual-NPU mixed-precision: both completed in %0d cycles", mg_cnt);
              disable wait_dual;
            end
          end
        end
      end

      // Verify NPU0 result: FP16 3x3x4 -> FP32 C
      $display("  [TB] Verifying NPU0 (FP16 3x3x4) C matrix...");
      // NPU0 C[0][0] = 2.25
      begin
        logic [7:0] c0, c1, c2, c3;
        c0 = dut.u_ddr.mem[32'h9040]; c1 = dut.u_ddr.mem[32'h9041];
        c2 = dut.u_ddr.mem[32'h9042]; c3 = dut.u_ddr.mem[32'h9043];
        if ({c3, c2, c1, c0} !== 32'h40100000) begin
          $error("  [FAIL] NPU0 C[0][0] = 0x%08h (expect 0x40100000)", {c3, c2, c1, c0});
          mg_errs = mg_errs + 1;
        end else begin
          $display("  [TB] NPU0 C[0][0] = 0x%08h (expect 2.25)", {c3, c2, c1, c0});
        end
      end
      // NPU0 C[0][1] = 3.00
      begin
        logic [7:0] c0, c1, c2, c3;
        c0 = dut.u_ddr.mem[32'h9044]; c1 = dut.u_ddr.mem[32'h9045];
        c2 = dut.u_ddr.mem[32'h9046]; c3 = dut.u_ddr.mem[32'h9047];
        if ({c3, c2, c1, c0} !== 32'h40400000) begin
          $error("  [FAIL] NPU0 C[0][1] = 0x%08h (expect 0x40400000)", {c3, c2, c1, c0});
          mg_errs = mg_errs + 1;
        end else begin
          $display("  [TB] NPU0 C[0][1] = 0x%08h (expect 3.00)", {c3, c2, c1, c0});
        end
      end
      // NPU0 C[0][2] = 3.00
      begin
        logic [7:0] c0, c1, c2, c3;
        c0 = dut.u_ddr.mem[32'h9048]; c1 = dut.u_ddr.mem[32'h9049];
        c2 = dut.u_ddr.mem[32'h904A]; c3 = dut.u_ddr.mem[32'h904B];
        if ({c3, c2, c1, c0} !== 32'h40400000) begin
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
        c2 = dut.u_ddr.mem[32'h9152]; c3 = dut.u_ddr.mem[32'h9153];
        if ({c3, c2, c1, c0} !== 32'h00000006) begin
          $error("  [FAIL] NPU1 C[1][0] = %0d (expect 6)", $signed({c3, c2, c1, c0}));
          mg_errs = mg_errs + 1;
        end else begin
          $display("  [TB] NPU1 C[1][0] = %0d OK", $signed({c3, c2, c1, c0}));
        end
      end
      // NPU1 C[1][1] = 0
      begin
        logic [7:0] c0, c1, c2, c3;
        c0 = dut.u_ddr.mem[32'h9154]; c1 = dut.u_ddr.mem[32'h9155];
        c2 = dut.u_ddr.mem[32'h9156]; c3 = dut.u_ddr.mem[32'h9157];
        if ({c3, c2, c1, c0} !== 32'h00000000) begin
          $error("  [FAIL] NPU1 C[1][1] = %0d (expect 0)", $signed({c3, c2, c1, c0}));
          mg_errs = mg_errs + 1;
        end else begin
          $display("  [TB] NPU1 C[1][1] = %0d OK", $signed({c3, c2, c1, c0}));
        end
      end
      // NPU1 C[1][2] = 3
      begin
        logic [7:0] c0, c1, c2, c3;
        c0 = dut.u_ddr.mem[32'h9158]; c1 = dut.u_ddr.mem[32'h9159];
        c2 = dut.u_ddr.mem[32'h915A]; c3 = dut.u_ddr.mem[32'h915B];
        if ({c3, c2, c1, c0} !== 32'h00000003) begin
          $error("  [FAIL] NPU1 C[1][2] = %0d (expect 3)", $signed({c3, c2, c1, c0}));
          mg_errs = mg_errs + 1;
        end else begin
          $display("  [TB] NPU1 C[1][2] = %0d OK", $signed({c3, c2, c1, c0}));
        end
      end
      // NPU1 C[1][3] = 7
      begin
        logic [7:0] c0, c1, c2, c3;
        c0 = dut.u_ddr.mem[32'h915C]; c1 = dut.u_ddr.mem[32'h915D];
        c2 = dut.u_ddr.mem[32'h915E]; c3 = dut.u_ddr.mem[32'h915F];
        if ({c3, c2, c1, c0} !== 32'h00000007) begin
          $error("  [FAIL] NPU1 C[1][3] = %0d (expect 7)", $signed({c3, c2, c1, c0}));
          mg_errs = mg_errs + 1;
        end else begin
          $display("  [TB] NPU1 C[1][3] = %0d OK", $signed({c3, c2, c1, c0}));
        end
      end

      total_errs = total_errs + mg_errs;
    end

    // =========================================================================
    // Test 9: Dual-core (HART_ID + CORE1_RELEASE handshake)
    //
    // CPU0 (DDR 0x0000): reads HART_ID (expect 0), queues GEMM A (4x4x4
    //   INT8, all-1s -> C = 4), verifies all 16 C elements, writes
    //   CORE1_RELEASE = 0x4000 (CPU1 worker entry), waits for CPU1's GEMM
    //   (STATUS.busy 0->1 then 1->0), writes DONE magic to 0x9300.
    // CPU1 (boots at boot ROM 0x10020, parks polling RELEASE): jumps to
    //   DDR 0x4000, reads HART_ID (expect 1), queues GEMM B (3x3x3 INT8,
    //   all-2s -> C = 12), verifies all 9 C elements, writes 0xCAFE to
    //   0x9200.
    //
    // Exercises: shared-bus dual-core boot, HART_ID MMIO reads from both
    // cores, RELEASE register handshake, both cores programming the NPU
    // through the shared CSR (serialized via busy polling), and each core
    // verifying its own C matrix through the shared crossbar.
    // =========================================================================
    $display("\n========================================");
    $display("  TEST 9: Dual-core (HART_ID + RELEASE handshake)");
    $display("========================================");
    begin
      int dc_errs;
      dc_errs = 0;

      // Load dual-core firmware into DDR (0x0000 CPU0 + 0x4000 CPU1)
      begin
        int fw_fd; logic [7:0] fw_byte; int fw_addr;
        fw_fd = $fopen("sw/dualcore_ddr_bytes.hex", "r");
        if (fw_fd != 0) begin
          fw_addr = 0;
          while (!$feof(fw_fd) && fw_addr < MEM_BYTES) begin
            if ($fscanf(fw_fd, "%2h", fw_byte) == 1) begin
              ddr_write_byte(fw_addr[31:0], fw_byte);
              fw_addr = fw_addr + 1;
            end
          end
          $fclose(fw_fd);
        end
      end

      // GEMM A operands: 4x4x4 INT8, all-1s (A 16B @0x8000, B 16B @0x8400)
      for (int i = 0; i < 16; i++) begin
        ddr_write_byte(32'h8000 + i, 8'h01);
        ddr_write_byte(32'h8400 + i, 8'h01);
      end
      // GEMM B operands: 3x3x3 INT8, all-2s (A 9B @0xA000, B 9B @0xA400)
      for (int i = 0; i < 9; i++) begin
        ddr_write_byte(32'hA000 + i, 8'h02);
        ddr_write_byte(32'hA400 + i, 8'h02);
      end

      // Clear status/mailbox region (0x9100-0x9300)
      for (int i = 0; i < 32; i++)
        ddr_write_byte(32'h9100 + i, 8'h00);
      for (int i = 0; i < 8; i++)
        ddr_write_byte(32'h9200 + i, 8'h00);
      for (int i = 0; i < 8; i++)
        ddr_write_byte(32'h9300 + i, 8'h00);

      // Reset CPU and boot
      rst_n = 1'b0;
      repeat(10) @(posedge clk);
      rst_n = 1'b1;

      // Wait for CPU0 DONE magic
      begin : wait_dc
        int dc_cnt;
        dc_cnt = 0;
        forever begin
          @(posedge clk);
          dc_cnt = dc_cnt + 1;
          if (dc_cnt > 500_000) begin
            $error("  [FAIL] Dual-core TIMEOUT");
            dc_errs = dc_errs + 1;
            disable wait_dc;
          end

          begin
            logic [7:0] b0, b1, b2, b3;
            b0 = dut.u_ddr.mem[32'h9300];
            b1 = dut.u_ddr.mem[32'h9301];
            b2 = dut.u_ddr.mem[32'h9302];
            b3 = dut.u_ddr.mem[32'h9303];
            if ({b3, b2, b1, b0} == 32'hDEADBEEF) begin
              $display("  [PASS] Dual-core: both cores completed in %0d cycles", dc_cnt);
              disable wait_dc;
            end
          end
        end
      end

      // HART_ID checks (both cores read the same register, get own ID)
      begin
        logic [7:0] b0, b1, b2, b3;
        b0 = dut.u_ddr.mem[32'h9100]; b1 = dut.u_ddr.mem[32'h9101];
        b2 = dut.u_ddr.mem[32'h9102]; b3 = dut.u_ddr.mem[32'h9103];
        if ({b3, b2, b1, b0} !== 32'h00000000) begin
          $error("  [FAIL] CPU0 HART_ID = %0d (expect 0)", {b3, b2, b1, b0});
          dc_errs = dc_errs + 1;
        end else begin
          $display("  [TB] CPU0 HART_ID = 0 OK");
        end
        b0 = dut.u_ddr.mem[32'h9108]; b1 = dut.u_ddr.mem[32'h9109];
        b2 = dut.u_ddr.mem[32'h910A]; b3 = dut.u_ddr.mem[32'h910B];
        if ({b3, b2, b1, b0} !== 32'h00000001) begin
          $error("  [FAIL] CPU1 HART_ID = %0d (expect 1)", {b3, b2, b1, b0});
          dc_errs = dc_errs + 1;
        end else begin
          $display("  [TB] CPU1 HART_ID = 1 OK");
        end
      end

      // On-core C-verify error masks (0 = all elements matched)
      begin
        logic [7:0] b0, b1, b2, b3;
        b0 = dut.u_ddr.mem[32'h9104]; b1 = dut.u_ddr.mem[32'h9105];
        b2 = dut.u_ddr.mem[32'h9106]; b3 = dut.u_ddr.mem[32'h9107];
        if ({b3, b2, b1, b0} !== 32'h00000000) begin
          $error("  [FAIL] CPU0 C-verify mask = %08h (expect 0)", {b3, b2, b1, b0});
          dc_errs = dc_errs + 1;
        end else begin
          $display("  [TB] CPU0 GEMM A all 16 elements == 4 OK");
        end
        b0 = dut.u_ddr.mem[32'h910C]; b1 = dut.u_ddr.mem[32'h910D];
        b2 = dut.u_ddr.mem[32'h910E]; b3 = dut.u_ddr.mem[32'h910F];
        if ({b3, b2, b1, b0} !== 32'h00000000) begin
          $error("  [FAIL] CPU1 C-verify mask = %08h (expect 0)", {b3, b2, b1, b0});
          dc_errs = dc_errs + 1;
        end else begin
          $display("  [TB] CPU1 GEMM B all 9 elements == 12 OK");
        end
      end

      // CPU1 completion mailbox.  CPU1's store goes through the write-through
      // D-cache -> crossbar -> DDR and may still be in flight the moment CPU0's
      // DEADBEEF is detected (both cores finish back-to-back), so poll the
      // mailbox with a bounded timeout instead of reading DDR immediately.
      begin
        logic [7:0] b0, b1, b2, b3;
        int mb_cnt;
        logic mb_ok;
        mb_ok = 1'b0;
        mb_cnt = 0;
        while (!mb_ok && mb_cnt < 50_000) begin
          @(posedge clk);
          mb_cnt = mb_cnt + 1;
          b0 = dut.u_ddr.mem[32'h9200]; b1 = dut.u_ddr.mem[32'h9201];
          b2 = dut.u_ddr.mem[32'h9202]; b3 = dut.u_ddr.mem[32'h9203];
          if ({b3, b2, b1, b0} === 32'h0000CAFE)
            mb_ok = 1'b1;
        end
        if (!mb_ok) begin
          $error("  [FAIL] CPU1 mailbox = %08h (expect 0xCAFE)", {b3, b2, b1, b0});
          dc_errs = dc_errs + 1;
        end else begin
          $display("  [TB] CPU1 completion mailbox = 0xCAFE OK (after %0d cyc)", mb_cnt);
        end
      end

      // TB-side C readbacks (independent of on-core verification)
      $display("  [TB] Verifying GEMM A C matrix (16 x 4)...");
      for (int i = 0; i < 16; i++) begin
        logic [7:0] c0, c1, c2, c3;
        c0 = dut.u_ddr.mem[32'h8800 + i*4];
        c1 = dut.u_ddr.mem[32'h8800 + i*4 + 1];
        c2 = dut.u_ddr.mem[32'h8800 + i*4 + 2];
        c3 = dut.u_ddr.mem[32'h8800 + i*4 + 3];
        if ({c3, c2, c1, c0} !== 32'h00000004) begin
          $error("  [FAIL] GEMM A C[%0d] = %0d (expect 4)", i, $signed({c3, c2, c1, c0}));
          dc_errs = dc_errs + 1;
        end
      end
      $display("  [TB] Verifying GEMM B C matrix (9 x 12)...");
      for (int i = 0; i < 9; i++) begin
        logic [7:0] c0, c1, c2, c3;
        c0 = dut.u_ddr.mem[32'hA800 + i*4];
        c1 = dut.u_ddr.mem[32'hA800 + i*4 + 1];
        c2 = dut.u_ddr.mem[32'hA800 + i*4 + 2];
        c3 = dut.u_ddr.mem[32'hA800 + i*4 + 3];
        if ({c3, c2, c1, c0} !== 32'h0000000C) begin
          $error("  [FAIL] GEMM B C[%0d] = %0d (expect 12)", i, $signed({c3, c2, c1, c0}));
          dc_errs = dc_errs + 1;
        end
      end

      total_errs = total_errs + dc_errs;
    end
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
