kubeworkz/grx930/c930/rtl/c930_l2.sv

// -----------------------------------------------------------------------------
// c930_l2.sv - Shared L2 cache + coherence directory (MSI-lite, write-through).
//
// Sits between the AXI crossbar's DDR slave port (s1) and the DDR.  It is the
// point of coherence for the four RV64IMAC cores.  Because the per-core L1
// data caches are WRITE-THROUGH (they never hold dirty data), the protocol is
// a simplified MSI with no Modified state:
//
//   * Every L1 line is a clean copy of an L2 line, EXCEPT between a
//     write-through and the writer's next miss: the writer's L1 then holds data
//     this L2 does not.  dir_mem is what keeps the directory honest across that
//     window -- the tag and sharer vector outlive valid_mem, so a later write to
//     the line still finds the writer and invalidates it.  Without it the writer
//     read its own stale copy for as long as the line survived.
//   * Every L1 line is a clean copy of an L2 line.  The L2 directory records
//     which L1s hold each line (a 16-bit sharer vector indexed by SOURCE_ID,
//     see c930_soc_top.sv for the source-id map).
//   * Read fill (32B line, AXI len==3, from an L1): allocate in the L2, record
//     the requesting L1 as a sharer.  Every other read bypasses the cache and
//     goes straight to DDR -- any other length, and any read from a source
//     with no invalidation port, such as an NPU DMA row or operand read that
//     happens to be exactly one aligned line long.
//   * Write: write-through to DDR, NO allocate.  Before the write becomes
//     visible, every L1 sharer of the line is invalidated (asserted on the
//     per-L1 invalidation ports until acked).  The L2 copy is dropped.
//   * Eviction: before a victim line is dropped, all L1 sharers are
//     invalidated, so no L1 can hold a line that is no longer tracked.
//     (L1s ack invalidations even while busy - "clear before next use" - so
//     this wait can never deadlock against an in-flight L1 fill.)
//   * A fill that raced a write (AR issued before the write's AW, fill data
//     returns after) is discarded and re-issued once the write completes, so
//     an L1 can never consume pre-write data.  Detected via the write log:
//     every accepted write is logged with a sequence number; a fill re-checks
//     the log at data-return and retries if any write to its line was
//     accepted at or after its AR.  Because the write path serializes one
//     transaction at a time, at most one log entry is in flight, so a fill
//     can wait for the raced write's completion without the entry wrapping.
//
// The read and write paths are INDEPENDENT FSMs (like the crossbar's), so a
// write waiting on an L1 invalidation ack can never block an L1's pending
// fill and vice versa.
//
// Structure: 4-way set-associative, 512 sets x 32B lines = 64 KB.
//   tag[way][set], valid[way][set], data[way][set][4 x 64b],
//   sharers[way][set][15:0], victim round-robin counter per set.
// -----------------------------------------------------------------------------

module c930_l2
#(
  parameter int ADDR_WIDTH = 64,
  parameter int DATA_WIDTH = 64,      // AXI data width at both ports
  parameter int ID_WIDTH   = 4,
  parameter int LINE_BYTES = 32,      // must match the L1 line size
  parameter int NUM_SETS   = 512,
  parameter int NUM_WAYS   = 4,
  parameter int NUM_SRC    = 16,      // SOURCE_ID space
  parameter int INV_PORTS  = 8,       // L1 caches (I0,D0,I1,D1,I2,D2,I3,D3)
  parameter int WR_LOG_DEPTH = 8
)
(
  input  logic                        i_clk,
  input  logic                        i_rst_n,

  // ---- AXI4 slave (crossbar s1: all DDR traffic) ----
  input  logic [ID_WIDTH-1:0]         s_awid,
  input  logic [ADDR_WIDTH-1:0]       s_awaddr,
  input  logic [7:0]                  s_awlen,
  input  logic [2:0]                  s_awsize,
  input  logic [1:0]                  s_awburst,
  input  logic                        s_awvalid,
  output logic                        s_awready,
  input  logic [DATA_WIDTH-1:0]       s_wdata,
  input  logic [DATA_WIDTH/8-1:0]     s_wstrb,
  input  logic                        s_wlast,
  input  logic                        s_wvalid,
  output logic                        s_wready,
  output logic [ID_WIDTH-1:0]         s_bid,
  output logic [1:0]                  s_bresp,
  output logic                        s_bvalid,
  input  logic                        s_bready,
  input  logic [ID_WIDTH-1:0]         s_arid,
  input  logic [ADDR_WIDTH-1:0]       s_araddr,
  input  logic [7:0]                  s_arlen,
  input  logic [2:0]                  s_arsize,
  input  logic [1:0]                  s_arburst,
  input  logic                        s_arvalid,
  output logic                        s_arready,
  output logic [ID_WIDTH-1:0]         s_rid,
  output logic [DATA_WIDTH-1:0]       s_rdata,
  output logic [1:0]                  s_rresp,
  output logic                        s_rlast,
  output logic                        s_rvalid,
  input  logic                        s_rready,

  // ---- AXI4 master (DDR) ----
  output logic [ID_WIDTH-1:0]         m_awid,
  output logic [ADDR_WIDTH-1:0]       m_awaddr,
  output logic [7:0]                  m_awlen,
  output logic [2:0]                  m_awsize,
  output logic [1:0]                  m_awburst,
  output logic                        m_awvalid,
  input  logic                        m_awready,
  output logic [DATA_WIDTH-1:0]       m_wdata,
  output logic [DATA_WIDTH/8-1:0]     m_wstrb,
  output logic                        m_wlast,
  output logic                        m_wvalid,
  input  logic                        m_wready,
  input  logic [ID_WIDTH-1:0]         m_bid,
  input  logic [1:0]                  m_bresp,
  input  logic                        m_bvalid,
  output logic                        m_bready,
  output logic [ID_WIDTH-1:0]         m_arid,
  output logic [ADDR_WIDTH-1:0]       m_araddr,
  output logic [7:0]                  m_arlen,
  output logic [2:0]                  m_arsize,
  output logic [1:0]                  m_arburst,
  output logic                        m_arvalid,
  input  logic                        m_arready,
  input  logic [ID_WIDTH-1:0]         m_rid,
  input  logic [DATA_WIDTH-1:0]       m_rdata,
  input  logic [1:0]                  m_rresp,
  input  logic                        m_rlast,
  input  logic                        m_rvalid,
  output logic                        m_rready,

  // ---- L1 invalidation ports (one per cache, see INV_SRC map) ----
  output logic [INV_PORTS-1:0]        o_inv_valid,
  output logic [ADDR_WIDTH-1:0]       o_inv_addr,
  input  logic [INV_PORTS-1:0]        i_inv_ack
);

  // ---------------------------------------------------------------------------
  // Derived constants
  // ---------------------------------------------------------------------------
  localparam int WORDS_PER_LINE = LINE_BYTES / (DATA_WIDTH/8);   // 4
  localparam int SET_BITS   = $clog2(NUM_SETS);                  // 9
  localparam int WAY_BITS   = $clog2(NUM_WAYS) < 1 ? 1 : $clog2(NUM_WAYS);  // 2
  localparam int OFF_BITS   = $clog2(LINE_BYTES);                // 5
  localparam int TAG_BITS   = ADDR_WIDTH - SET_BITS - OFF_BITS;  // 50

  // SOURCE_ID -> invalidation port map (see c930_soc_top.sv).
  //   0: CPU0-I   1: CPU0-D
  //   4: CPU1-I   5: CPU1-D   6: CPU2-I   7: CPU2-D   (via arb1)
  //   8: NPU0     9: NPU1    10: CPU3-I  11: CPU3-D   (via dma arb)
  // Ports are {I0,D0,I1,D1,I2,D2,I3,D3}.
  logic [INV_PORTS-1:0] inv_port_of_src [0:NUM_SRC-1];
  always_comb begin
    for (int s = 0; s < NUM_SRC; s++)
      inv_port_of_src[s] = '0;
    inv_port_of_src[0]  = 8'b0000_0001;
    inv_port_of_src[1]  = 8'b0000_0010;
    inv_port_of_src[4]  = 8'b0000_0100;
    inv_port_of_src[5]  = 8'b0000_1000;
    inv_port_of_src[6]  = 8'b0001_0000;
    inv_port_of_src[7]  = 8'b0010_0000;
    inv_port_of_src[10] = 8'b0100_0000;
    inv_port_of_src[11] = 8'b1000_0000;
  end

  function automatic logic [INV_PORTS-1:0] inv_mask_of_sharers(
      input logic [NUM_SRC-1:0] sharers);
    logic [INV_PORTS-1:0] m;
    m = '0;
    for (int s = 0; s < NUM_SRC; s++)
      if (sharers[s]) m |= inv_port_of_src[s];
    inv_mask_of_sharers = m;
  endfunction

  // ---------------------------------------------------------------------------
  // Storage
  // ---------------------------------------------------------------------------
  // Tag storage: NUM_WAYS independent 2-D distributed-RAM banks (one per
  // way) exposed through the tag_mem wire alias below.  As flops this was
  // NUM_WAYS*NUM_SETS*TAG_BITS = 105K registers whose 512:1 read muxes cost
  // ~200K LUTs (the MUXF7/F8 storm); as LUTRAM it is ~2K LUT-equivalents.
  // Both reads are asynchronous (rd-hit compare on the incoming s_araddr at
  // RD_IDLE, wr-hit compare on s_awaddr at WR_IDLE), and the only write is
  // the RD_ALLOC tag update - so distributed RAM (async read) is the right
  // primitive.  valid_mem stays in flops: it needs the bulk reset flush and
  // is only 4x512 bits, and it gates every tag compare, so X-init of the
  // banks is harmless (no hit until a line is allocated).
  genvar gt, gs;
  generate
    for (gt = 0; gt < NUM_WAYS; gt++) begin : g_tag
      (* ram_style = "distributed" *)
      logic [TAG_BITS-1:0] tag_bank [0:NUM_SETS-1];
      always_ff @(posedge i_clk) begin
        if (rd_state == RD_ALLOC && !rd_hit && rd_way == gt[WAY_BITS-1:0])
          tag_bank[rd_set] <= rd_tag;
      end
    end
    for (gt = 0; gt < NUM_WAYS; gt++)
      for (gs = 0; gs < NUM_SETS; gs++)
        assign tag_mem[gt][gs] = g_tag[gt].tag_bank[gs];
  endgenerate
  wire [TAG_BITS-1:0]            tag_mem    [0:NUM_WAYS-1][0:NUM_SETS-1];
  logic                          valid_mem  [0:NUM_WAYS-1][0:NUM_SETS-1];
  // The directory's own validity, separate from the data's.  A write-through
  // leaves the L2 without the line's data but with an L1 that still holds it, so
  // the tag and the sharer vector have to outlive valid_mem or the next write to
  // the line invalidates nobody.  Set wherever valid_mem is set; kept when a
  // write-through clears it.
  logic                          dir_mem    [0:NUM_WAYS-1][0:NUM_SETS-1];
  // Line data storage: one simple-dual-port BRAM per (way, word) - 16 total
  // for the default geometry.  As flops this array alone is
  // NUM_WAYS*NUM_SETS*WORDS_PER_LINE*DATA_WIDTH = 524,288 FFs (4x the
  // xc7a200t's entire FF budget); as block RAM it is 16 RAMB36s of 365
  // available.  Access pattern (checked against both FSMs):
  //   * reads: RD_LOOKUP hit-capture and the RD_HIT_SERVE prime - both consume
  //     the line addressed by the AR accepted in the previous cycle;
  //   * write: RD_ALLOC only, one beat-word each, address registered two
  //     cycles earlier;
  //   * the write FSM never touches data_mem (write-through, no allocate).
  // So the read-issue cycle (RD_IDLE) never overlaps the write cycle
  // (RD_ALLOC) and the mapping is race-free.
  // Registered BRAM read outputs: all ways/words of the AR-addressed set are
  // read at AR-accept (RD_IDLE); outputs are stable during RD_LOOKUP, where
  // the registered hit way selects them.  Timing is identical to the
  // pre-BRAM code: the old code read data_mem during the RD_LOOKUP cycle and
  // registered it into rd_stage/rd_serve_q at the same edge at which this
  // pipeline delivers the same value.
  //
  // The storage itself is NUM_WAYS*WORDS_PER_LINE independent simple-dual-port
  // banks (one per (way, word) plane) instead of one 3-D array: Vivado cannot
  // map a [way][set][word] array to BRAM (Synth 8-11357 "3D-RAM" warning; the
  // array silently falls back to 524,288 registers), but each 2-D
  // NUM_SETS x DATA_WIDTH plane infers one RAMB36.  Write priority over read
  // on the shared clock edge is the standard SDP behaviour; the two events
  // never coincide anyway (RD_IDLE read issue vs RD_ALLOC write, disjoint
  // FSM states).
  logic [DATA_WIDTH-1:0] data_q [0:NUM_WAYS-1][0:WORDS_PER_LINE-1];

  genvar gw, gb;
  generate
    for (gw = 0; gw < NUM_WAYS; gw++) begin : g_way
      for (gb = 0; gb < WORDS_PER_LINE; gb++) begin : g_word
        (* ram_style = "block" *)
        logic [DATA_WIDTH-1:0] bank [0:NUM_SETS-1];
        always_ff @(posedge i_clk) begin
          if (rd_state == RD_ALLOC && rd_way == gw)
            bank[rd_set] <= rd_stage[gb];
          data_q[gw][gb] <= bank[s_araddr[OFF_BITS +: SET_BITS]];  // read port: next-cycle RD_LOOKUP data
        end
      end
    end
  endgenerate
  logic [NUM_SRC-1:0]            sharers    [0:NUM_WAYS-1][0:NUM_SETS-1];
  logic [WAY_BITS-1:0]           victim_cnt [0:NUM_SETS-1];

  integer i, j;
  initial begin
    for (i = 0; i < NUM_WAYS; i++)
      for (j = 0; j < NUM_SETS; j++) begin
        valid_mem[i][j] = 1'b0;
        dir_mem[i][j]   = 1'b0;
        sharers[i][j]   = '0;
      end
    // Round-robin victim pointers must start defined (X indices on first
    // miss would silently drop every allocation and force refill loops).
    for (j = 0; j < NUM_SETS; j++)
      victim_cnt[j] = '0;
    // Write-log entries start invalid (see wr_log_match_idx note).
    for (j = 0; j < WR_LOG_DEPTH; j++) begin
      wr_log_valid[j] = 1'b0;
      wr_log_done[j]  = 1'b1;   // nothing pending
    end
  end

  // ---------------------------------------------------------------------------
  // Write log: {line, seq, done} - detects fill/write races
  // ---------------------------------------------------------------------------
  logic [ADDR_WIDTH-1:0]  wr_log_line [0:WR_LOG_DEPTH-1];
  logic [7:0]             wr_log_seq  [0:WR_LOG_DEPTH-1];
  logic                   wr_log_done [0:WR_LOG_DEPTH-1];
  logic                   wr_log_valid [0:WR_LOG_DEPTH-1];
  logic [7:0]             wr_log_head;   // next entry to write
  logic [7:0]             wr_seq;        // monotonic write sequence
  logic                   wr_log_full;

  assign wr_log_full = (wr_seq - wr_log_head) >= WR_LOG_DEPTH;

  // Index of the FIRST log entry for 'line' with seq >= seq_floor, or -1.
  // Empty entries (never allocated) are invalid and can NEVER match -- a
  // zero-initialized {line=0, seq=0} entry would otherwise false-match the
  // very first refill to line 0 at seq_floor=0 and hang the read FSM waiting
  // for a write that never happened (Icarus started these arrays as X so
  // never matched; Verilator starts them as 0).
  function automatic int wr_log_match_idx(input logic [ADDR_WIDTH-1:0] line,
                                          input logic [7:0] seq_floor);
    for (int e = 0; e < WR_LOG_DEPTH; e++)
      if (wr_log_valid[e] && wr_log_line[e] == line && wr_log_seq[e] >= seq_floor)
        wr_log_match_idx = e;
    wr_log_match_idx = -1;
  endfunction

  // ===========================================================================
  // READ PATH (independent FSM)
  // ===========================================================================
  localparam logic [3:0] RD_IDLE       = 4'd0;
  localparam logic [3:0] RD_LOOKUP     = 4'd1;
  localparam logic [3:0] RD_EVICT_INV  = 4'd2;
  localparam logic [3:0] RD_BYPASS_AR  = 4'd3;
  localparam logic [3:0] RD_BYPASS_R   = 4'd4;
  localparam logic [3:0] RD_REFILL_AR  = 4'd5;
  localparam logic [3:0] RD_REFILL_R   = 4'd6;
  localparam logic [3:0] RD_REFILL_CHK = 4'd7;
  localparam logic [3:0] RD_HIT_SERVE  = 4'd8;
  localparam logic [3:0] RD_ALLOC      = 4'd9;
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
